EdoardoBaggio03/ControlloSerra/Immagini Tesi/Foto/DSC_0372.JPG

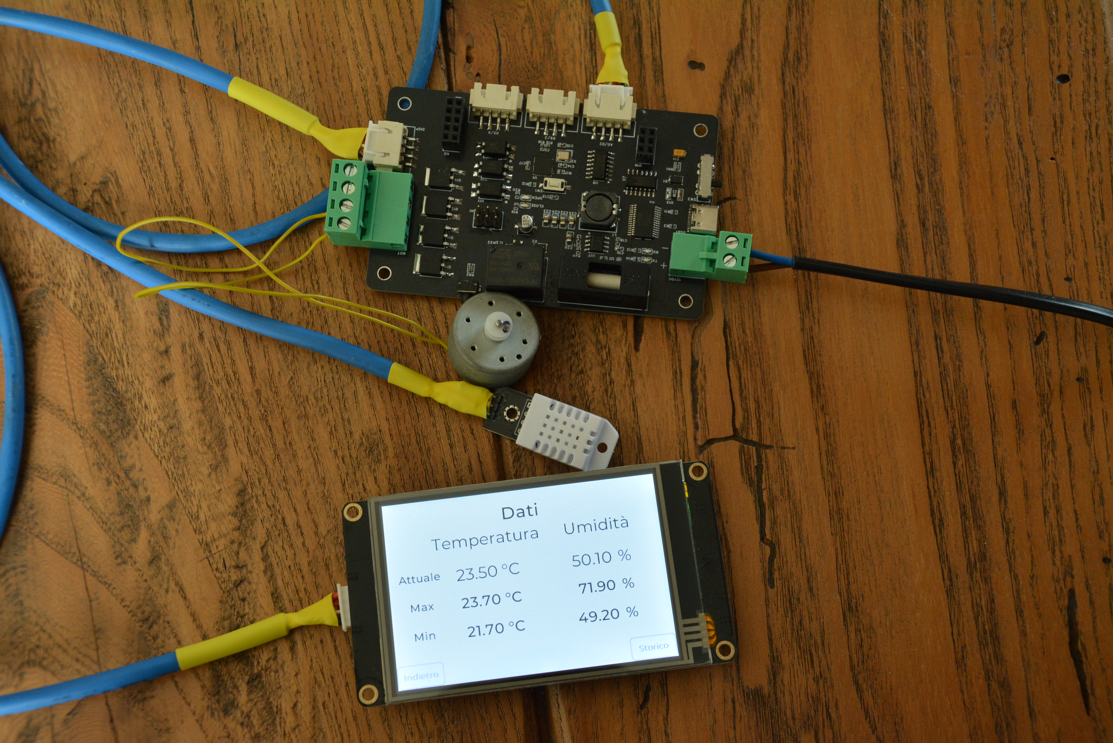
Immagini Tesi/Foto/DSC_0372.JPG
