EdoardoBaggio03/ControlloSerra/Immagini Tesi/Foto/IMG_0029.jpeg

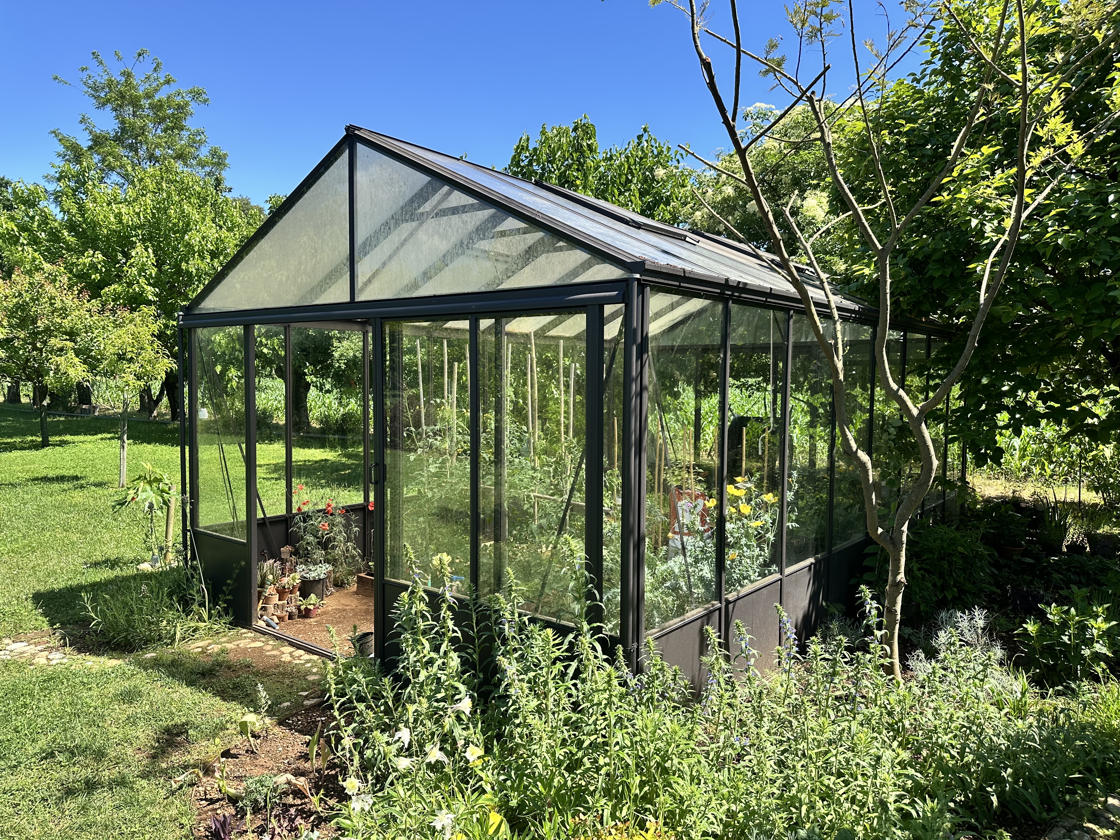
Immagini Tesi/Foto/IMG_0029.jpeg
