EdoardoBaggio03/ControlloSerra/template ITA slides_lauree triennali.pdf

Università degli Studi di Padova – Dipartimento di Ingegneria dell’Informazione
Corso di Laurea in |
Attenzione non mettere nome curriculum!!!!!

## Relazione per la prova finale «Titolo elaborato»

Relatore: Prof. …….
Correlatore: Prof./Dott. |
Laureand..: |
Matricola n.: |

Padova, …/…/202…….

INTRODUZIONE

OBIETTIVO DEL LAVORO

DESCRIZIONE DEL LAVORO

CONCLUSIONI
