EdoardoBaggio03/ControlloSerra/template-tesi-unipd-dei.pdf

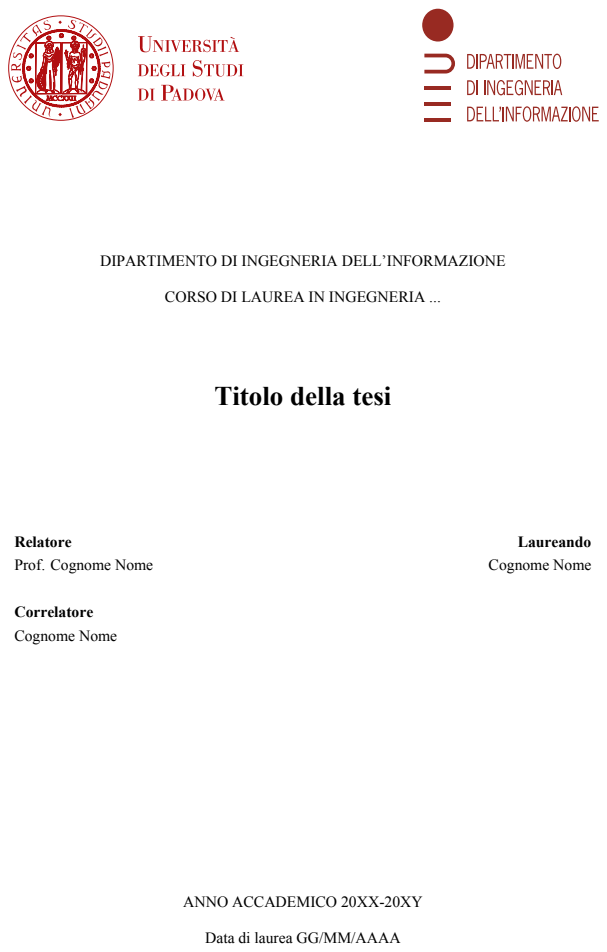
[picture p81: page 1]
Relatore; Laureando; Prof. Cognome Nome; Cognome Nome; Correlatore; ANNO ACCADEMICO 20XX-20XY

DIPARTIMENTO DI INGEGNERIA DELL’INFORMAZIONE

CORSO DI LAUREA IN INGEGNERIA ...

Titolo della tesi

Data di laurea GG/MM/AAAA

Apes. Together. Strong.

# Sommario

Descrizione dell’obiettivo della tesi.

v

vi

# Indice

1 Capitolo di prova | 1
Bibliografia | 3

vii

viii

# Elenco delle figure

ix

x

# Capitolo 1

# Capitolo di prova

Questo capitolo può servire come riferimento per alcuni comandi utili di LATEX.

## 1.1 Esempio di sezione

### 1.1.1 Esempio di sottosezione

The Lord of the Rings is one of these things: if you like it, you do;
if you don’t, then you boo! (J. R. R. Tolkien)

Questa qui sopra è una citazione. Bella, vero?
Questo è un riferimento: [1].
Questa è un’espressione matematica in riga: y = f(x). Questa è un’espressione matematica in un blocco a sé:
∫︂∞

−∞

e

−x

2
dx =

√
π | (1.1)

Questo è codice in riga: for(int i = 0; i < 1; i++);. Questo è un listato semplice,

estratto da The C programming language (1988), p. 6:

## #include <stdio.h>

## main( )

{
printf("hello, world\n");
}

1

Questo è un listato sbrilluccicoso:

## # can your editor do this? f(x) = m +

∑︂∞

k=1

Ak cos(kx − ϕk)

## import this

## print('hello, world')

2

# Bibliografia

[1] L. Lamport, LaTeX: A Document Preparation System. Addison-Wesley Publishing Company, 1986, isbn: 9780201157901.

3
