EdoardoBaggio03/ControlloSerra/3D/Case_PCB_2025-May-06_02-36-45PM-000_CustomizedView4439397485.png

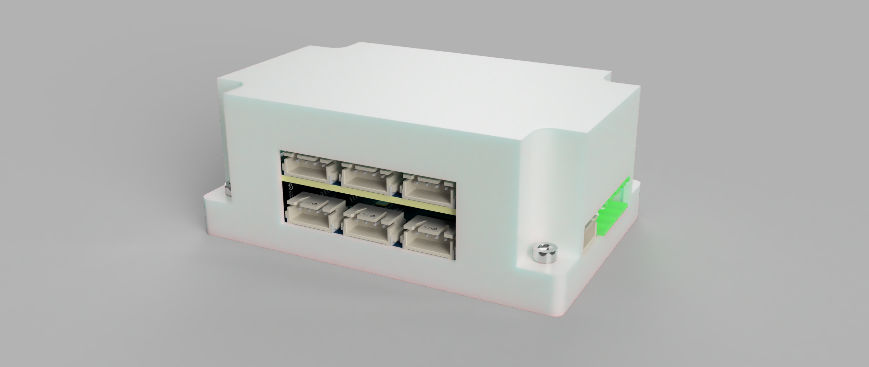
3D/Case_PCB_2025-May-06_02-36-45PM-000_CustomizedView4439397485.png
