EdoardoBaggio03/ControlloSerra/Display/Bottone Impostazioni.png

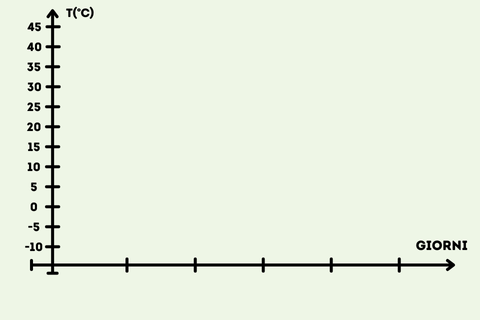
Display/Bottone Impostazioni.png
