EdoardoBaggio03/ControlloSerra/Display/Bottoni/63.png

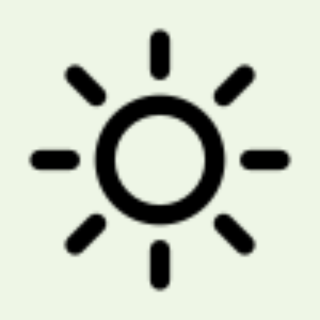
Display/Bottoni/63.png
