EdoardoBaggio03/ControlloSerra/Display/Bottoni/64.png

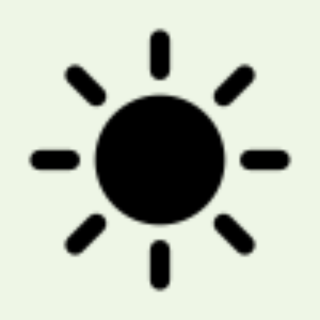
Display/Bottoni/64.png
