EdoardoBaggio03/ControlloSerra/Display/Bottoni/Bottone Dati.png

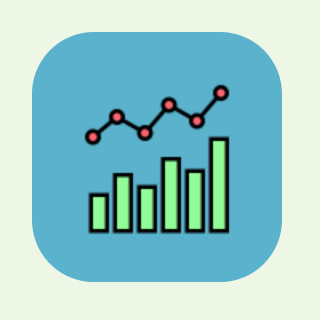
Display/Bottoni/Bottone Dati.png
