EdoardoBaggio03/ControlloSerra/Display/Bottoni/Bottone Home.png

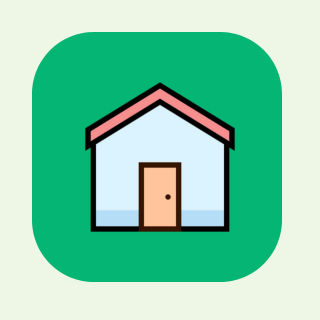
Display/Bottoni/Bottone Home.png
