EdoardoBaggio03/ControlloSerra/Display/Bottoni/Bottone Impostazioni.png

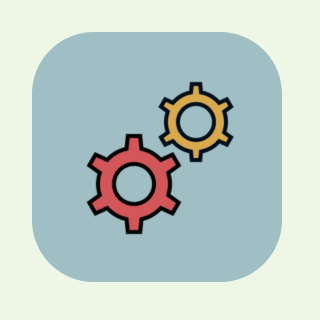
Display/Bottoni/Bottone Impostazioni.png
