EdoardoBaggio03/ControlloSerra/Display/Bottoni/Bottone Info.png

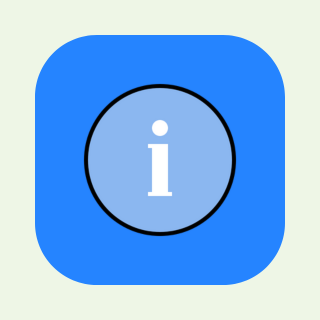
Display/Bottoni/Bottone Info.png
