EdoardoBaggio03/ControlloSerra/Display/Bottoni/Bottone Menu.png

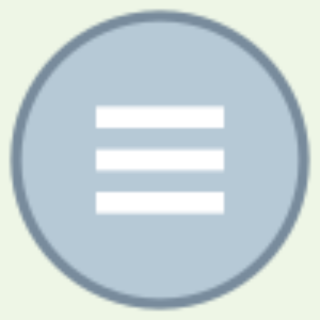
Display/Bottoni/Bottone Menu.png
