EdoardoBaggio03/ControlloSerra/Display/Bottoni/Bottone Occhio Chiuso.png

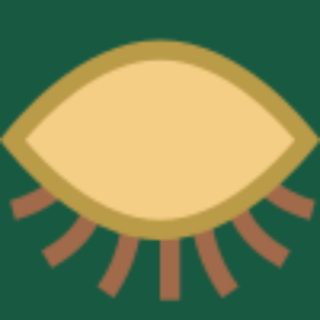
Display/Bottoni/Bottone Occhio Chiuso.png
