EdoardoBaggio03/ControlloSerra/Display/Bottoni/Bottone Occhio.png

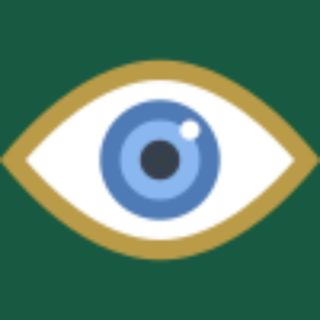
Display/Bottoni/Bottone Occhio.png
