EdoardoBaggio03/ControlloSerra/Display/Bottoni/Bottone Serra.png

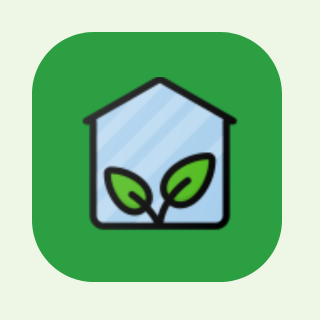
Display/Bottoni/Bottone Serra.png
