EdoardoBaggio03/ControlloSerra/Display/Bottoni/Bottone X Premuto.png

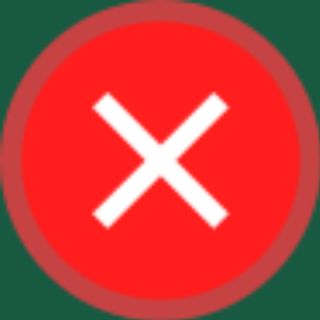
Display/Bottoni/Bottone X Premuto.png
