EdoardoBaggio03/ControlloSerra/Display/Bottoni/Bottone X.png

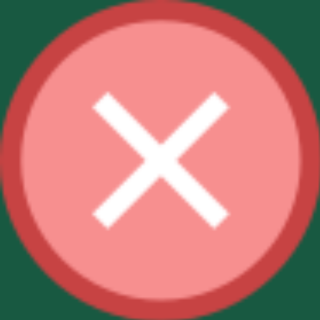
Display/Bottoni/Bottone X.png
