EdoardoBaggio03/ControlloSerra/Display/Bottoni/Bottoni Trans/1.png

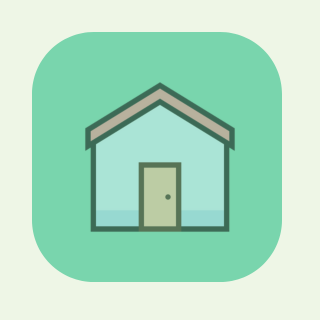
Display/Bottoni/Bottoni Trans/1.png
