EdoardoBaggio03/ControlloSerra/Display/Bottoni/Bottoni Trans/4.png

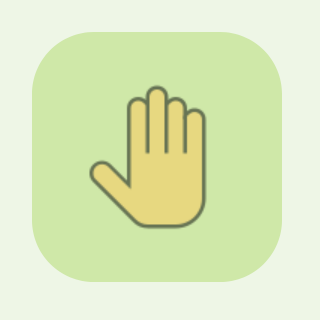
Display/Bottoni/Bottoni Trans/4.png
