EdoardoBaggio03/ControlloSerra/Display/Bottoni/Bottoni Trans/5.png

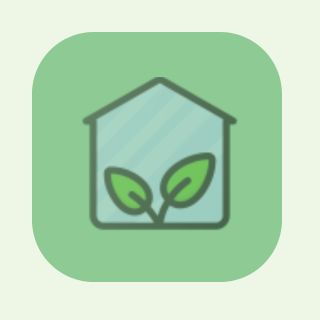
Display/Bottoni/Bottoni Trans/5.png
