EdoardoBaggio03/ControlloSerra/Display/Bottoni/Bottoni Trans/7.png

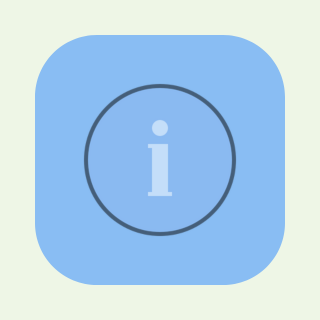
Display/Bottoni/Bottoni Trans/7.png
