EdoardoBaggio03/ControlloSerra/Display/Bottoni/Bottoni Trans/51.png

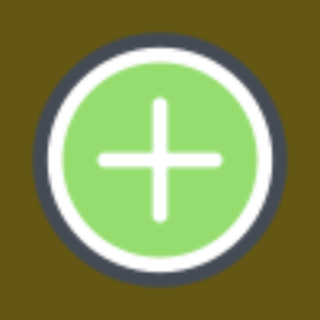
Display/Bottoni/Bottoni Trans/51.png
