EdoardoBaggio03/ControlloSerra/Display/Bottoni/Bottoni Trans/53.png

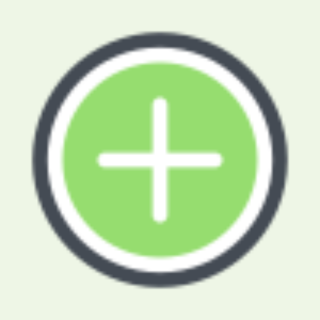
Display/Bottoni/Bottoni Trans/53.png
