EdoardoBaggio03/ControlloSerra/Display/Bottoni/Bottoni Trans/55.png

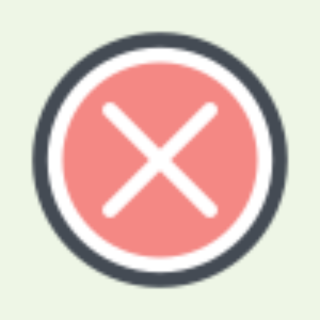
Display/Bottoni/Bottoni Trans/55.png
