EdoardoBaggio03/ControlloSerra/Display/Bottoni/Bottoni Trans/57.png

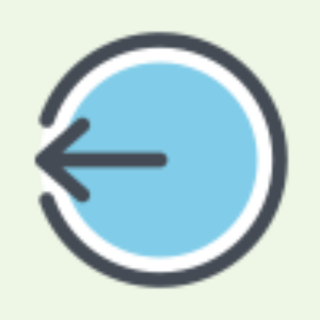
Display/Bottoni/Bottoni Trans/57.png
