EdoardoBaggio03/ControlloSerra/Display/Bottoni/Bottoni Trans/59.png

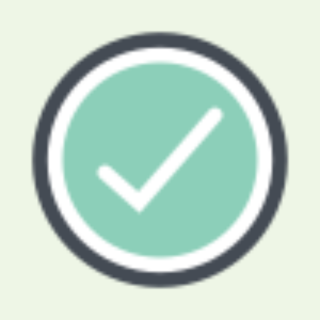
Display/Bottoni/Bottoni Trans/59.png
