EdoardoBaggio03/ControlloSerra/Display/Bottoni/Bottoni Trans/Bottone Impostazioni giu.png

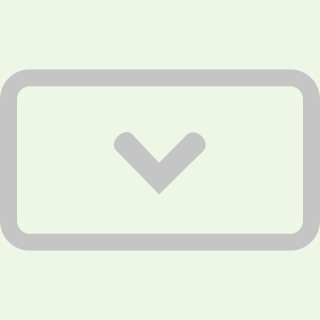
Display/Bottoni/Bottoni Trans/Bottone Impostazioni giu.png
