EdoardoBaggio03/ControlloSerra/Display/Bottoni/Bottoni Trans/Bottone Impostazioni su.png

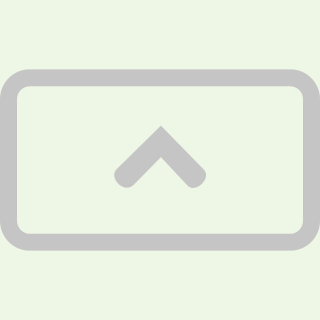
Display/Bottoni/Bottoni Trans/Bottone Impostazioni su.png
