EdoardoBaggio03/ControlloSerra/Display/Bottoni/Bottoni Trans/Bottone Impostazioni.png

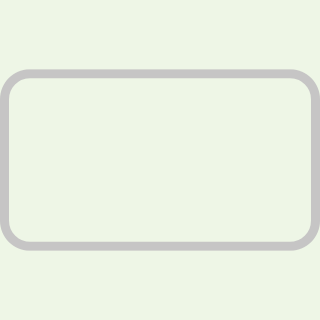
Display/Bottoni/Bottoni Trans/Bottone Impostazioni.png
