EdoardoBaggio03/ControlloSerra/Display/Bottoni/down imp.png

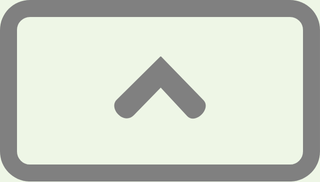
Display/Bottoni/down imp.png
