EdoardoBaggio03/ControlloSerra/Display/Bottoni/slider handle.png

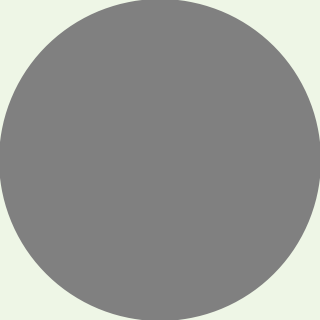
Display/Bottoni/slider handle.png
