EdoardoBaggio03/ControlloSerra/Display/Bottoni/slider.png

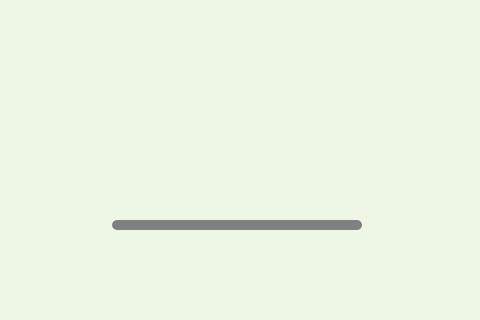
Display/Bottoni/slider.png
