EdoardoBaggio03/ControlloSerra/Display/Bottoni/up imp.png

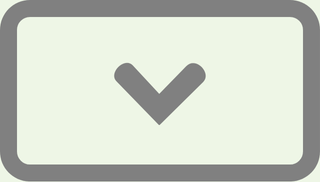
Display/Bottoni/up imp.png
