EdoardoBaggio03/ControlloSerra/Display/Bottoni/Verdure/14.png

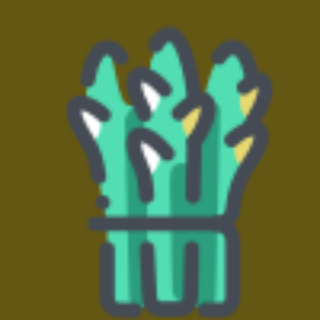
Display/Bottoni/Verdure/14.png
