EdoardoBaggio03/ControlloSerra/Display/Bottoni/Verdure/15.png

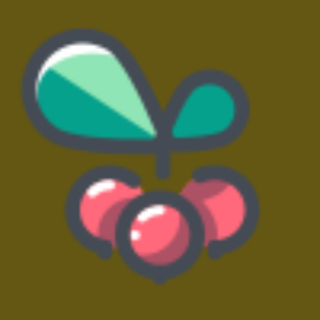
Display/Bottoni/Verdure/15.png
