EdoardoBaggio03/ControlloSerra/Display/Bottoni/Verdure/16.png

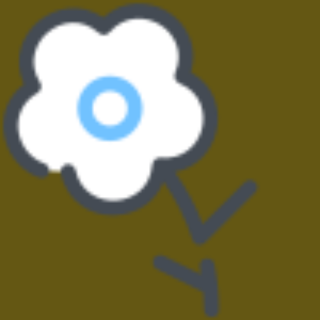
Display/Bottoni/Verdure/16.png
