EdoardoBaggio03/ControlloSerra/Display/Bottoni/Verdure/17.png

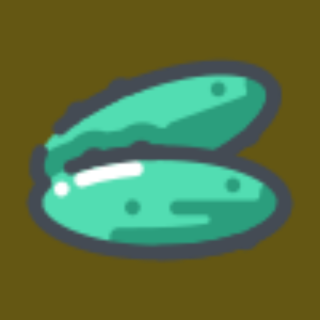
Display/Bottoni/Verdure/17.png
