EdoardoBaggio03/ControlloSerra/Display/Bottoni/Verdure/18.png

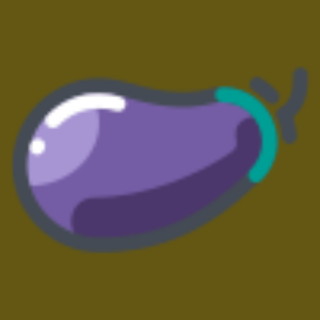
Display/Bottoni/Verdure/18.png
