EdoardoBaggio03/ControlloSerra/Display/Bottoni/Verdure/19.png

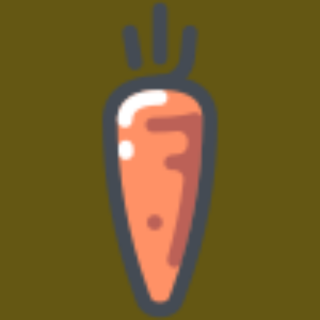
Display/Bottoni/Verdure/19.png
