EdoardoBaggio03/ControlloSerra/Display/Bottoni/Verdure/20.png

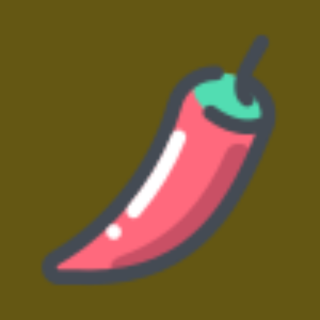
Display/Bottoni/Verdure/20.png
