EdoardoBaggio03/ControlloSerra/Display/Bottoni/Verdure/21.png

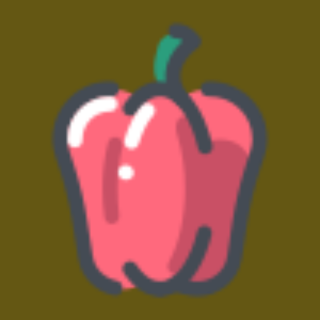
Display/Bottoni/Verdure/21.png
