EdoardoBaggio03/ControlloSerra/Display/Bottoni/Verdure/22.png

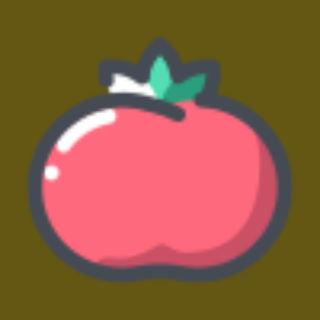
Display/Bottoni/Verdure/22.png
