EdoardoBaggio03/ControlloSerra/Display/Bottoni/Verdure/23.png

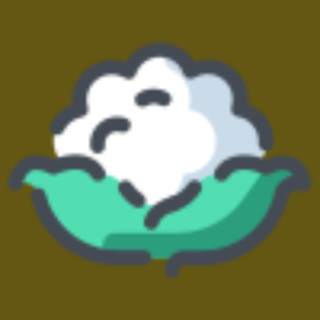
Display/Bottoni/Verdure/23.png
