EdoardoBaggio03/ControlloSerra/Display/Bottoni/Verdure/24.png

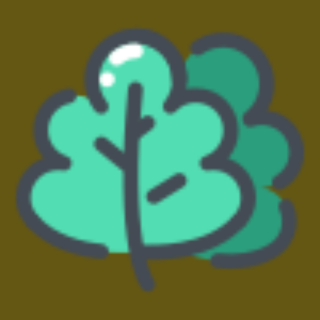
Display/Bottoni/Verdure/24.png
