EdoardoBaggio03/ControlloSerra/Display/Bottoni/Verdure/25.png

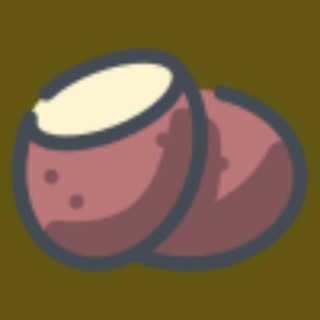
Display/Bottoni/Verdure/25.png
