EdoardoBaggio03/ControlloSerra/Display/Bottoni/Verdure/26.png

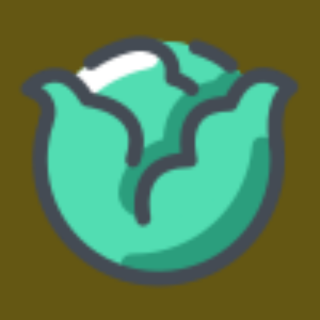
Display/Bottoni/Verdure/26.png
