EdoardoBaggio03/ControlloSerra/Display/Bottoni/Verdure/27.png

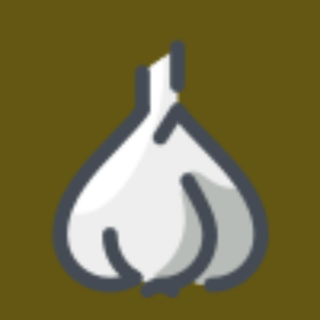
Display/Bottoni/Verdure/27.png
