EdoardoBaggio03/ControlloSerra/Display/Bottoni/Verdure/28.png

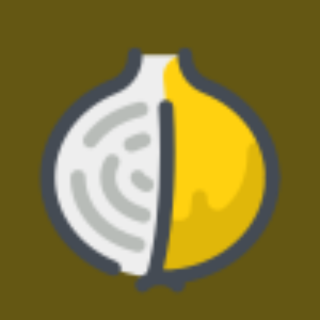
Display/Bottoni/Verdure/28.png
