EdoardoBaggio03/ControlloSerra/Display/Bottoni/Verdure/29.png

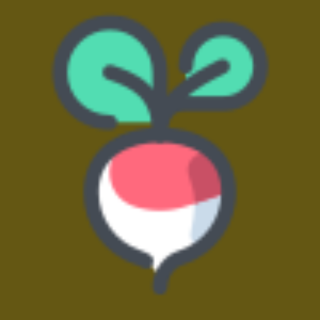
Display/Bottoni/Verdure/29.png
