EdoardoBaggio03/ControlloSerra/Display/Bottoni/Verdure/30.png

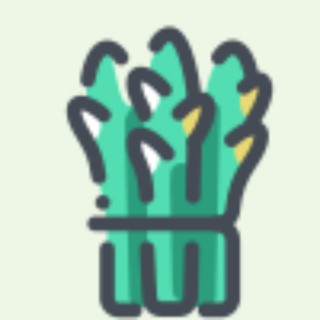
Display/Bottoni/Verdure/30.png
