EdoardoBaggio03/ControlloSerra/Display/Bottoni/Verdure/31.png

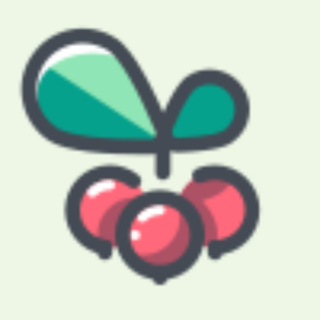
Display/Bottoni/Verdure/31.png
