EdoardoBaggio03/ControlloSerra/Display/Bottoni/Verdure/32.png

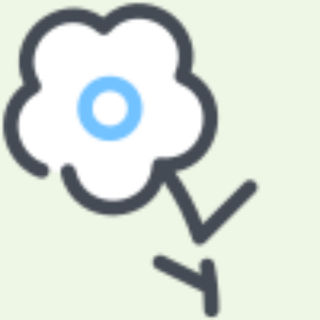
Display/Bottoni/Verdure/32.png
