EdoardoBaggio03/ControlloSerra/Display/Bottoni/Verdure/33.png

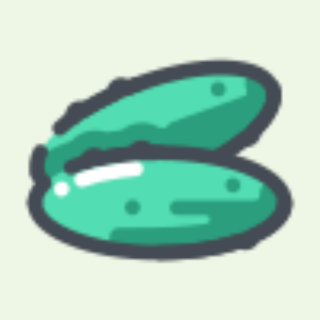
Display/Bottoni/Verdure/33.png
