EdoardoBaggio03/ControlloSerra/Display/Bottoni/Verdure/34.png

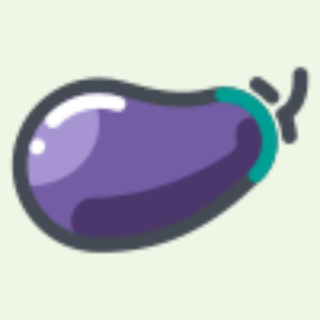
Display/Bottoni/Verdure/34.png
