EdoardoBaggio03/ControlloSerra/Display/Bottoni/Verdure/35.png

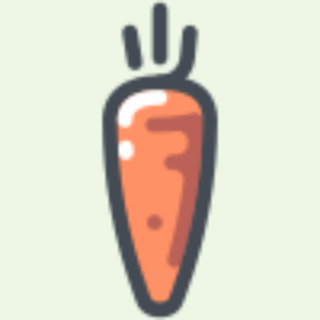
Display/Bottoni/Verdure/35.png
