EdoardoBaggio03/ControlloSerra/Display/Bottoni/Verdure/36.png

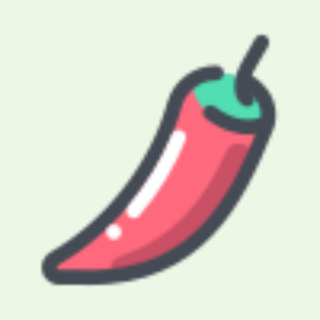
Display/Bottoni/Verdure/36.png
