EdoardoBaggio03/ControlloSerra/Display/Bottoni/Verdure/37.png

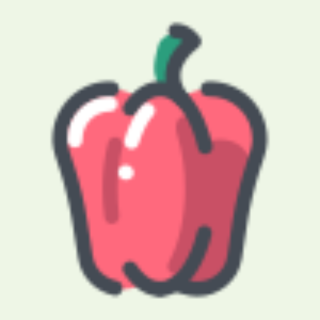
Display/Bottoni/Verdure/37.png
