EdoardoBaggio03/ControlloSerra/Display/Bottoni/Verdure/38.png

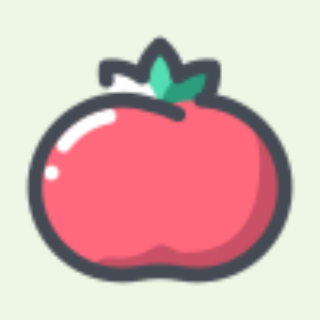
Display/Bottoni/Verdure/38.png
