EdoardoBaggio03/ControlloSerra/Display/Bottoni/Verdure/39.png

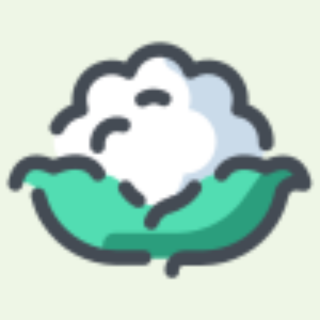
Display/Bottoni/Verdure/39.png
