EdoardoBaggio03/ControlloSerra/Display/Bottoni/Verdure/40.png

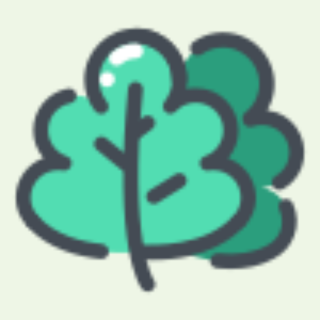
Display/Bottoni/Verdure/40.png
