EdoardoBaggio03/ControlloSerra/Display/Bottoni/Verdure/41.png

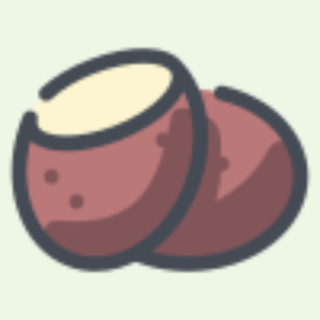
Display/Bottoni/Verdure/41.png
