EdoardoBaggio03/ControlloSerra/Display/Bottoni/Verdure/42.png

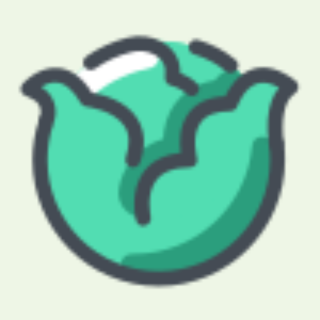
Display/Bottoni/Verdure/42.png
