EdoardoBaggio03/ControlloSerra/Display/Bottoni/Verdure/43.png

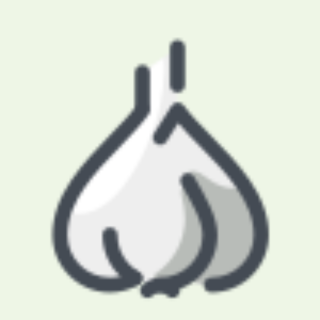
Display/Bottoni/Verdure/43.png
