EdoardoBaggio03/ControlloSerra/Display/Bottoni/Verdure/44.png

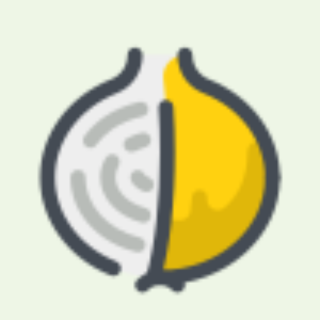
Display/Bottoni/Verdure/44.png
