EdoardoBaggio03/ControlloSerra/Display/Bottoni/Verdure/45.png

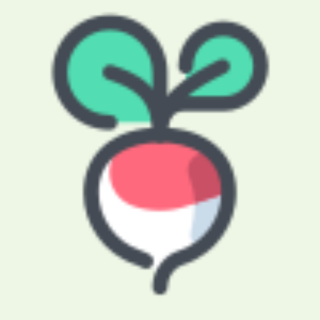
Display/Bottoni/Verdure/45.png
