EdoardoBaggio03/ControlloSerra/Display/Bottoni/Verdure/46.png

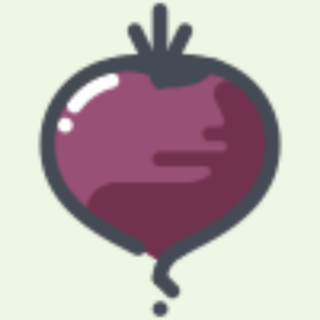
Display/Bottoni/Verdure/46.png
