EdoardoBaggio03/ControlloSerra/Display/Bottoni/Verdure/47.png

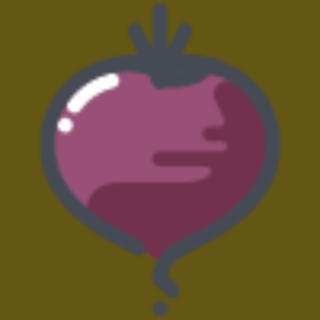
Display/Bottoni/Verdure/47.png
