EdoardoBaggio03/ControlloSerra/Display/Bottoni/Verdure/48.png

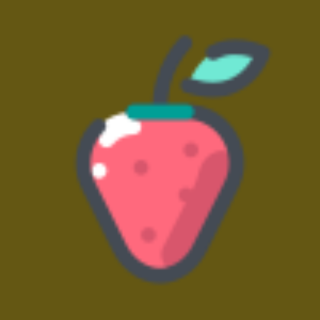
Display/Bottoni/Verdure/48.png
