EdoardoBaggio03/ControlloSerra/Display/Bottoni/Verdure/49.png

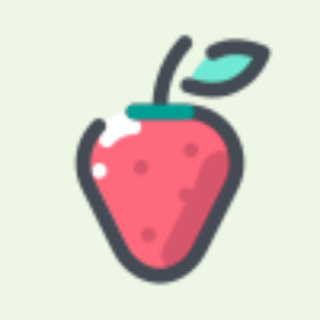
Display/Bottoni/Verdure/49.png
