EdoardoBaggio03/ControlloSerra/Display/Bottoni/Verdure/Bottone Impostazioni.png

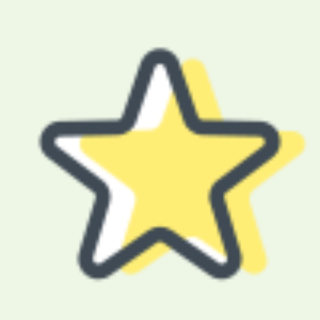
Display/Bottoni/Verdure/Bottone Impostazioni.png
