EdoardoBaggio03/ControlloSerra/Immagini Tesi/Bibliografia e Sitografia.png

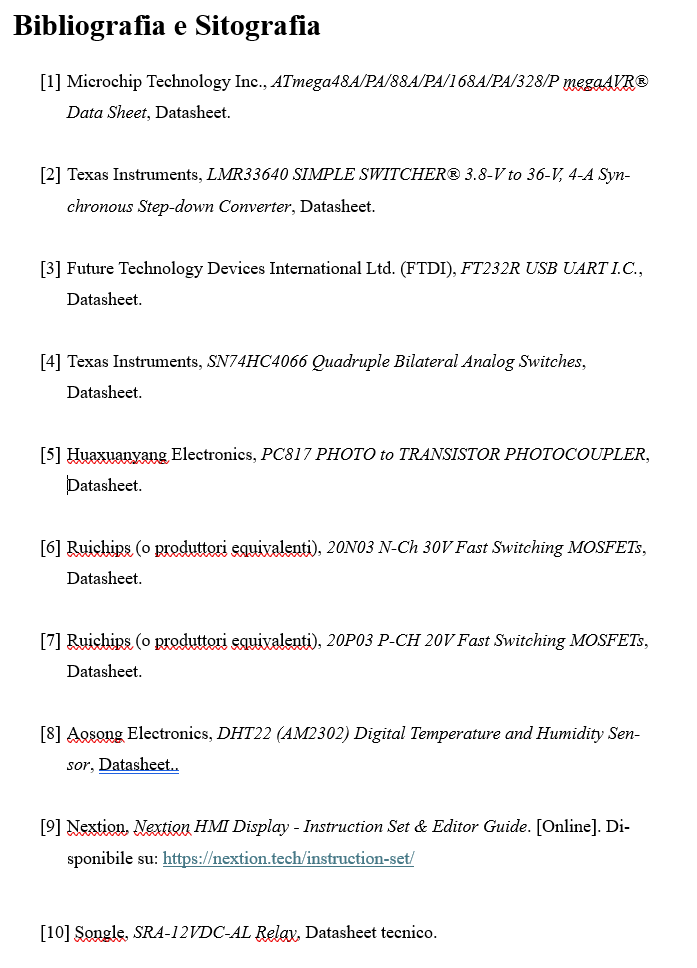
Immagini Tesi/Bibliografia e Sitografia.png
