EdoardoBaggio03/ControlloSerra/Immagini Tesi/Flow chart.png

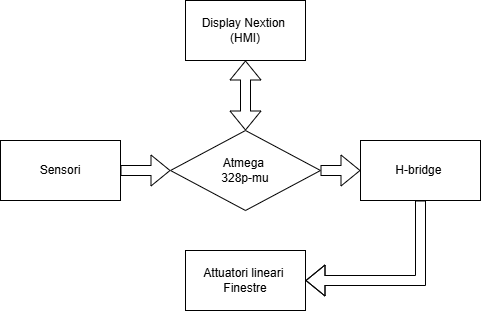
Immagini Tesi/Flow chart.png
