EdoardoBaggio03/ControlloSerra/Immagini Tesi/Flowchart Switching UART.png

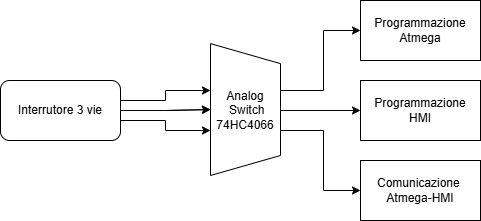
Immagini Tesi/Flowchart Switching UART.png
