EdoardoBaggio03/ControlloSerra/Immagini Tesi/Foto/DSC_0318.JPG

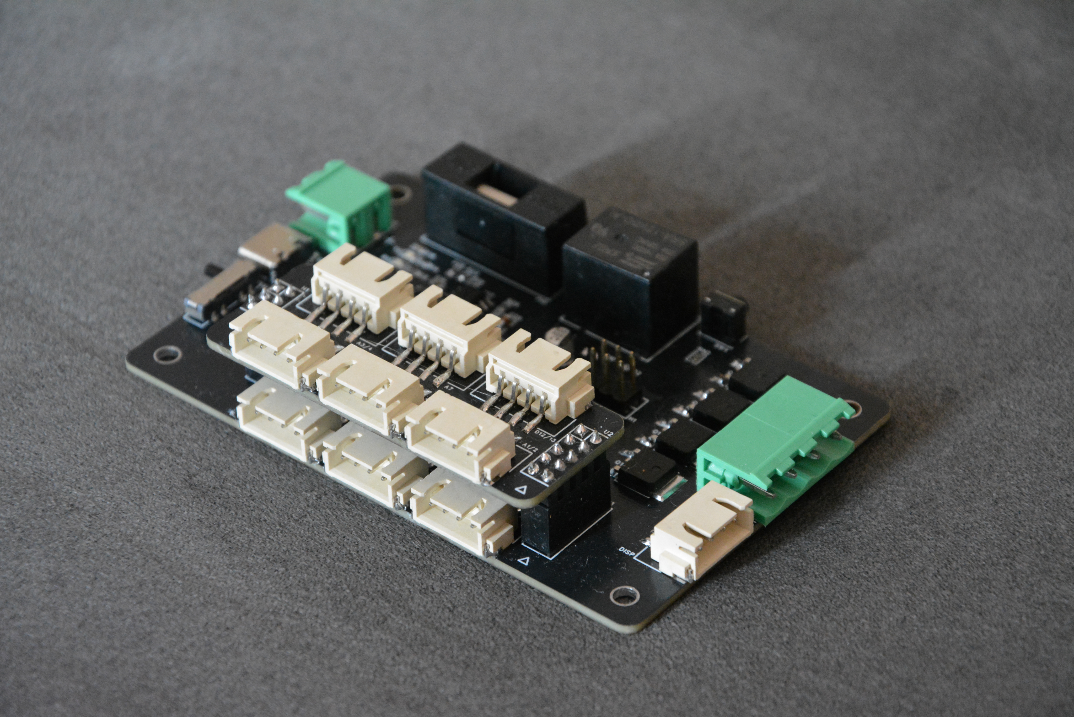
Immagini Tesi/Foto/DSC_0318.JPG
