EdoardoBaggio03/ControlloSerra/Immagini Tesi/Foto/DSC_0319.JPG

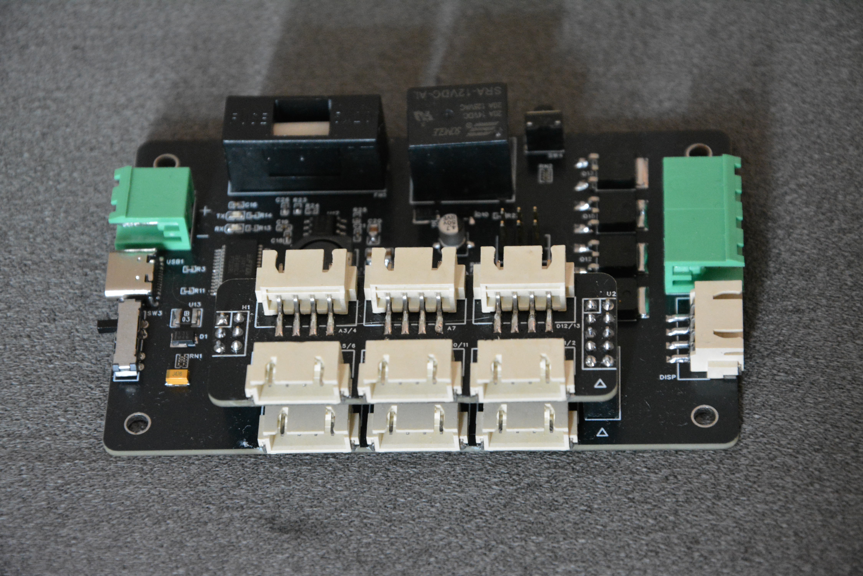
Immagini Tesi/Foto/DSC_0319.JPG
