EdoardoBaggio03/ControlloSerra/Immagini Tesi/Foto/DSC_0320.JPG

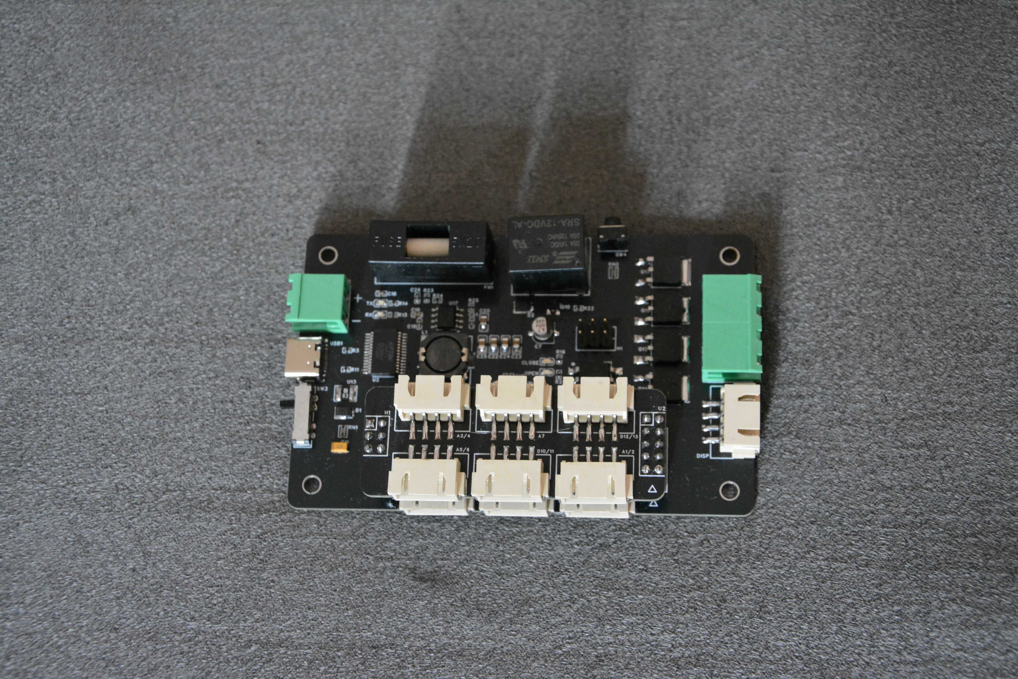
Immagini Tesi/Foto/DSC_0320.JPG
