EdoardoBaggio03/ControlloSerra/Immagini Tesi/Foto/DSC_0321.JPG

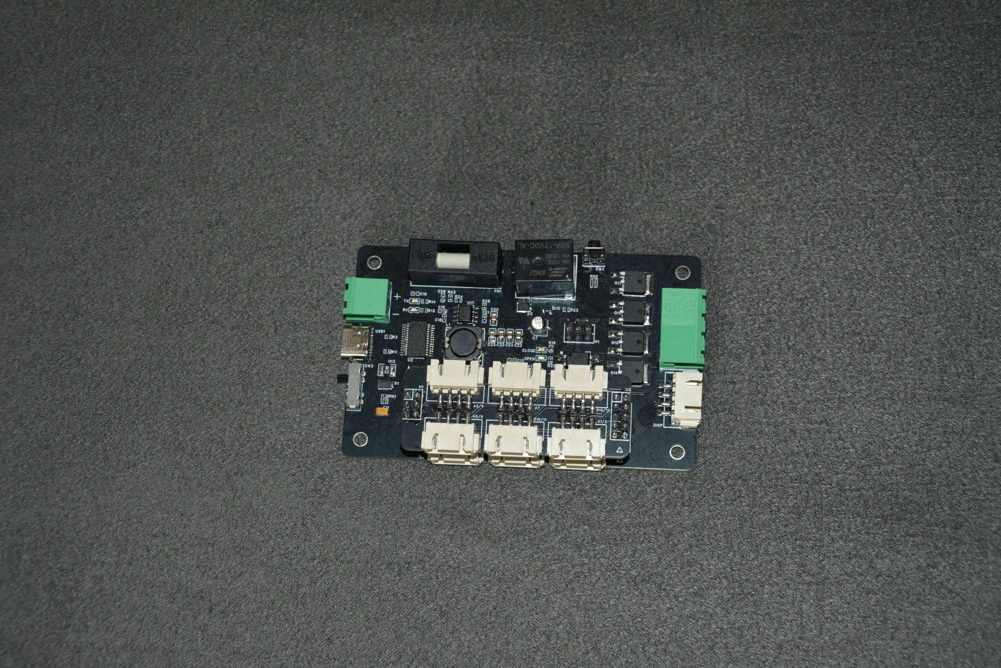
Immagini Tesi/Foto/DSC_0321.JPG
