EdoardoBaggio03/ControlloSerra/Immagini Tesi/Foto/DSC_0322.JPG

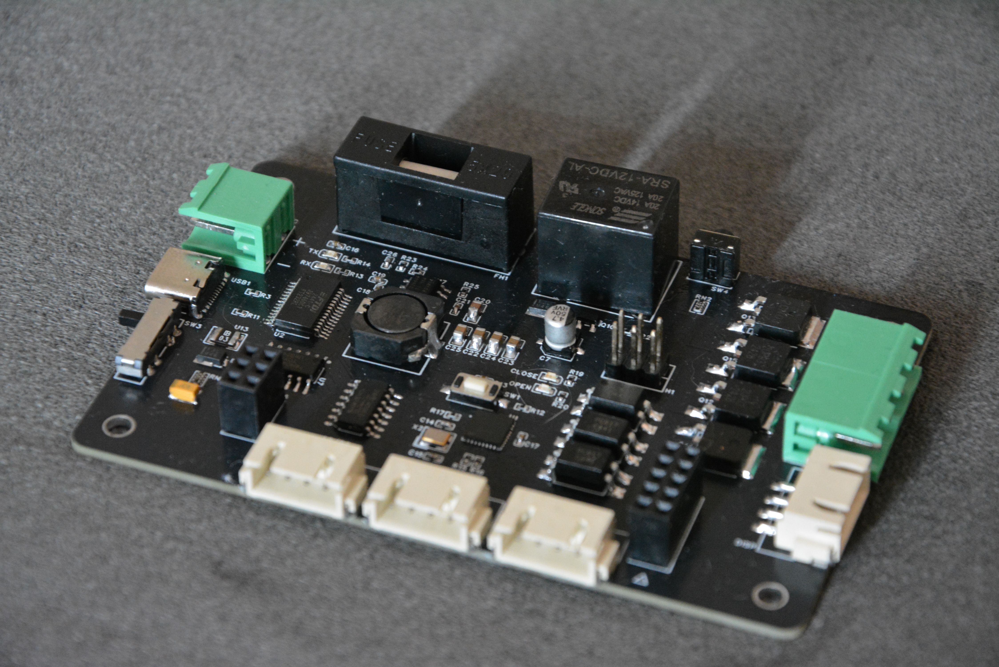
Immagini Tesi/Foto/DSC_0322.JPG
