EdoardoBaggio03/ControlloSerra/Immagini Tesi/Foto/DSC_0323.JPG

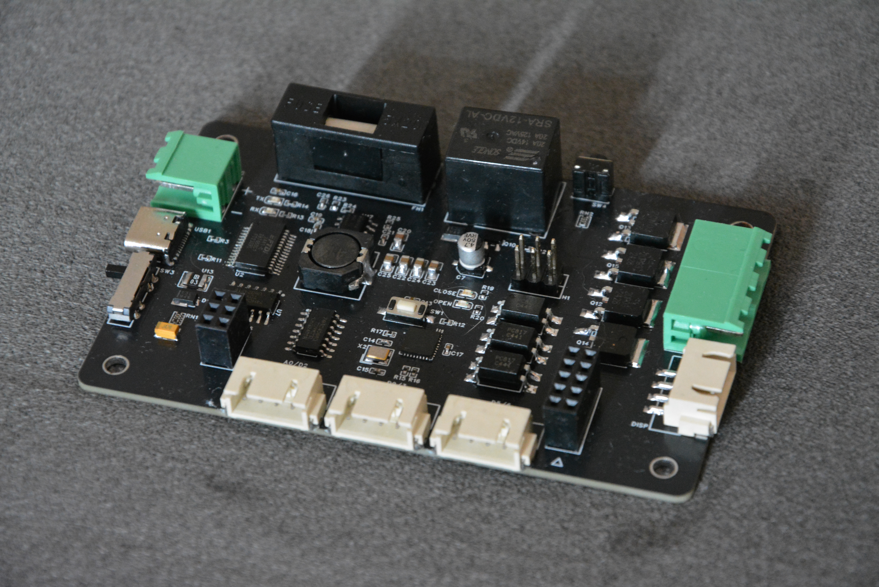
Immagini Tesi/Foto/DSC_0323.JPG
