EdoardoBaggio03/ControlloSerra/Immagini Tesi/Foto/DSC_0324.JPG

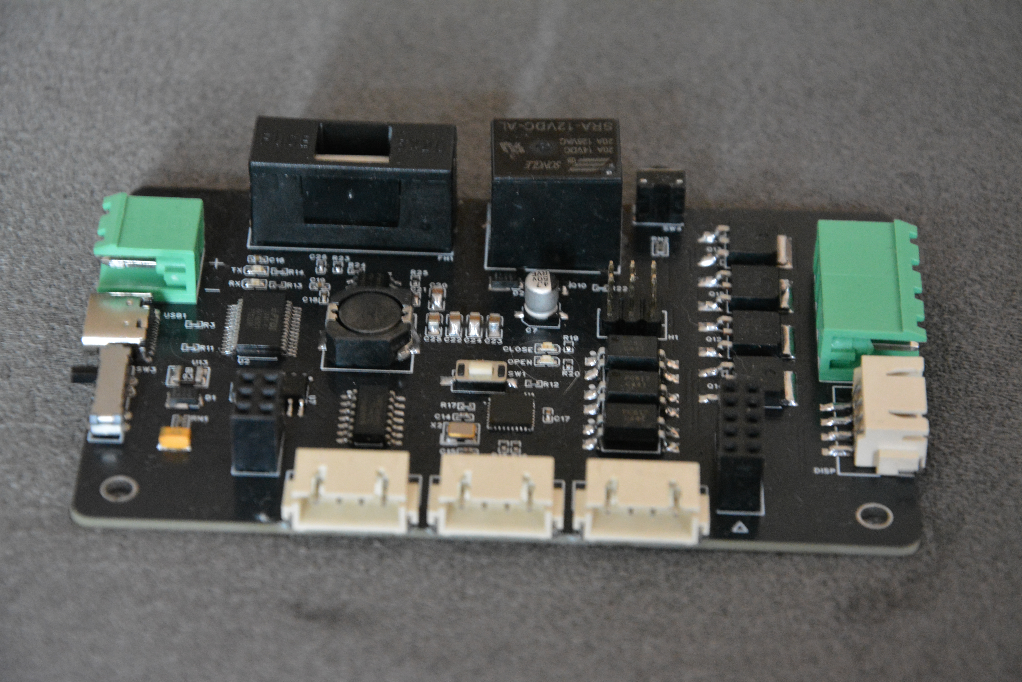
Immagini Tesi/Foto/DSC_0324.JPG
