EdoardoBaggio03/ControlloSerra/Immagini Tesi/Foto/DSC_0325.JPG

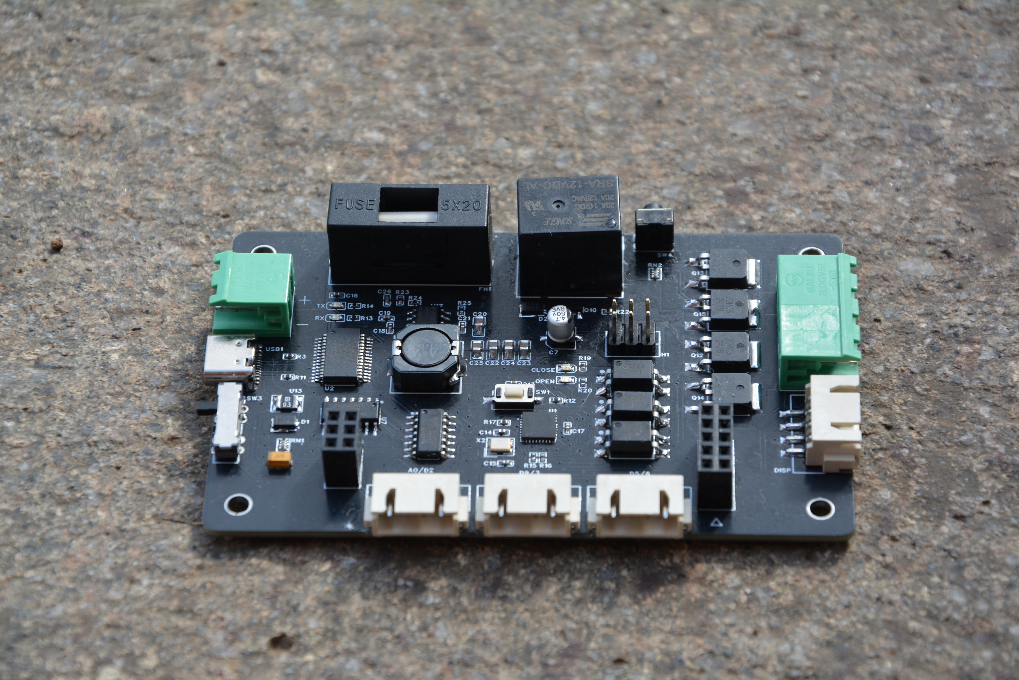
Immagini Tesi/Foto/DSC_0325.JPG
