EdoardoBaggio03/ControlloSerra/Immagini Tesi/Foto/DSC_0326.JPG

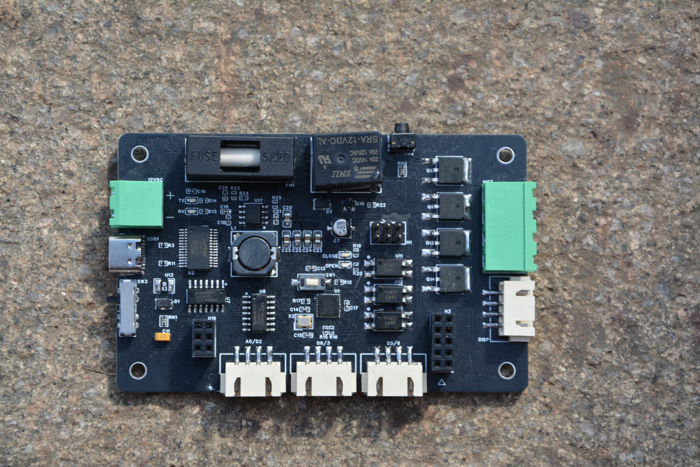
Immagini Tesi/Foto/DSC_0326.JPG
