EdoardoBaggio03/ControlloSerra/Immagini Tesi/Foto/DSC_0327.JPG

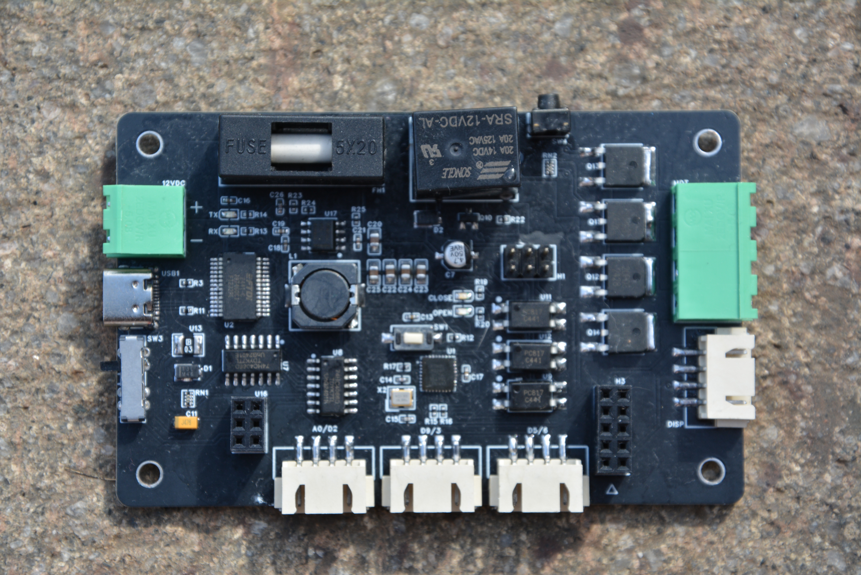
Immagini Tesi/Foto/DSC_0327.JPG
