EdoardoBaggio03/ControlloSerra/Immagini Tesi/Foto/DSC_0328.JPG

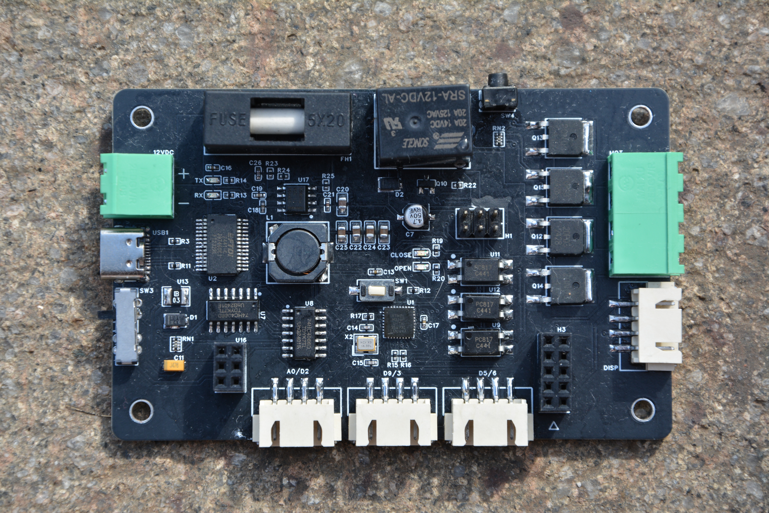
Immagini Tesi/Foto/DSC_0328.JPG
