EdoardoBaggio03/ControlloSerra/Immagini Tesi/Foto/DSC_0329.JPG

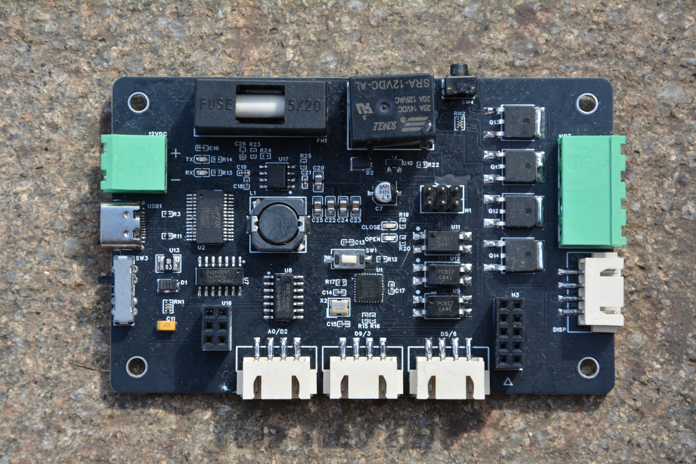
Immagini Tesi/Foto/DSC_0329.JPG
