EdoardoBaggio03/ControlloSerra/Immagini Tesi/Foto/DSC_0330.JPG

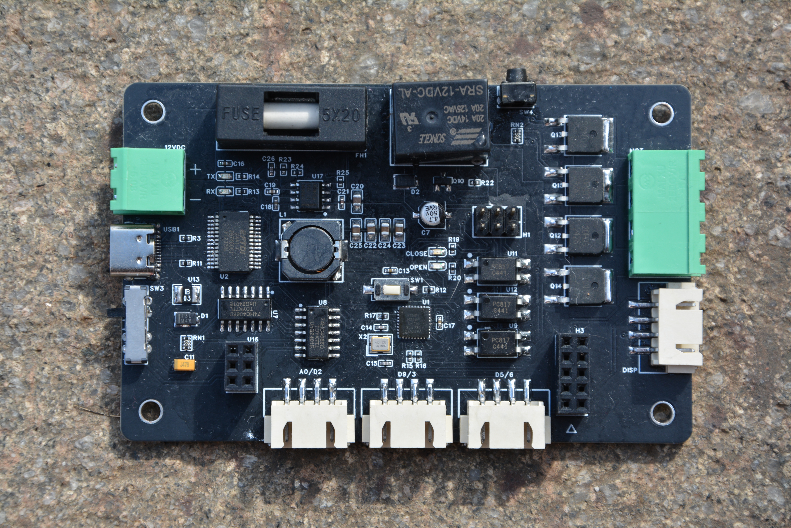
Immagini Tesi/Foto/DSC_0330.JPG
