EdoardoBaggio03/ControlloSerra/Immagini Tesi/Foto/DSC_0333.JPG

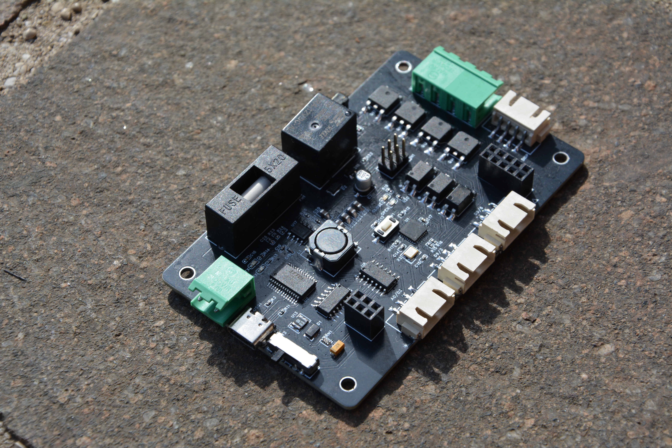
Immagini Tesi/Foto/DSC_0333.JPG
