EdoardoBaggio03/ControlloSerra/Immagini Tesi/Foto/DSC_0334.JPG

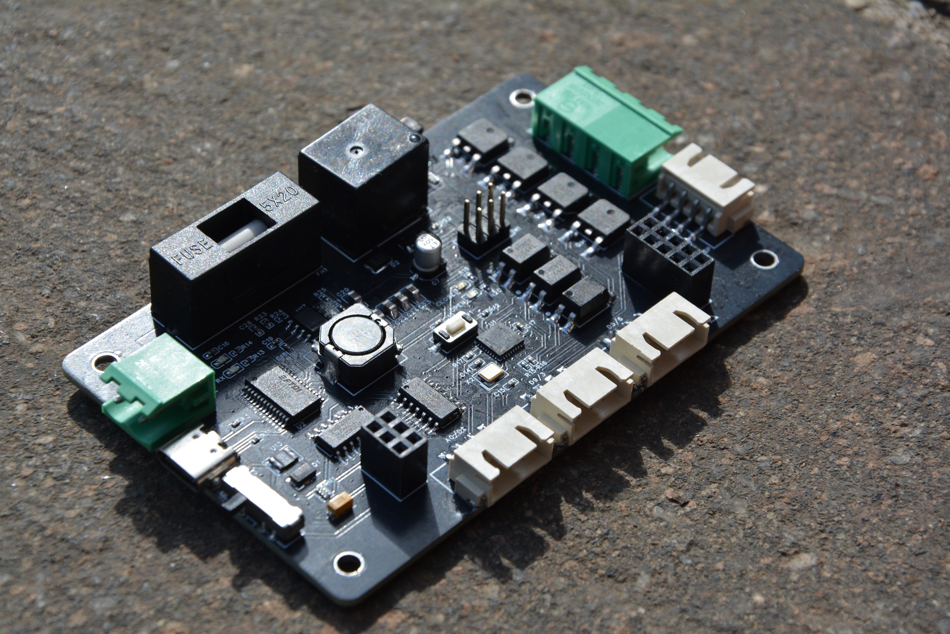
Immagini Tesi/Foto/DSC_0334.JPG
