EdoardoBaggio03/ControlloSerra/Immagini Tesi/Foto/DSC_0335.JPG

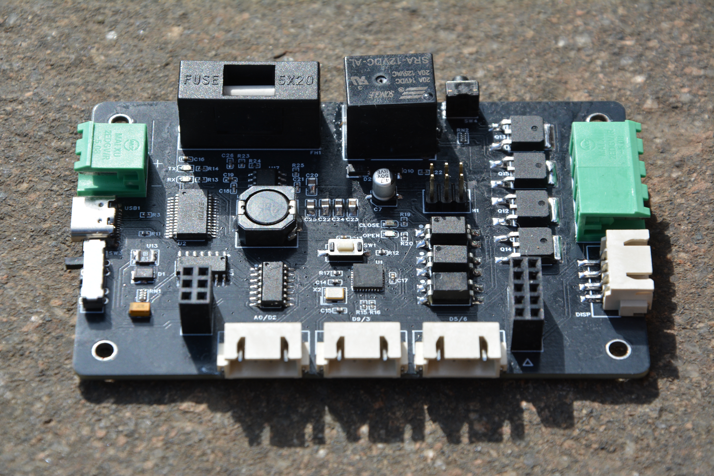
Immagini Tesi/Foto/DSC_0335.JPG
