EdoardoBaggio03/ControlloSerra/Immagini Tesi/Foto/DSC_0336.JPG

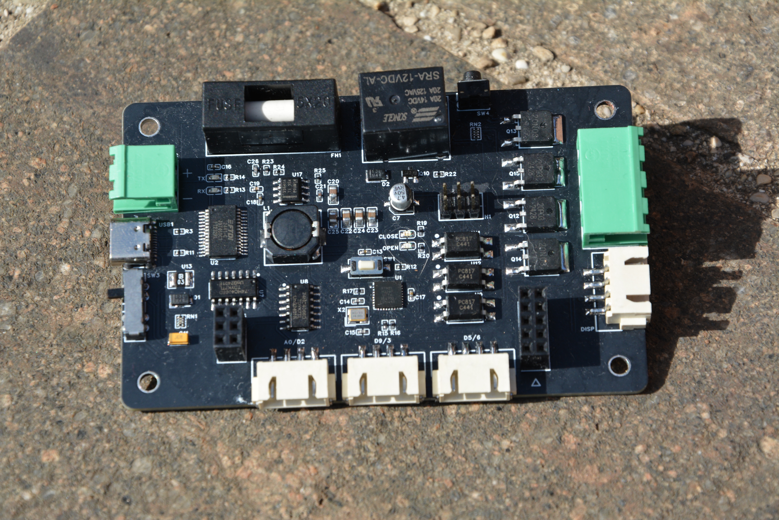
Immagini Tesi/Foto/DSC_0336.JPG
