EdoardoBaggio03/ControlloSerra/Immagini Tesi/Foto/DSC_0337.JPG

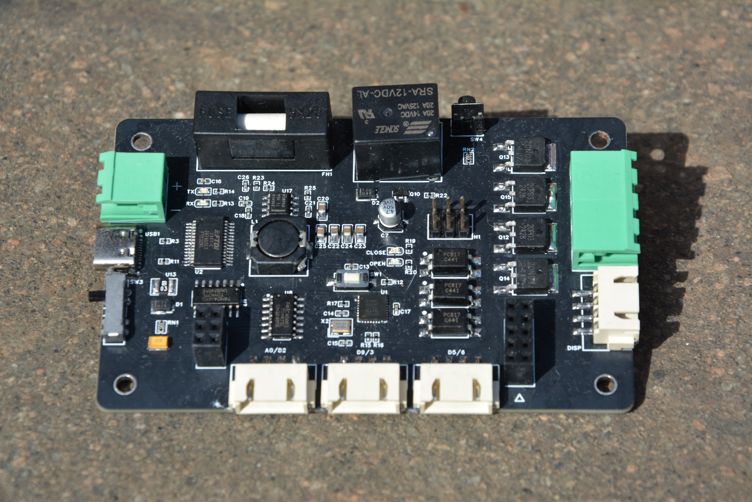
Immagini Tesi/Foto/DSC_0337.JPG
