EdoardoBaggio03/ControlloSerra/Immagini Tesi/Foto/DSC_0338.JPG

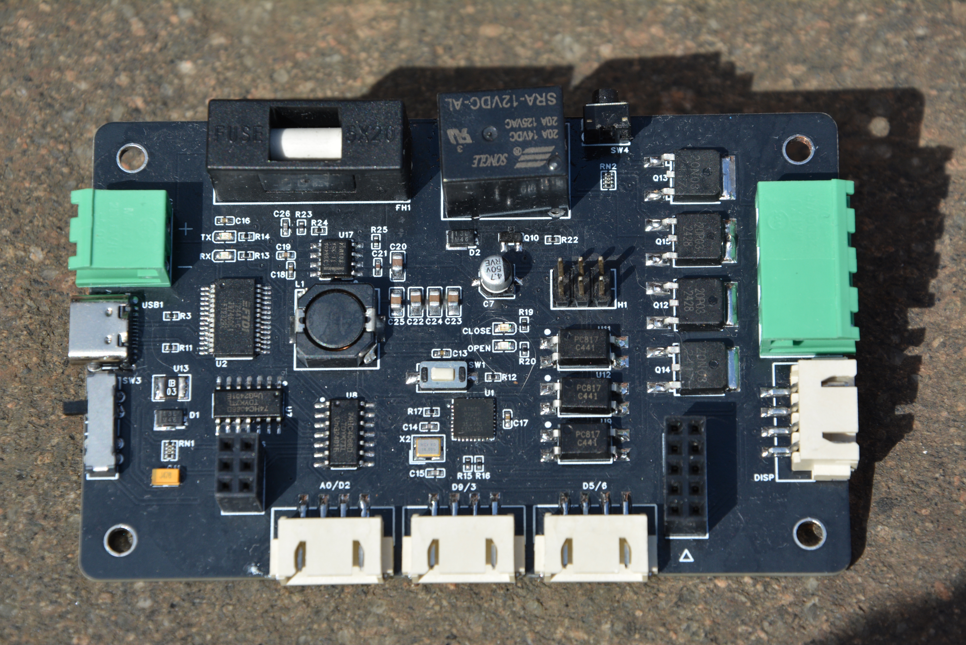
Immagini Tesi/Foto/DSC_0338.JPG
