EdoardoBaggio03/ControlloSerra/Immagini Tesi/Foto/DSC_0340.JPG

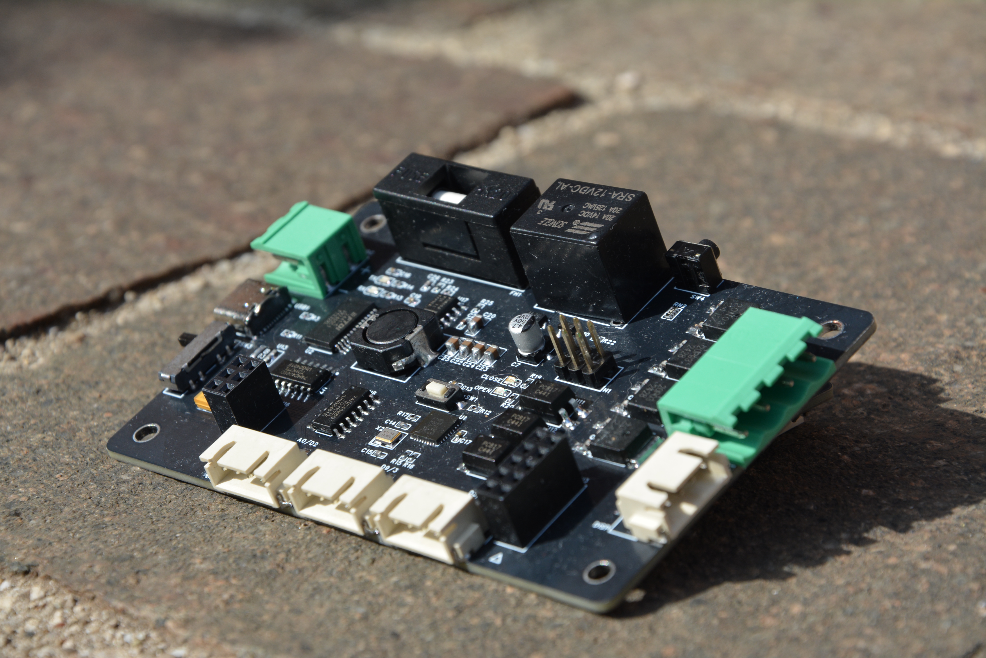
Immagini Tesi/Foto/DSC_0340.JPG
