EdoardoBaggio03/ControlloSerra/Immagini Tesi/Foto/DSC_0341.JPG

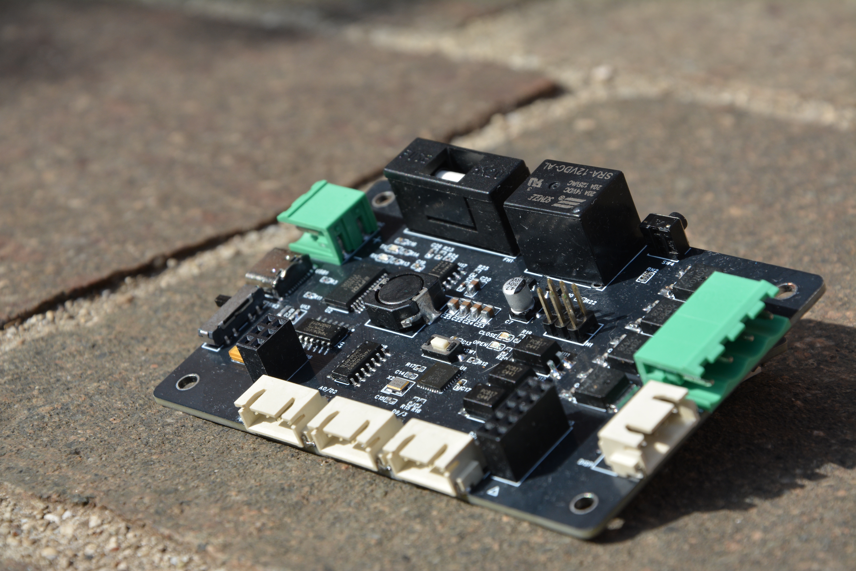
Immagini Tesi/Foto/DSC_0341.JPG
