EdoardoBaggio03/ControlloSerra/Immagini Tesi/Foto/DSC_0342.JPG

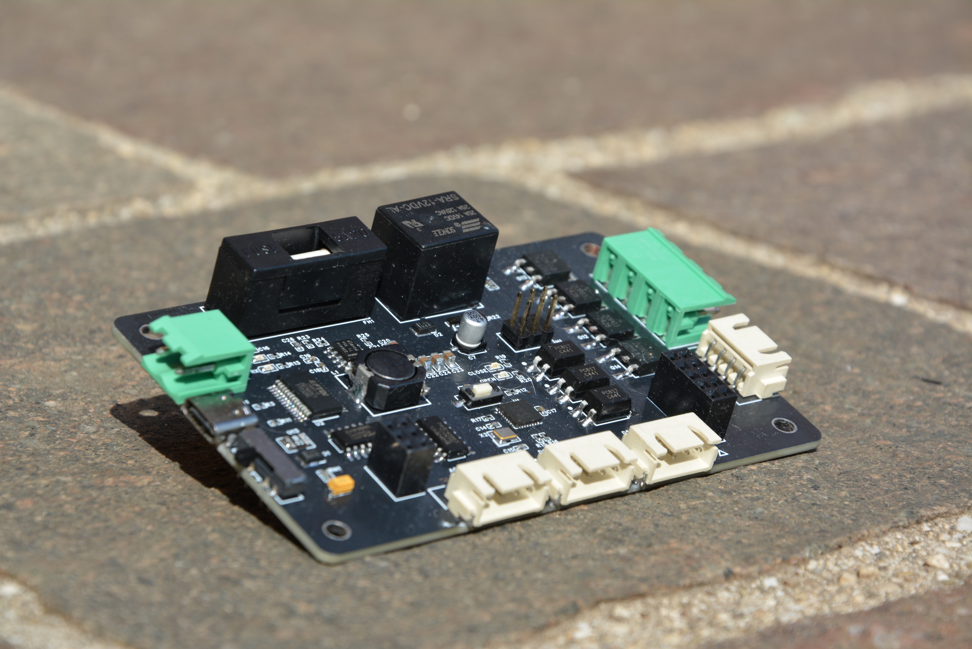
Immagini Tesi/Foto/DSC_0342.JPG
