EdoardoBaggio03/ControlloSerra/Immagini Tesi/Foto/DSC_0343.JPG

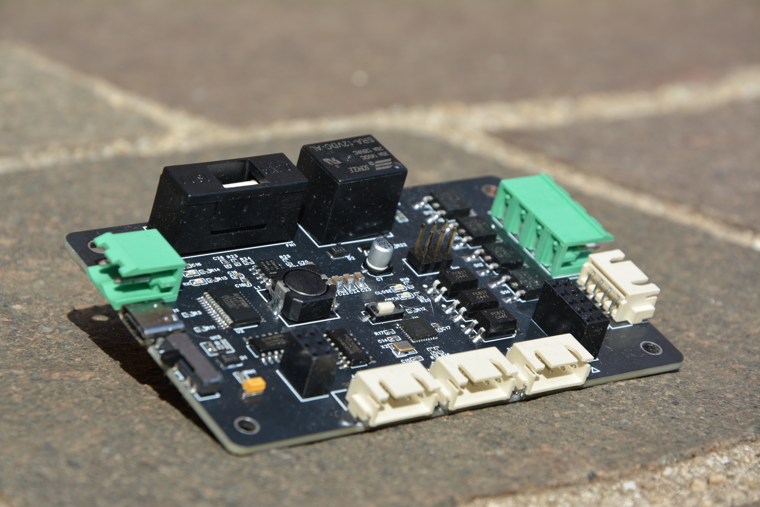
Immagini Tesi/Foto/DSC_0343.JPG
