EdoardoBaggio03/ControlloSerra/Immagini Tesi/Foto/DSC_0344.JPG

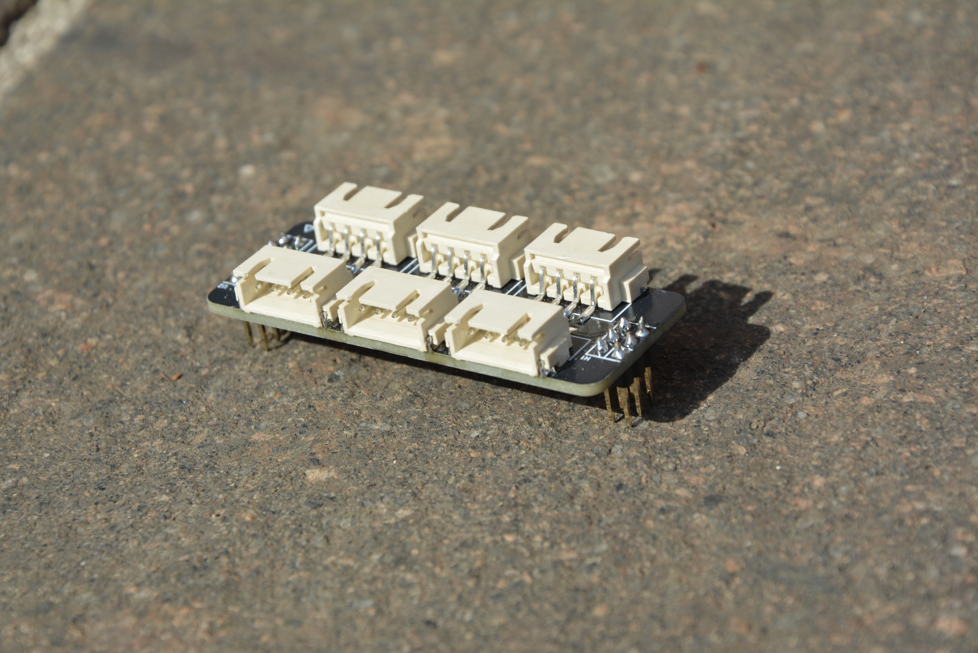
Immagini Tesi/Foto/DSC_0344.JPG
