EdoardoBaggio03/ControlloSerra/Immagini Tesi/Foto/DSC_0345.JPG

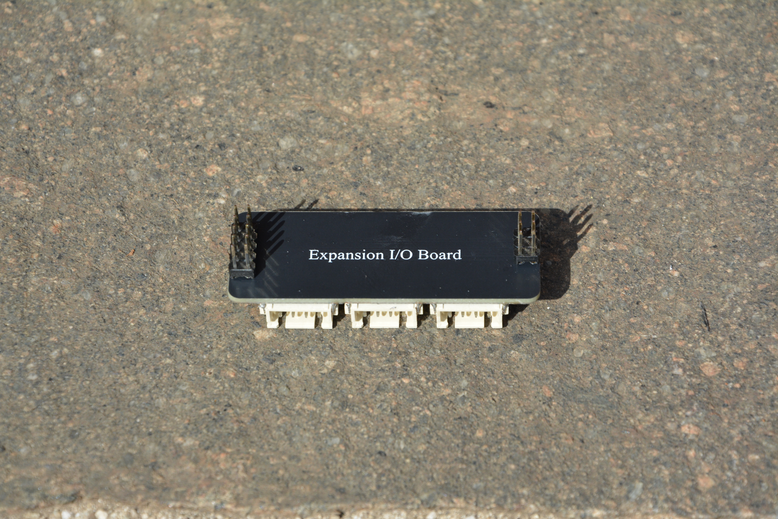
Immagini Tesi/Foto/DSC_0345.JPG
