EdoardoBaggio03/ControlloSerra/Immagini Tesi/Foto/DSC_0346.JPG

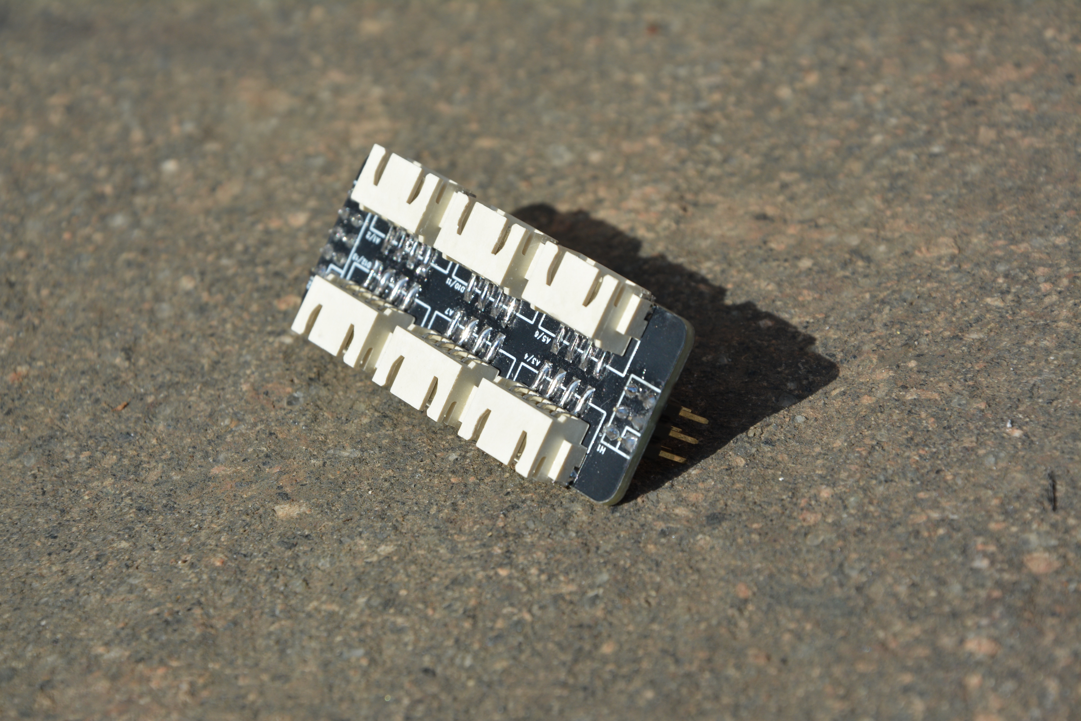
Immagini Tesi/Foto/DSC_0346.JPG
