EdoardoBaggio03/ControlloSerra/Immagini Tesi/Foto/DSC_0347.JPG

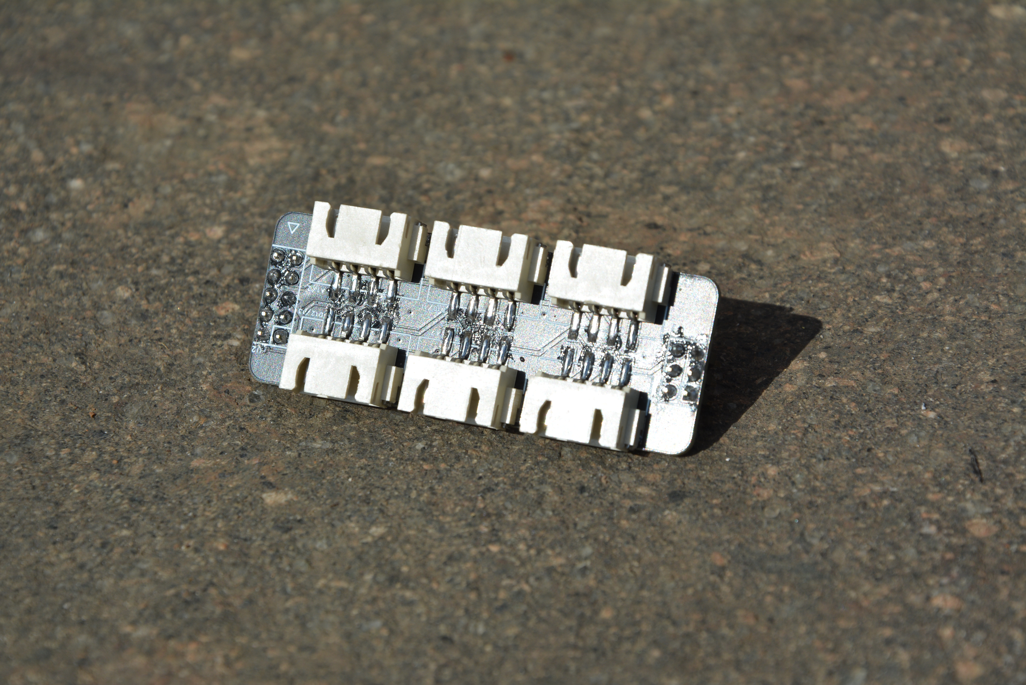
Immagini Tesi/Foto/DSC_0347.JPG
