EdoardoBaggio03/ControlloSerra/Immagini Tesi/Foto/DSC_0348.JPG

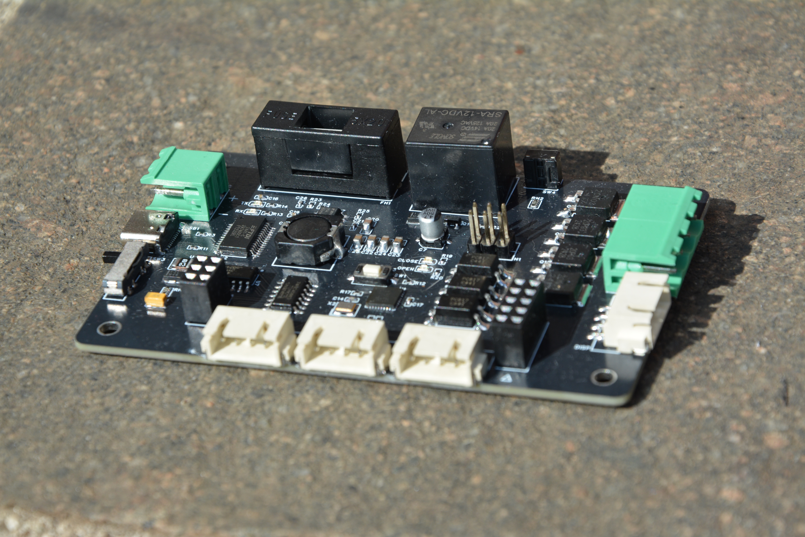
Immagini Tesi/Foto/DSC_0348.JPG
