EdoardoBaggio03/ControlloSerra/Immagini Tesi/Foto/DSC_0349.JPG

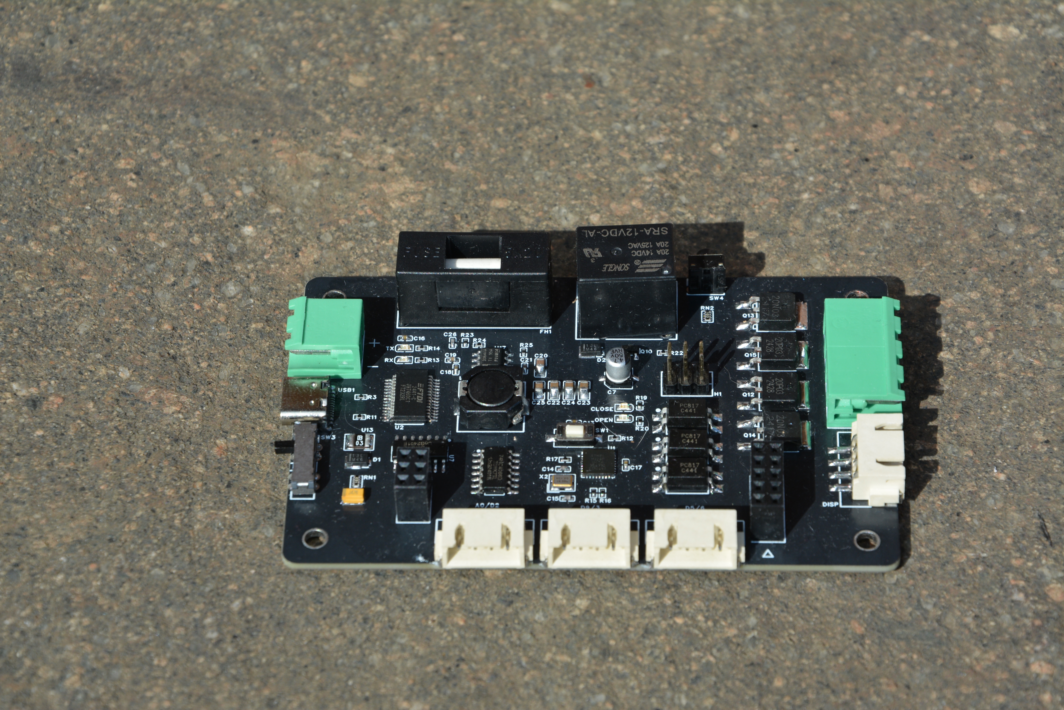
Immagini Tesi/Foto/DSC_0349.JPG
