EdoardoBaggio03/ControlloSerra/Immagini Tesi/Foto/DSC_0350.JPG

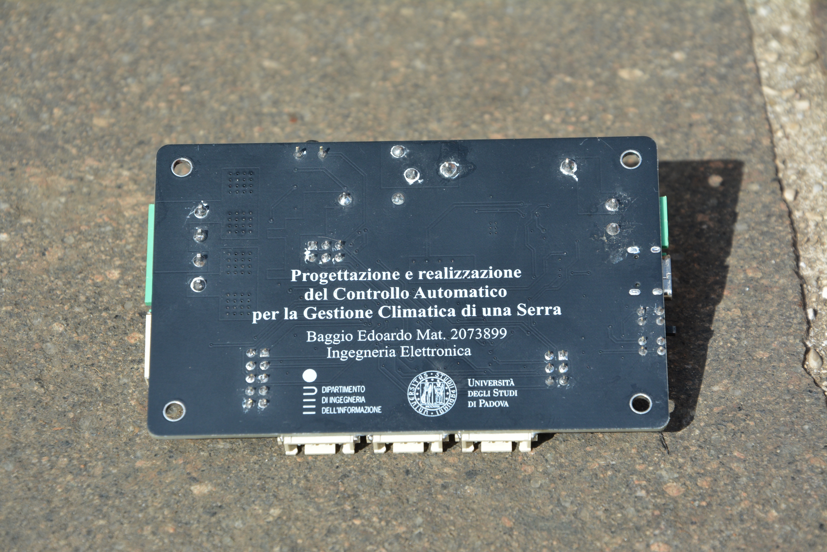
Immagini Tesi/Foto/DSC_0350.JPG
