EdoardoBaggio03/ControlloSerra/Immagini Tesi/Foto/DSC_0351.JPG

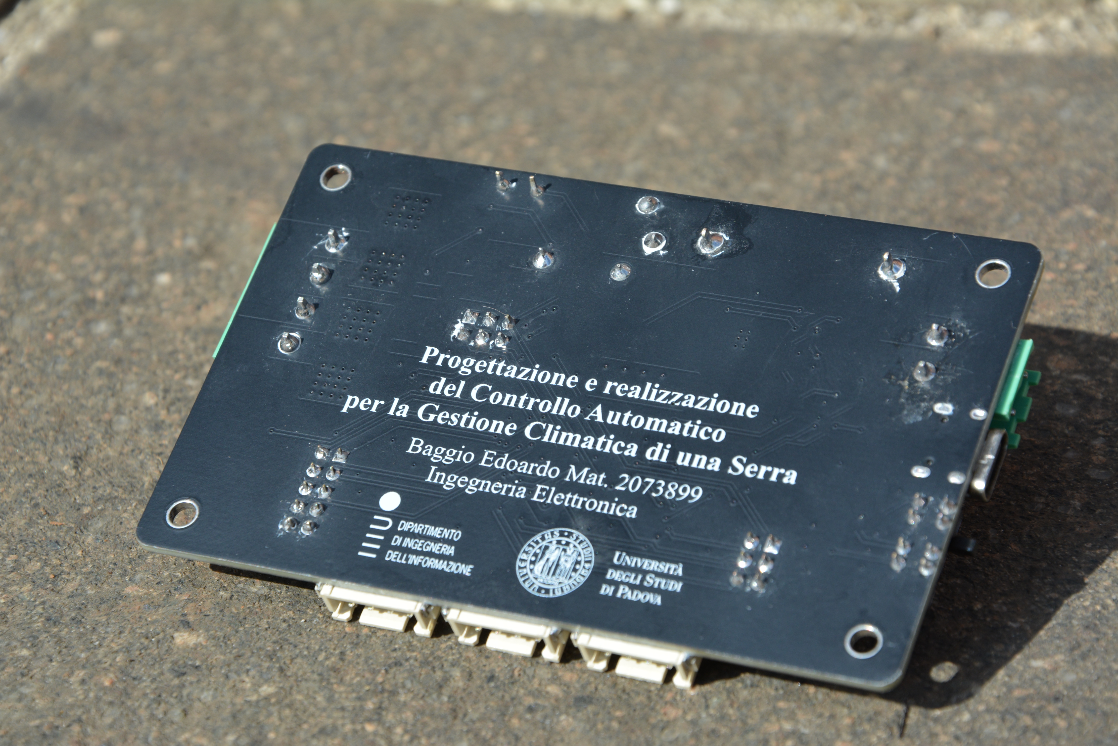
Immagini Tesi/Foto/DSC_0351.JPG
