EdoardoBaggio03/ControlloSerra/Immagini Tesi/Foto/DSC_0352.JPG

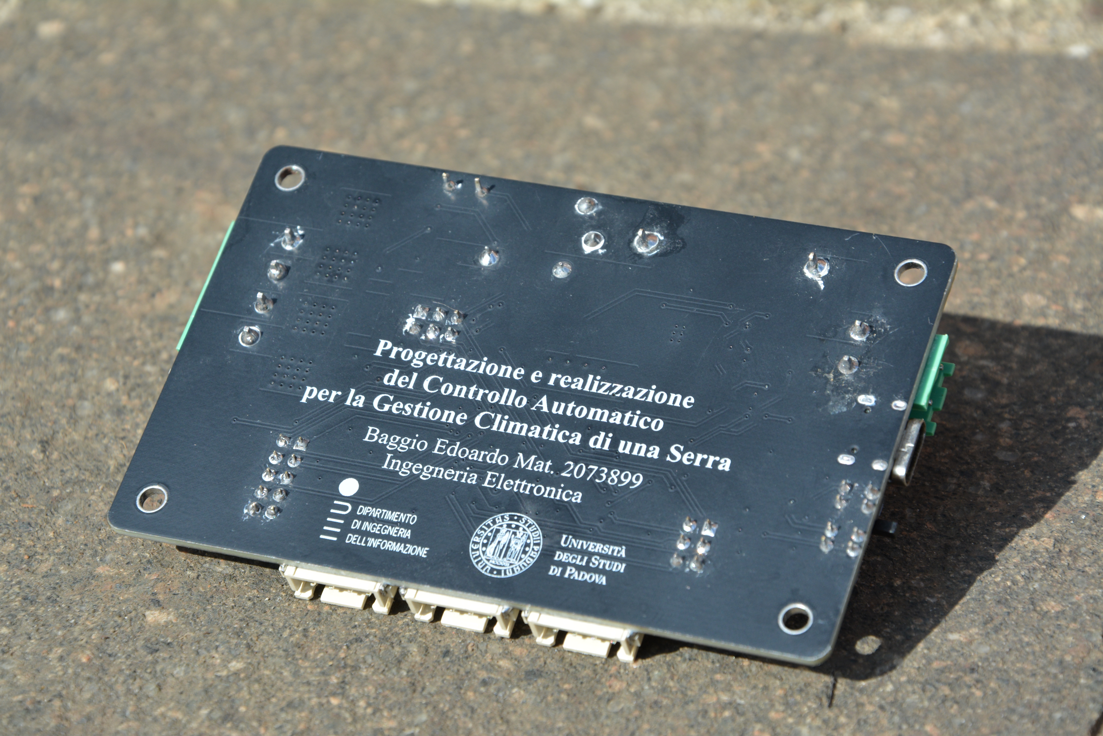
Immagini Tesi/Foto/DSC_0352.JPG
