EdoardoBaggio03/ControlloSerra/Immagini Tesi/Foto/DSC_0353.JPG

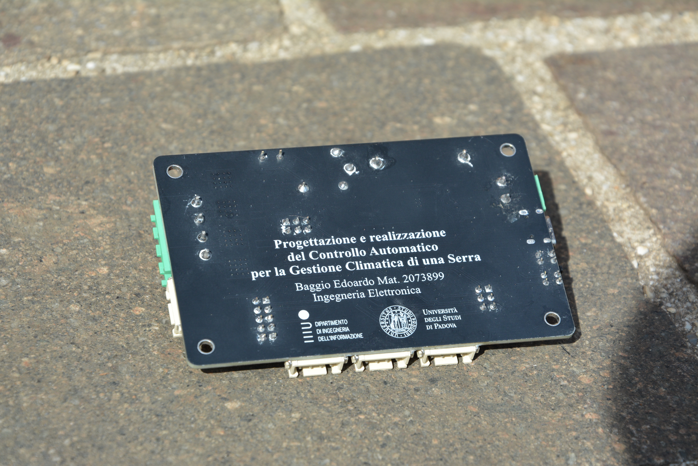
Immagini Tesi/Foto/DSC_0353.JPG
