EdoardoBaggio03/ControlloSerra/Immagini Tesi/Foto/DSC_0354.JPG

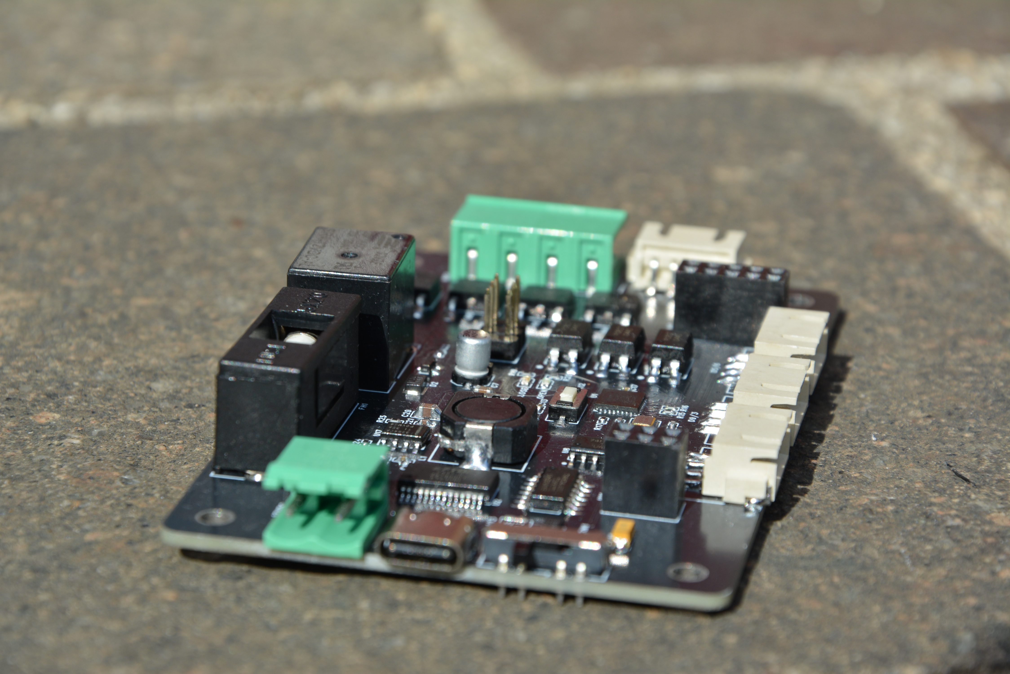
Immagini Tesi/Foto/DSC_0354.JPG
