EdoardoBaggio03/ControlloSerra/Immagini Tesi/Foto/DSC_0355.JPG

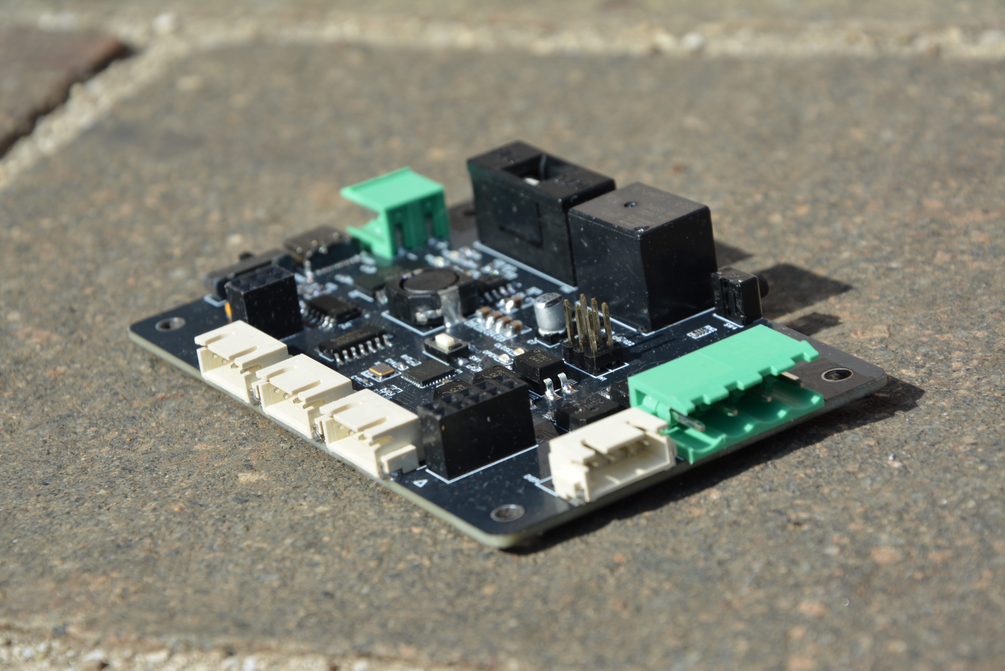
Immagini Tesi/Foto/DSC_0355.JPG
