EdoardoBaggio03/ControlloSerra/Immagini Tesi/Foto/DSC_0356.JPG

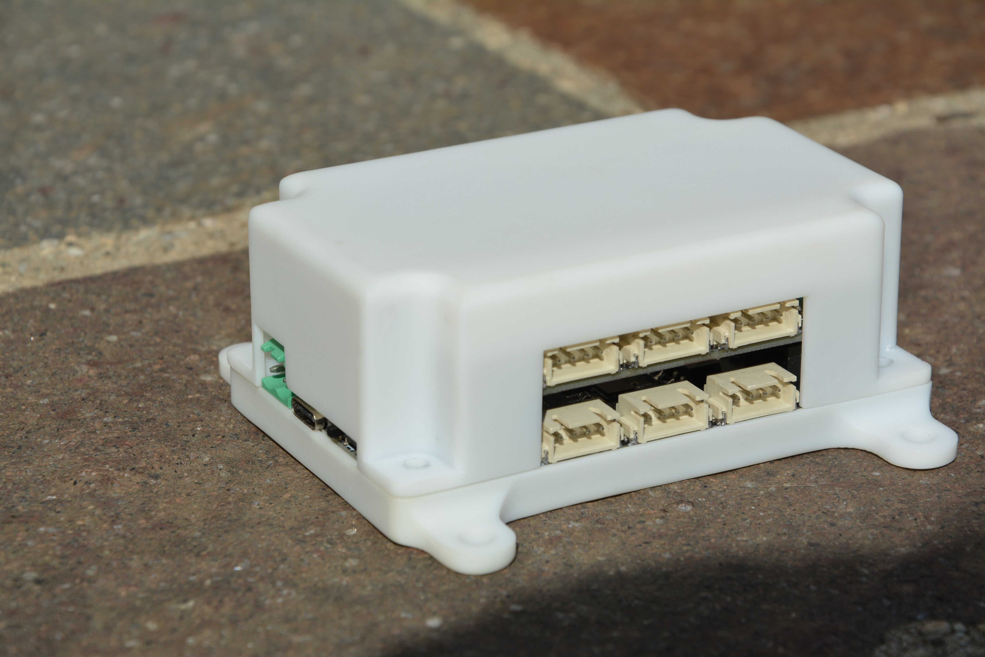
Immagini Tesi/Foto/DSC_0356.JPG
