EdoardoBaggio03/ControlloSerra/Immagini Tesi/Foto/DSC_0357.JPG

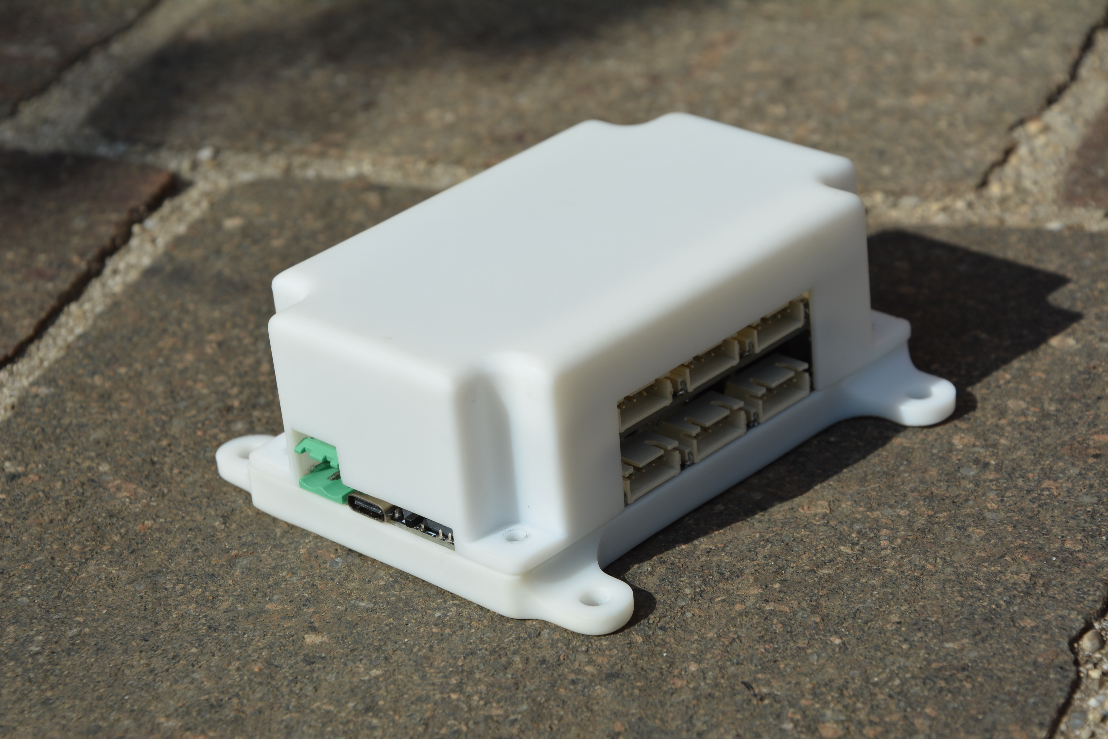
Immagini Tesi/Foto/DSC_0357.JPG
