EdoardoBaggio03/ControlloSerra/Immagini Tesi/Foto/DSC_0358.JPG

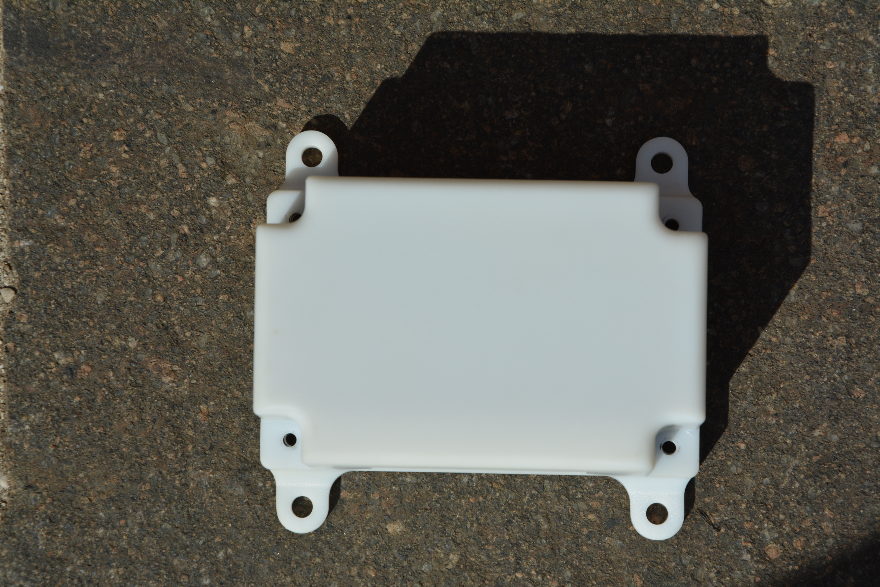
Immagini Tesi/Foto/DSC_0358.JPG
