EdoardoBaggio03/ControlloSerra/Immagini Tesi/Foto/DSC_0359.JPG

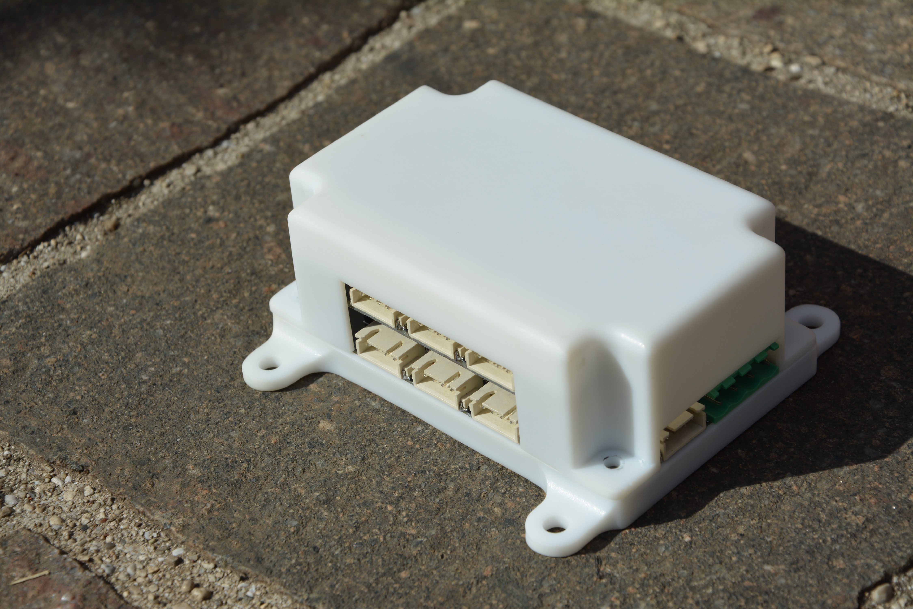
Immagini Tesi/Foto/DSC_0359.JPG
