EdoardoBaggio03/ControlloSerra/Immagini Tesi/Foto/DSC_0360.JPG

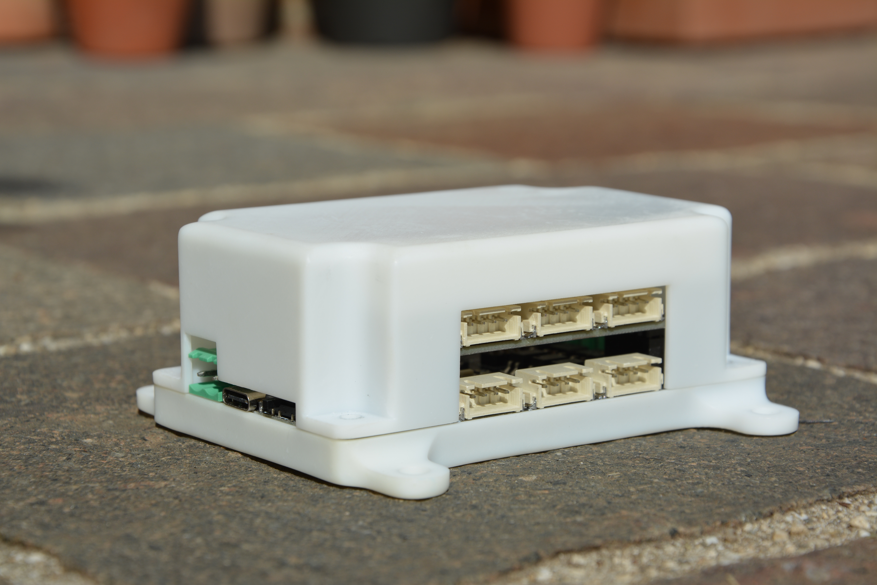
Immagini Tesi/Foto/DSC_0360.JPG
