EdoardoBaggio03/ControlloSerra/Immagini Tesi/Foto/DSC_0361.JPG

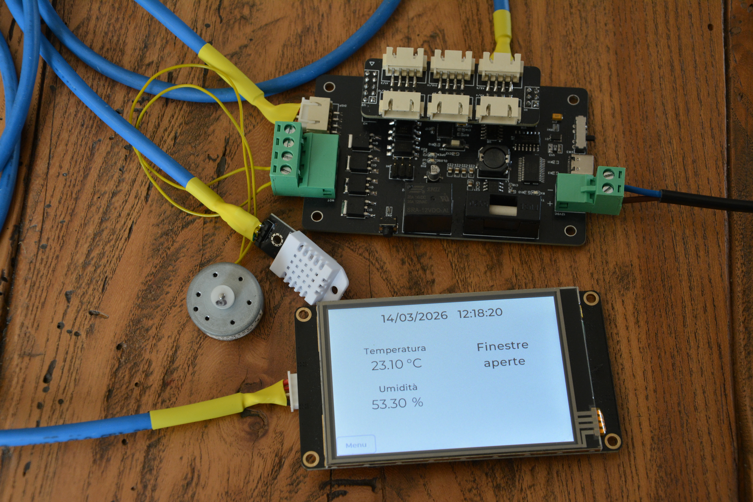
Immagini Tesi/Foto/DSC_0361.JPG
