EdoardoBaggio03/ControlloSerra/Immagini Tesi/Foto/DSC_0362.JPG

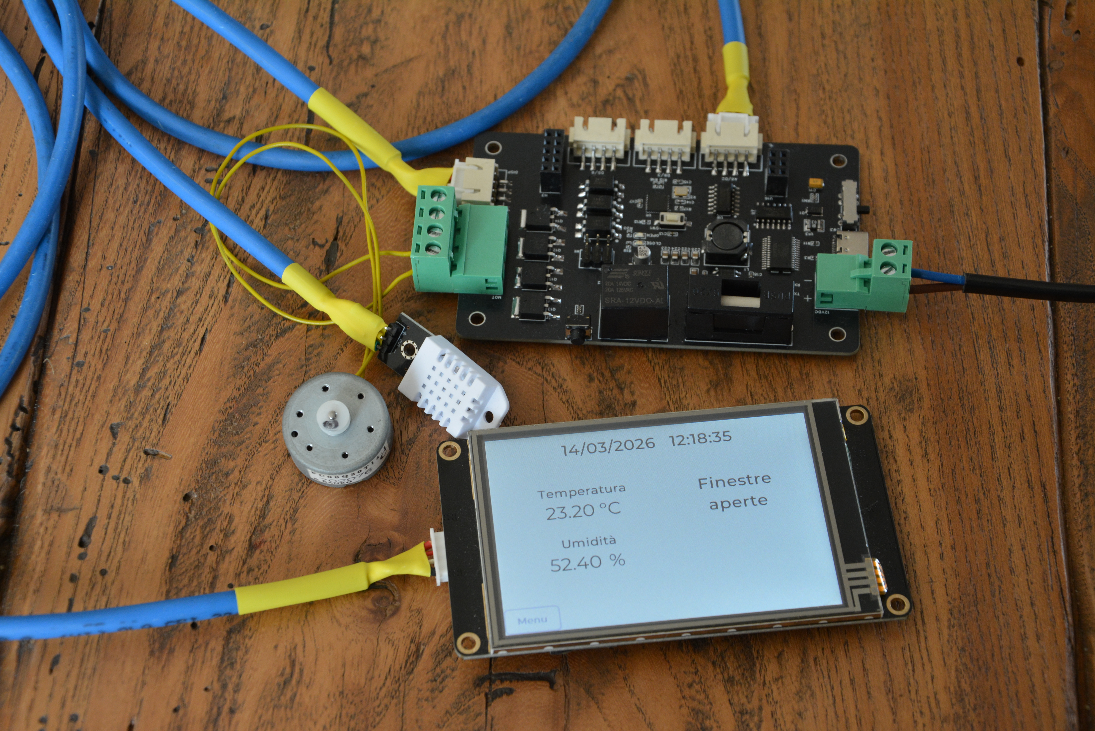
Immagini Tesi/Foto/DSC_0362.JPG
