EdoardoBaggio03/ControlloSerra/Immagini Tesi/Foto/DSC_0363.JPG

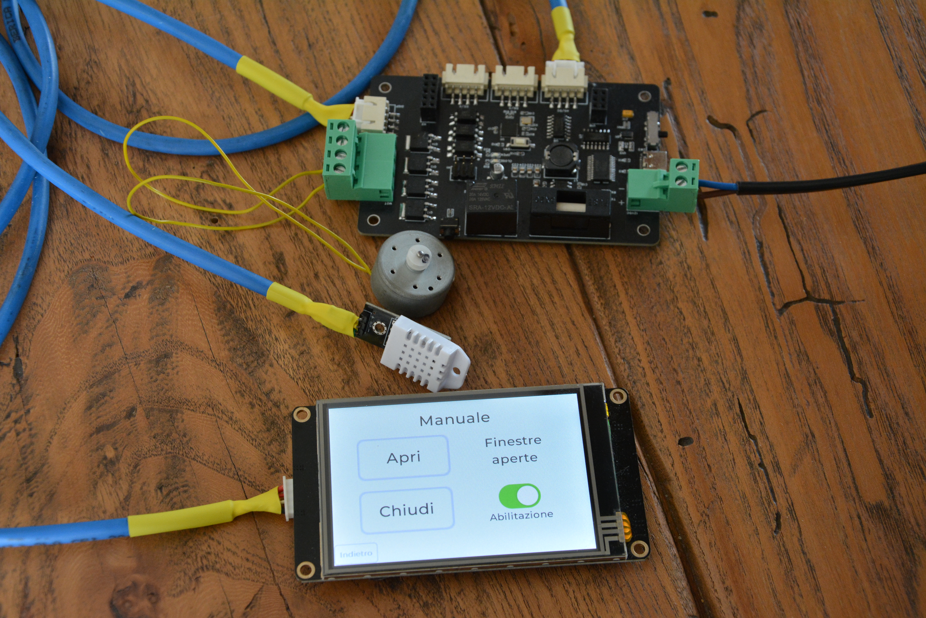
Immagini Tesi/Foto/DSC_0363.JPG
