EdoardoBaggio03/ControlloSerra/Immagini Tesi/Foto/DSC_0364.JPG

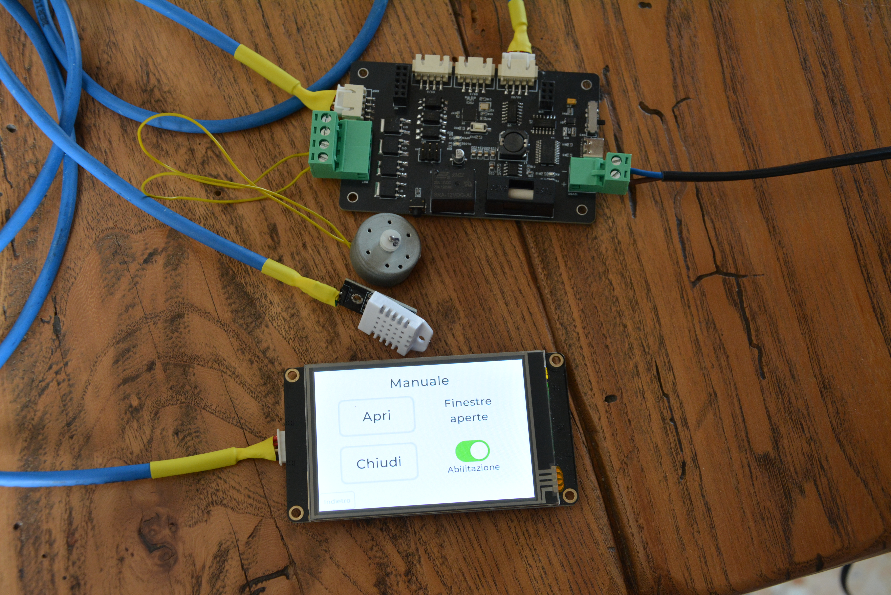
Immagini Tesi/Foto/DSC_0364.JPG
