EdoardoBaggio03/ControlloSerra/Immagini Tesi/Foto/DSC_0373.JPG

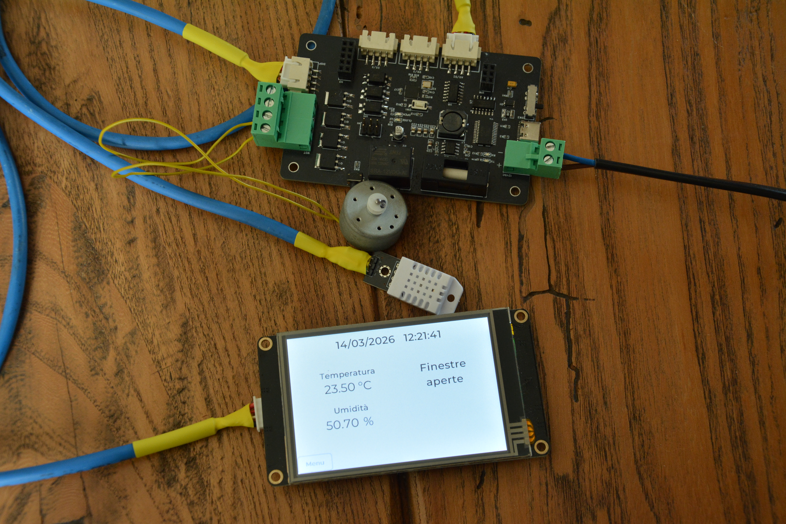
Immagini Tesi/Foto/DSC_0373.JPG
