EdoardoBaggio03/ControlloSerra/Immagini Tesi/Foto/DSC_0374.JPG

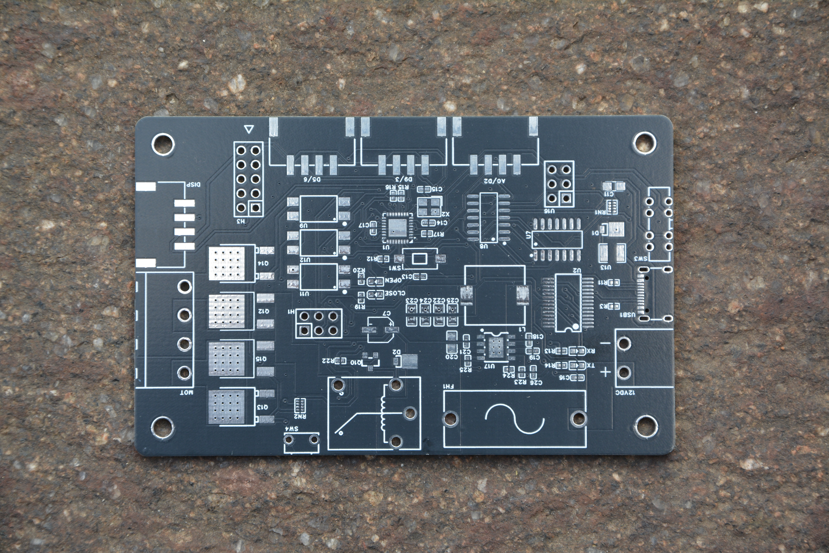
Immagini Tesi/Foto/DSC_0374.JPG
