EdoardoBaggio03/ControlloSerra/Immagini Tesi/Foto/DSC_0375.JPG

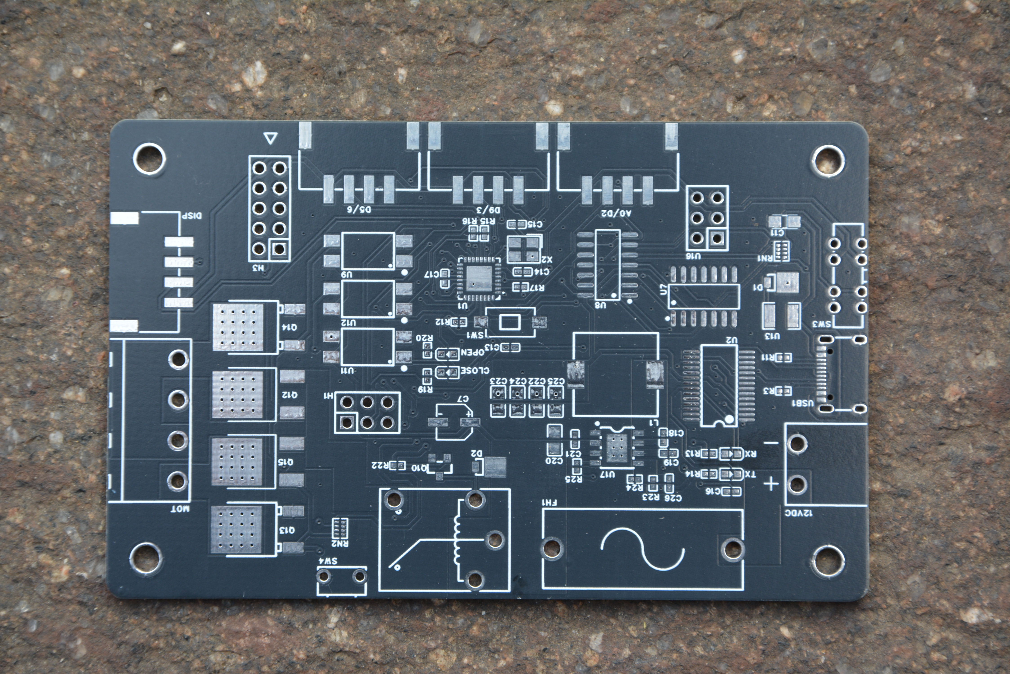
Immagini Tesi/Foto/DSC_0375.JPG
