EdoardoBaggio03/ControlloSerra/Immagini Tesi/Foto/DSC_0376.JPG

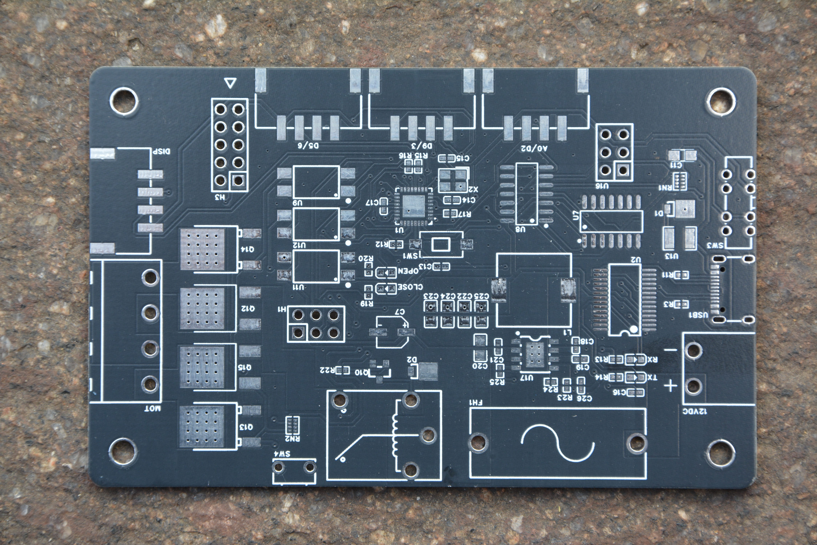
Immagini Tesi/Foto/DSC_0376.JPG
