EdoardoBaggio03/ControlloSerra/Immagini Tesi/Foto/DSC_0377.JPG

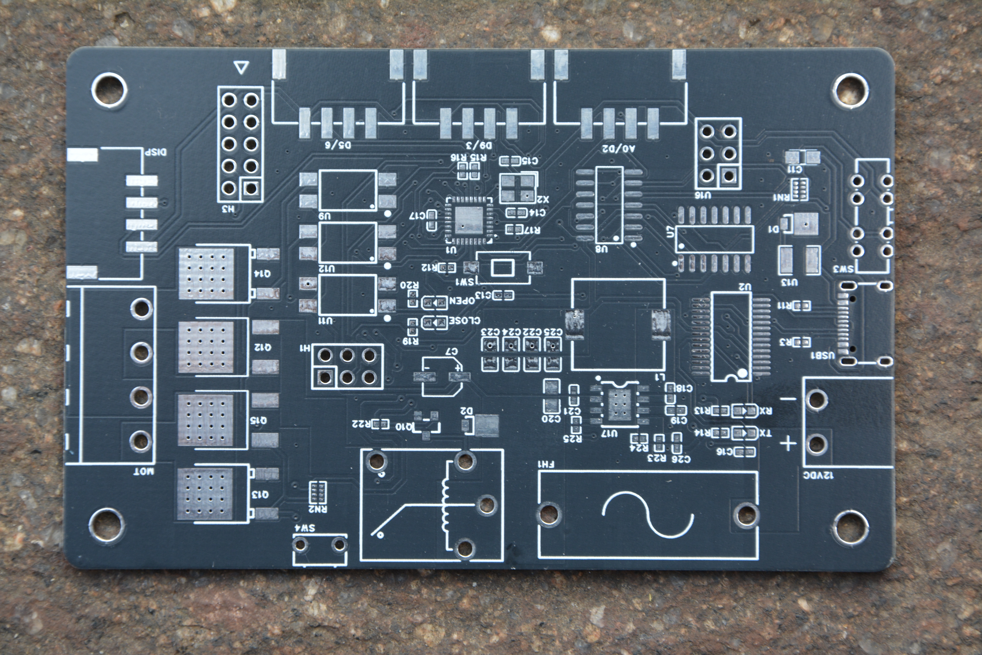
Immagini Tesi/Foto/DSC_0377.JPG
