EdoardoBaggio03/ControlloSerra/Immagini Tesi/Foto/DSC_0378.JPG

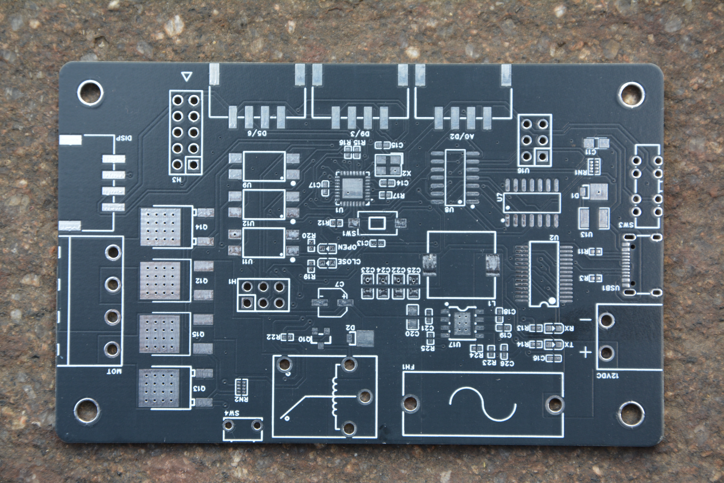
Immagini Tesi/Foto/DSC_0378.JPG
