EdoardoBaggio03/ControlloSerra/Immagini Tesi/Foto/DSC_0379.JPG

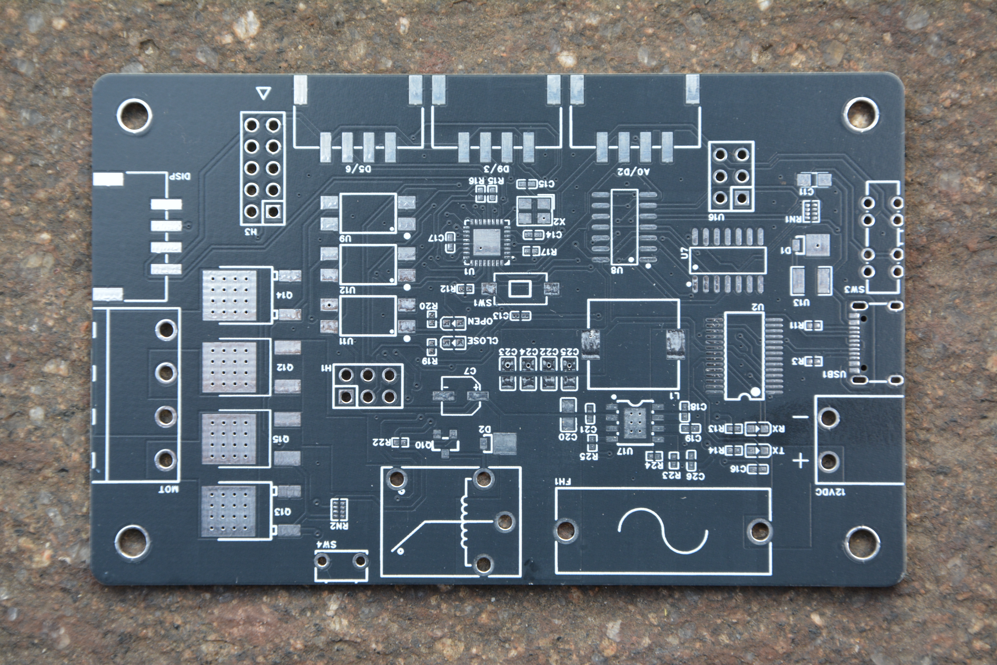
Immagini Tesi/Foto/DSC_0379.JPG
