EdoardoBaggio03/ControlloSerra/Immagini Tesi/Foto/DSC_0380.JPG

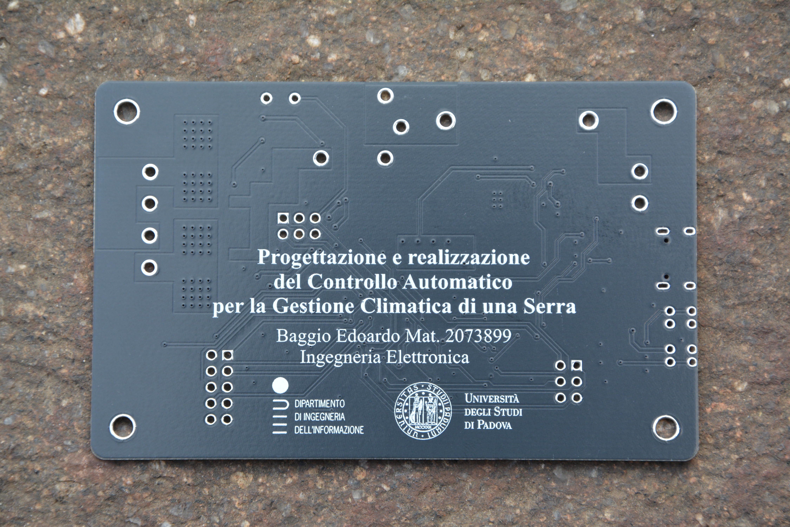
Immagini Tesi/Foto/DSC_0380.JPG
