EdoardoBaggio03/ControlloSerra/Immagini Tesi/Foto/DSC_0381.JPG

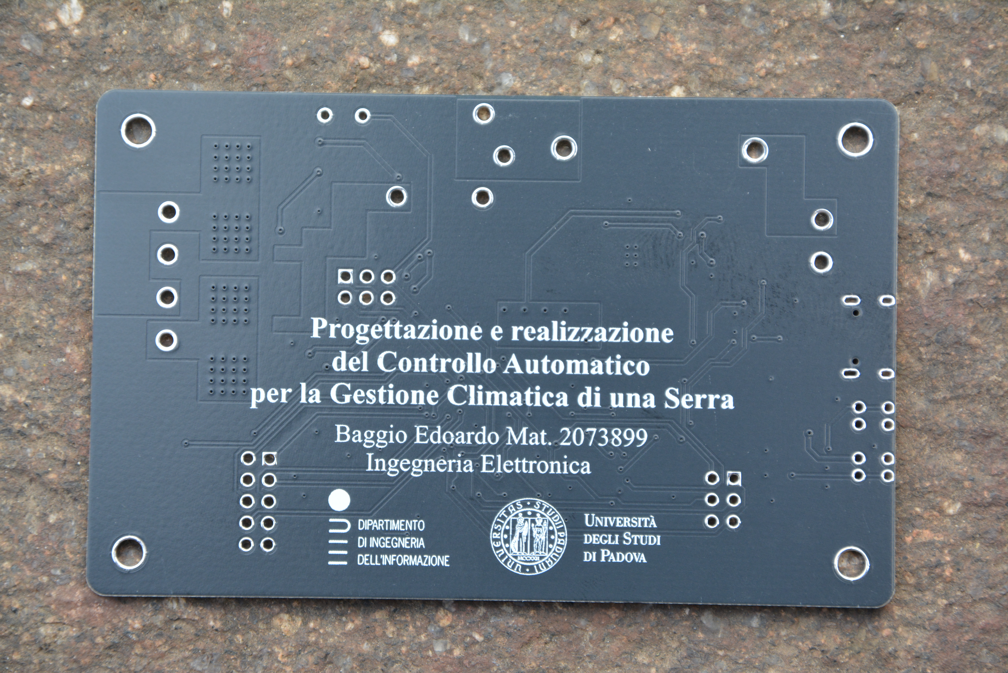
Immagini Tesi/Foto/DSC_0381.JPG
