EdoardoBaggio03/ControlloSerra/Immagini Tesi/Foto/DSC_0382.JPG

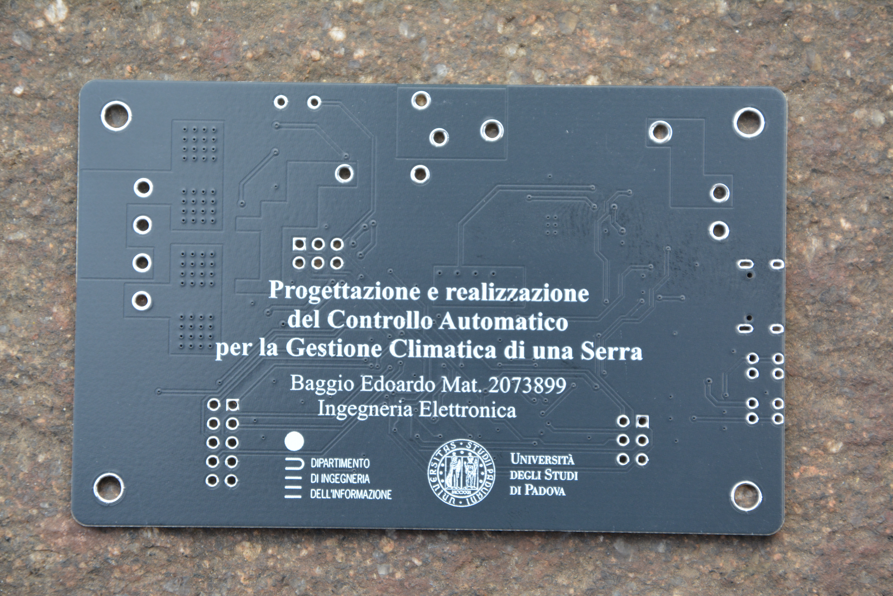
Immagini Tesi/Foto/DSC_0382.JPG
