EdoardoBaggio03/ControlloSerra/Immagini Tesi/Foto/DSC_0383.JPG

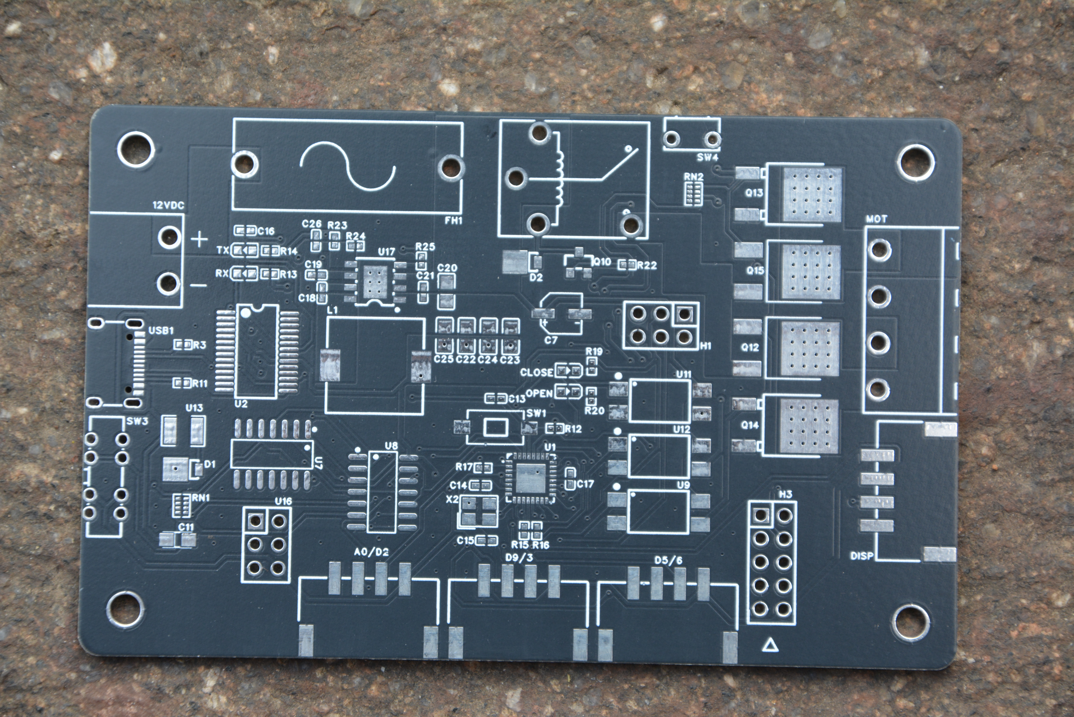
Immagini Tesi/Foto/DSC_0383.JPG
