EdoardoBaggio03/ControlloSerra/Immagini Tesi/Foto/DSC_0384.JPG

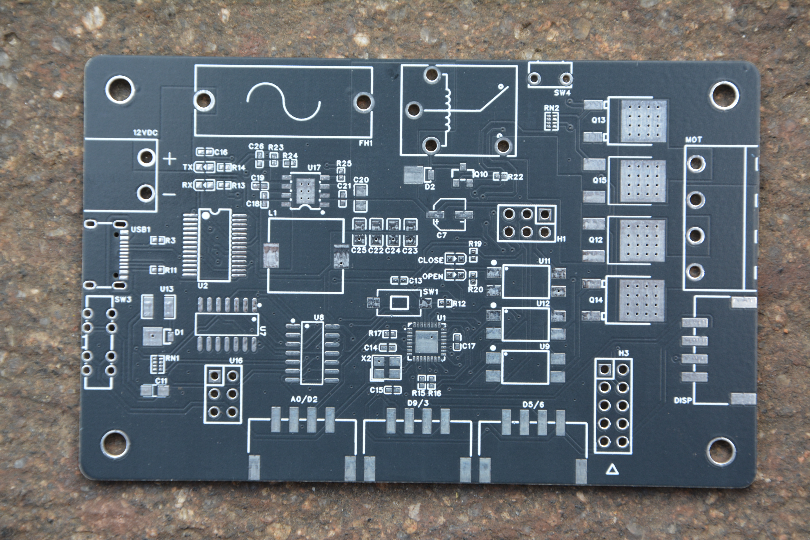
Immagini Tesi/Foto/DSC_0384.JPG
