EdoardoBaggio03/ControlloSerra/Immagini Tesi/Foto/DSC_0385.JPG

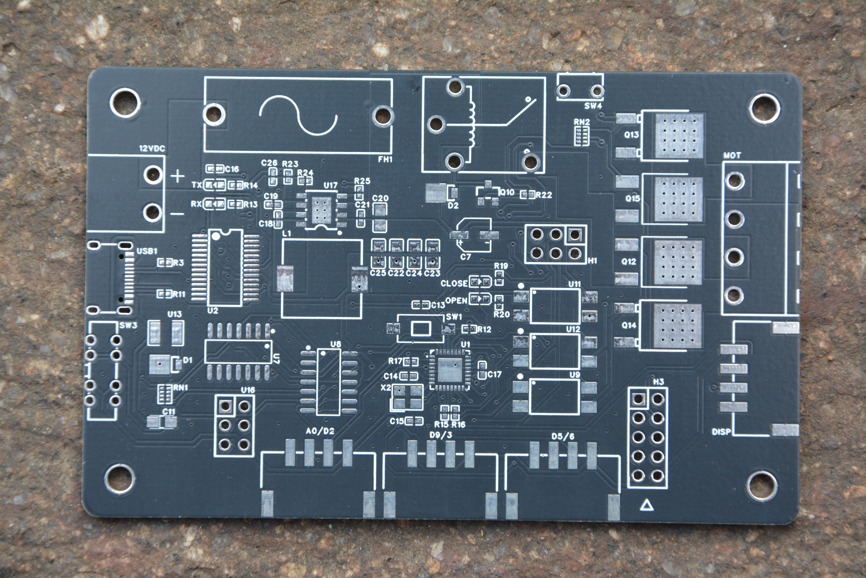
Immagini Tesi/Foto/DSC_0385.JPG
