EdoardoBaggio03/ControlloSerra/Immagini Tesi/Foto/IMG_0027.jpeg

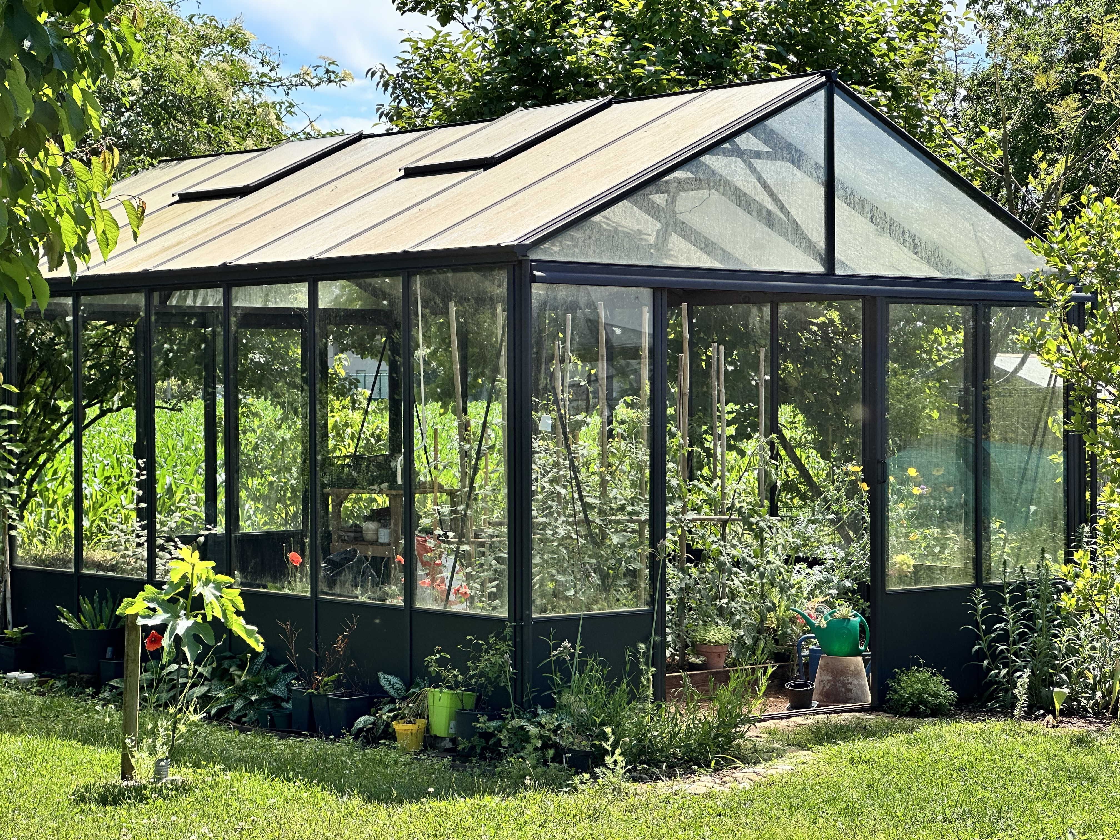
Immagini Tesi/Foto/IMG_0027.jpeg
