EdoardoBaggio03/ControlloSerra/Immagini Tesi/Foto/IMG_0030.jpeg

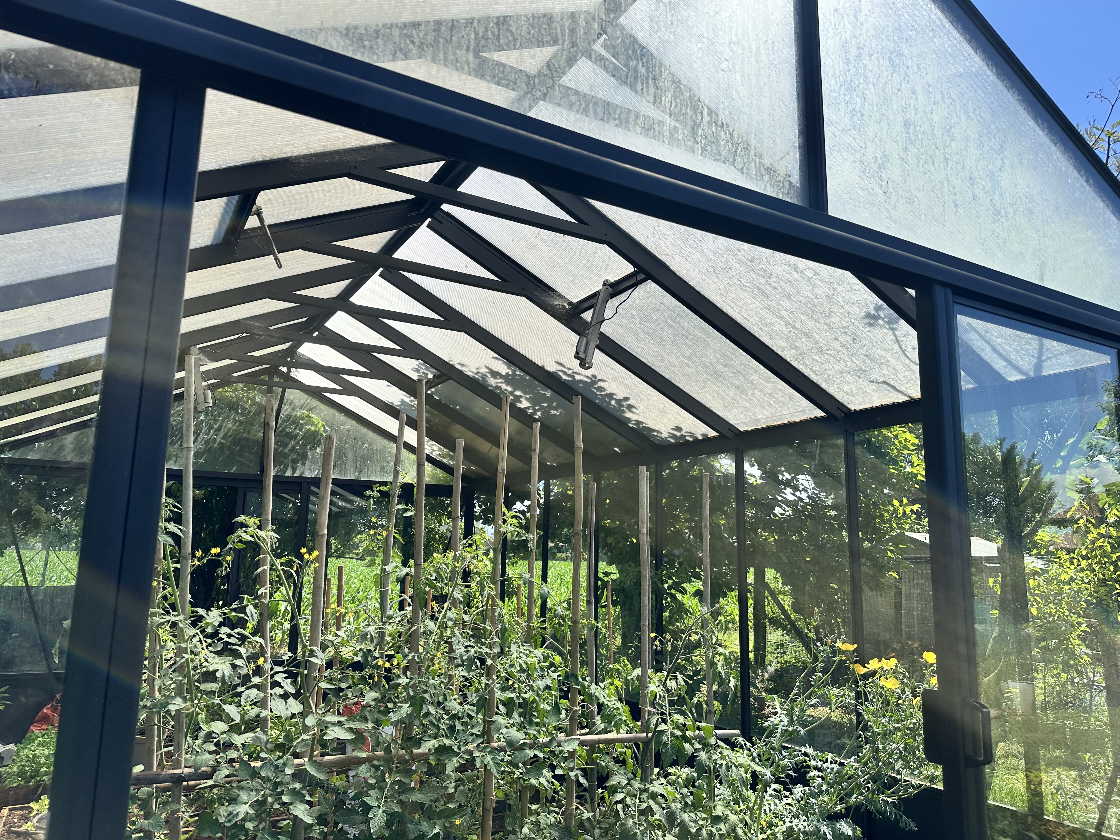
Immagini Tesi/Foto/IMG_0030.jpeg
