EdoardoBaggio03/ControlloSerra/Immagini Tesi/Foto/IMG_0031.jpeg

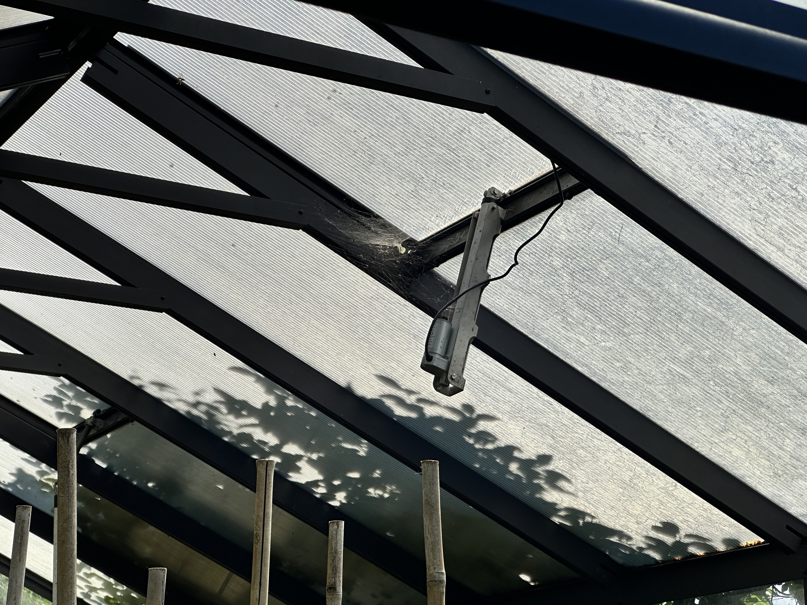
Immagini Tesi/Foto/IMG_0031.jpeg
