EdoardoBaggio03/ControlloSerra/Immagini Tesi/Nextion.webp

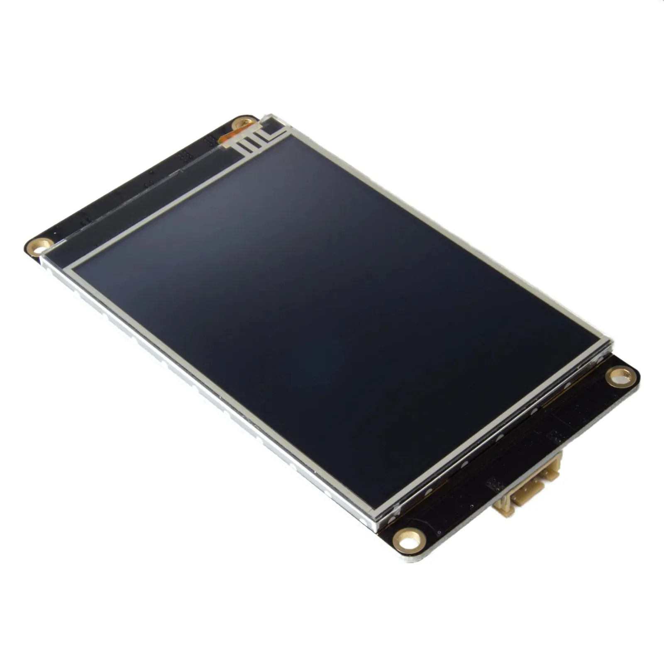
Immagini Tesi/Nextion.webp
