EdoardoBaggio03/ControlloSerra/Immagini Tesi/Pagine Nextion/5882058382070451512_121.jpg

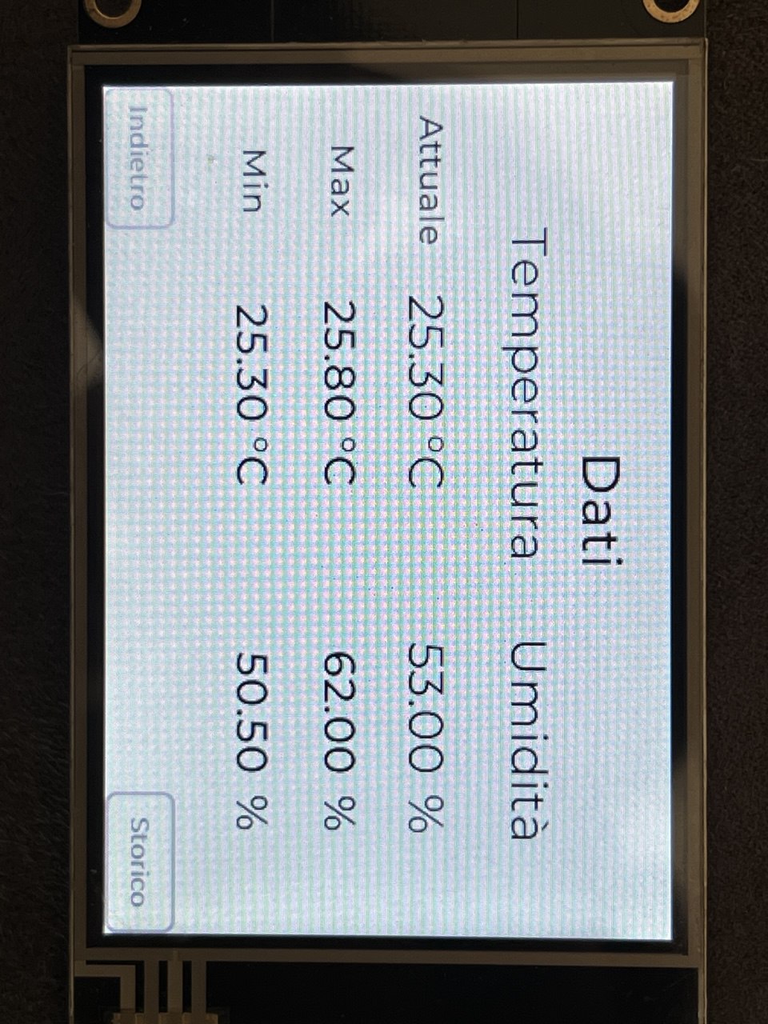
Immagini Tesi/Pagine Nextion/5882058382070451512_121.jpg
