EdoardoBaggio03/ControlloSerra/Immagini Tesi/Pezzi codice/Funzioni apri e chiudi.png

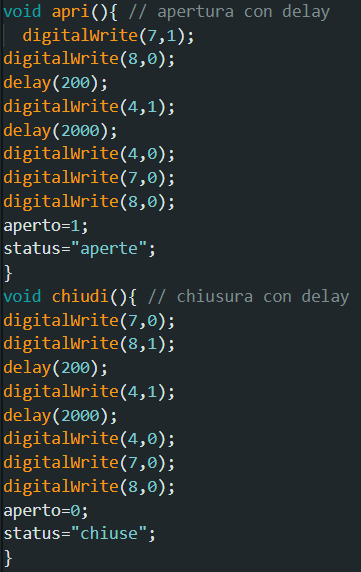
Immagini Tesi/Pezzi codice/Funzioni apri e chiudi.png
