EdoardoBaggio03/ControlloSerra/Immagini Tesi/Pezzi codice/InvDisp.png

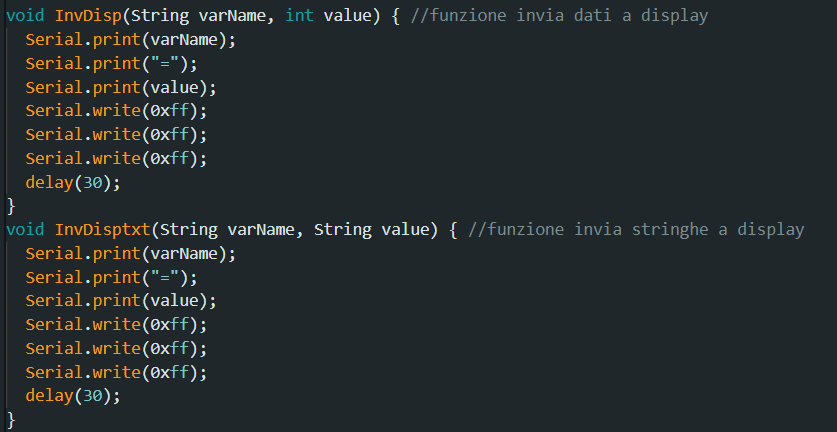
Immagini Tesi/Pezzi codice/InvDisp.png
