EdoardoBaggio03/ControlloSerra/Immagini Tesi/Pezzi codice/Parsing seriale.png

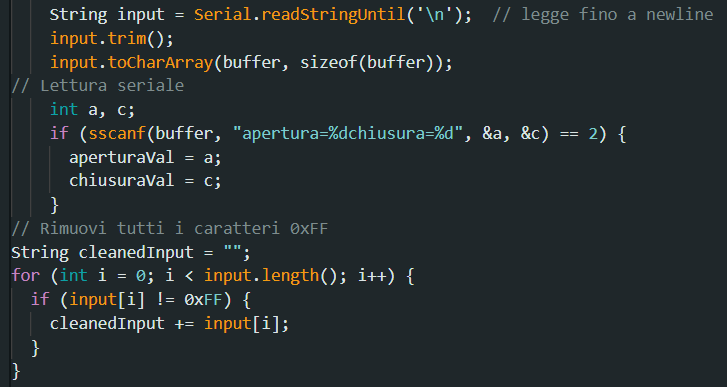
Immagini Tesi/Pezzi codice/Parsing seriale.png
