EdoardoBaggio03/ControlloSerra/Immagini Tesi/Render back expansion board.png

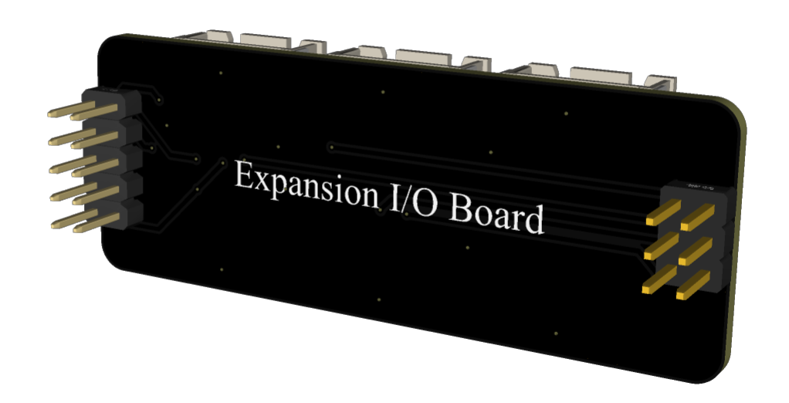
Immagini Tesi/Render back expansion board.png
