EdoardoBaggio03/ControlloSerra/Immagini Tesi/Render expansion Board.png

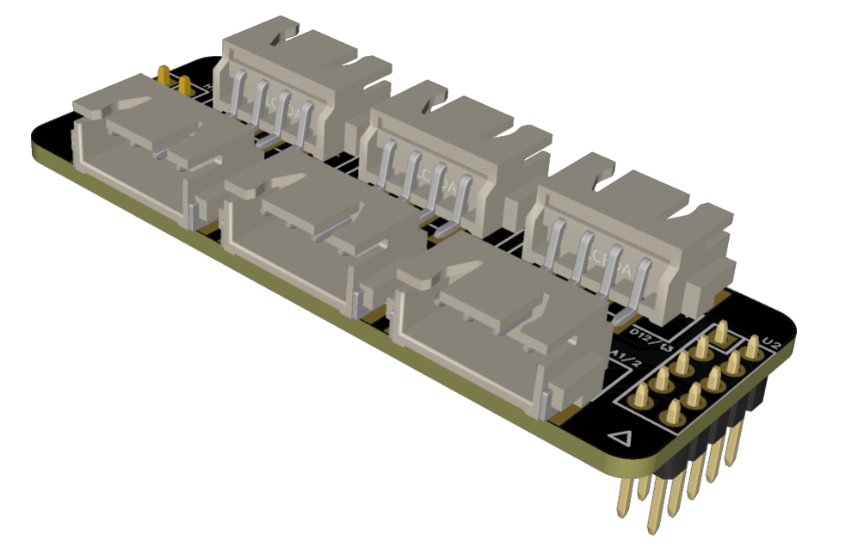
Immagini Tesi/Render expansion Board.png
