EdoardoBaggio03/ControlloSerra/Immagini Tesi/Schema ATMEGA.png

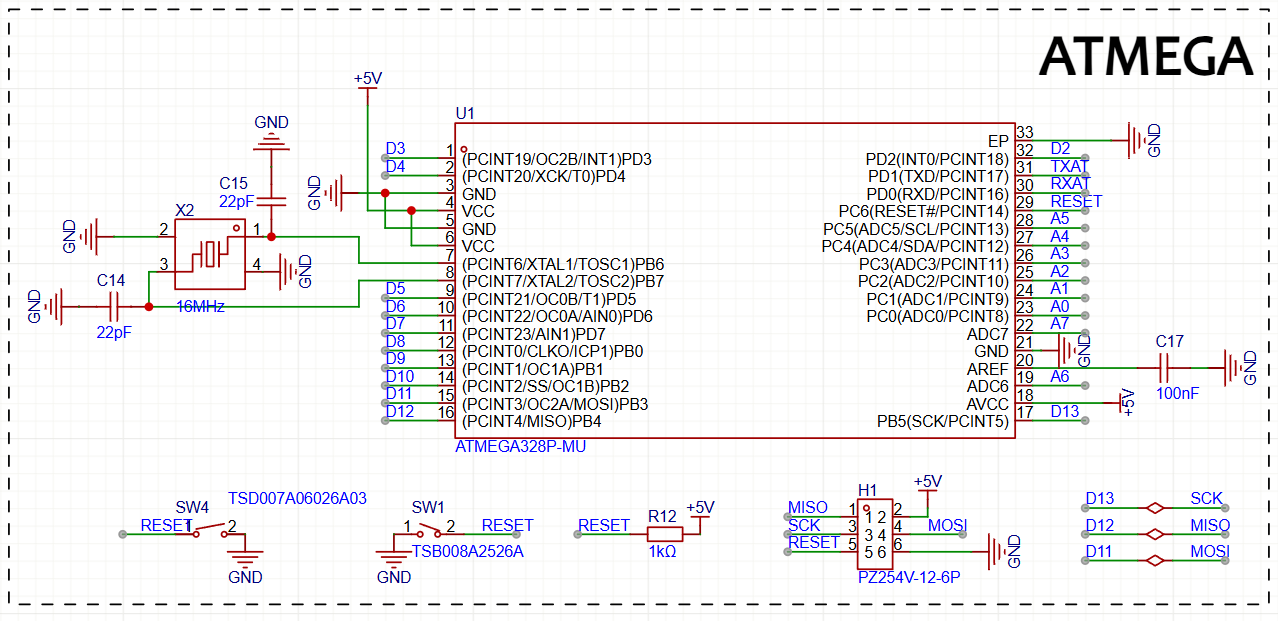
Immagini Tesi/Schema ATMEGA.png
