EdoardoBaggio03/ControlloSerra/Immagini Tesi/Schema IO.png

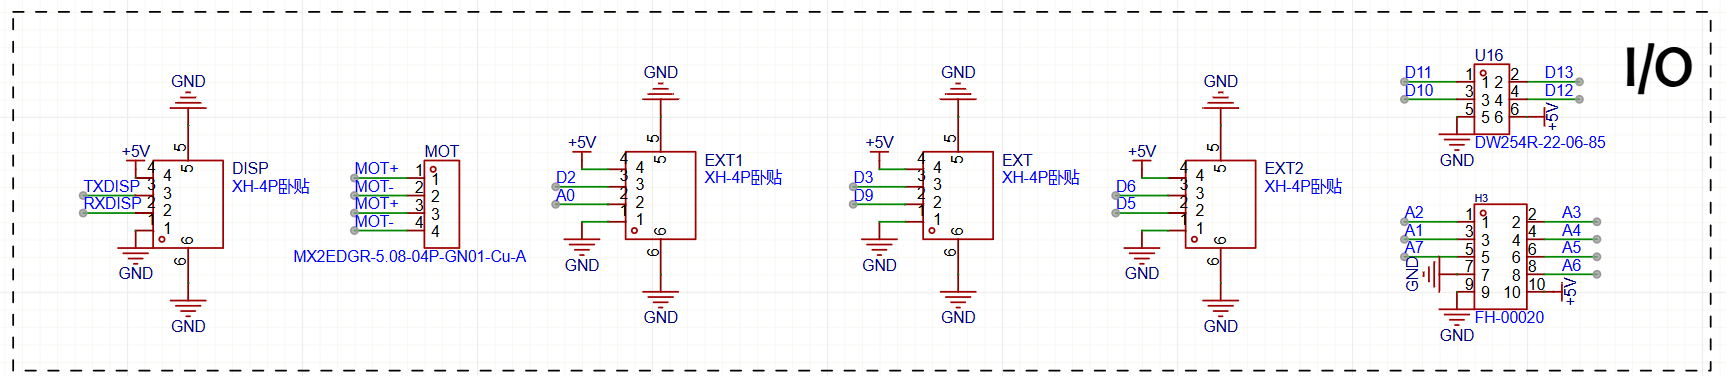
Immagini Tesi/Schema IO.png
