EdoardoBaggio03/ControlloSerra/Immagini Tesi/Schema UART Switching.png

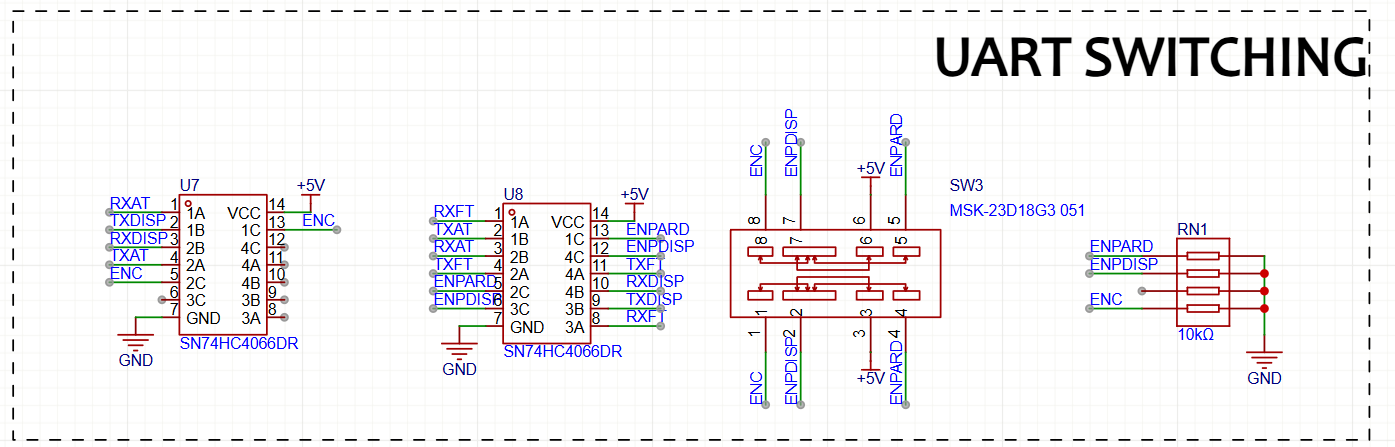
Immagini Tesi/Schema UART Switching.png
