EdoardoBaggio03/ControlloSerra/Immagini Tesi/Schema USB to UART.png

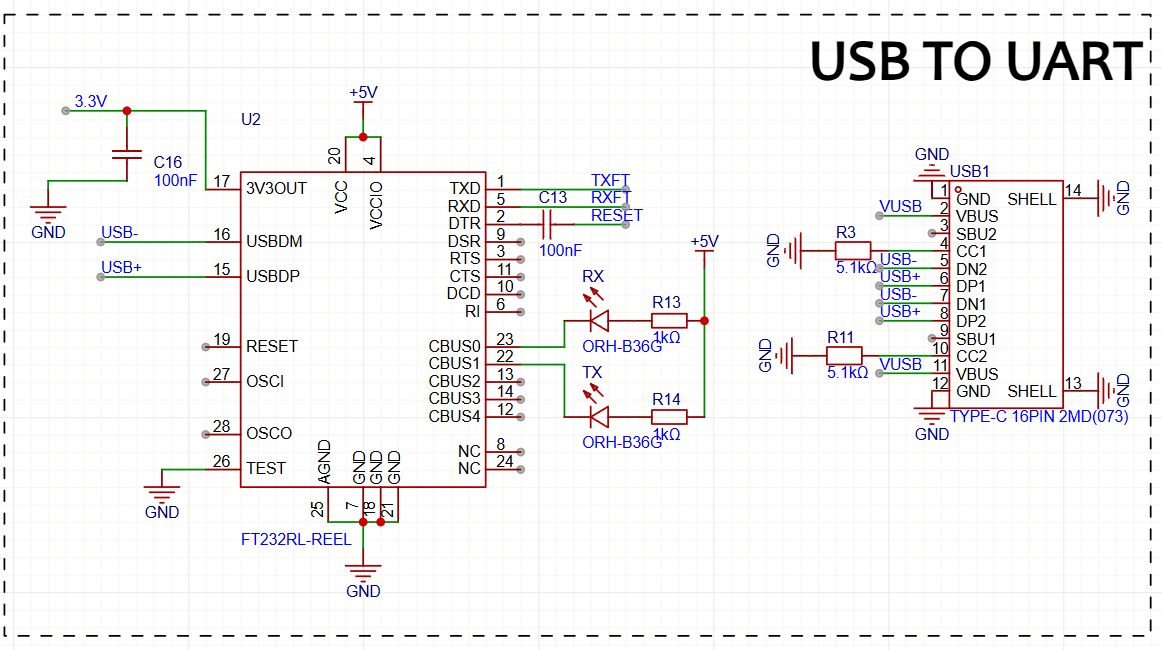
Immagini Tesi/Schema USB to UART.png
