EdoardoBaggio03/ControlloSerra/Indice Tesi.png

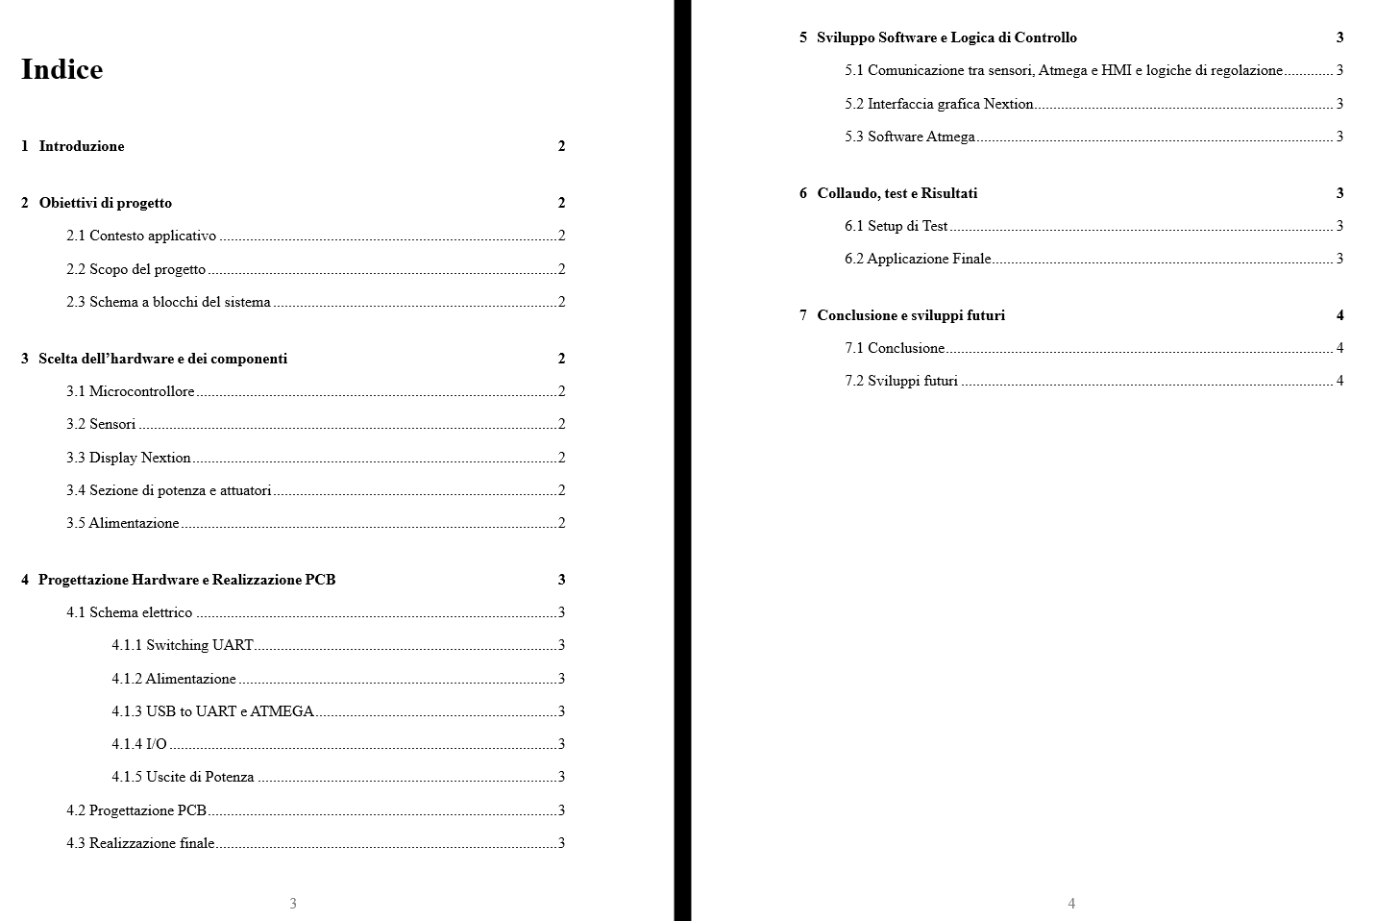
Indice Tesi.png
