EdoardoBaggio03/ControlloSerra/Loghi/DEI_neg_big_Tavola-disegno-1-p52tmd22vqi2o1dicu5yo269pg1n7wvsdlqu20b66w.png

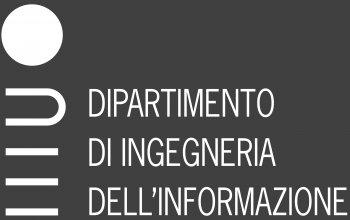
Loghi/DEI_neg_big_Tavola-disegno-1-p52tmd22vqi2o1dicu5yo269pg1n7wvsdlqu20b66w.png
