EdoardoBaggio03/ControlloSerra/Loghi/maxresdefault.jpg

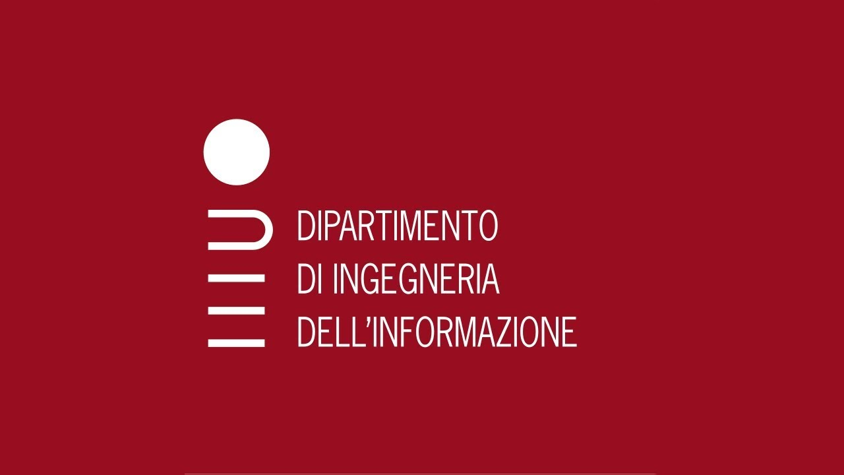
Loghi/maxresdefault.jpg
