EdoardoBaggio03/ControlloSerra/BOM_Board1_Main Board_2025-04-29.xlsx

No. | Quantity | Comment | Designator | Footprint | Value | Manufacturer Part | Manufacturer | Supplier Part | Supplier | LCSC Price
1 | 1 | 4.7uF | C7 | CAP-SMD_BD4.0-L4.3-W4.3-LS5.3-FD | 4.7uF | RVE1H4R7M0405 | HONOR(荣誉) | C88672 | LCSC
2 | 1 | 330nF | C10 | C0201 | 330nF | TCC0201X5R334K6R3ZT | CCTC(三环) | C18164550 | LCSC
3 | 1 | 47uF | C11 | CASE-A_3216 | 47uF | CA45-A6R3K476T | 湘怡中元/湘江 | C122913 | LCSC
4 | 4 | 100nF | C12,C13,C16,C17 | C0402 | 100nF | 0402B104K160NT | FH(风华) | C41851 | LCSC
5 | 2 | 22pF | C14,C15 | C0402 | 22pF | TCC0402C0G220J500AT | CCTC(三环) | C466226 | LCSC
6 | 2 | SS1P3L-M3/84A | D1,D2 | DO-220AA_L3.4-W2.0-LS3.9-RD |  | SS1P3L-M3/84A | VISHAY(威世) | C2875475 | LCSC
7 | 4 | XH-4P卧贴 | DISP,EXT,EXT1,EXT2 | CONN-SMD_2.54-4P-WT |  | XH-4P卧贴 | BOOMELE(博穆精密) | C146120 | LCSC
8 | 1 | FH1-200CK-B | FH1 | FUSE-TH_L24.8-W9.8-P22.60 |  | FH1-200CK-B | HONGJU(宏聚) | C268205 | LCSC
9 | 1 | PZ254V-12-6P | H1 | HDR-TH_6P-P2.54-V-M-R2-C3-S2.54 |  | PZ254V-12-6P | XFCN(兴飞) | C492420 | LCSC
10 | 1 | FH-00020 | H3 | HDR-TH_10P-P2.54-V-F-R2-C5-S2.54 |  | FH-00020 | Liansheng(连盛) | C2685204 | LCSC
11 | 1 | SRA-12VDC-AL | K1 | RELAY-TH_SRA-XXVDC-AL |  | SRA-12VDC-AL | 松乐 | C86414 | LCSC
12 | 1 | CJ7805 3% | LDO1 | TO-252-2_L6.6-W6.1-P4.58-LS10.1-BR-CW |  | CJ7805 3% | CJ(江苏长电/长晶) | C21706 | LCSC
13 | 4 | ORH-B36G | LED1,LED2,LED3,LED4 | LED0603-RD |  | ORH-B36G | Orient(奥伦德) | C193191 | LCSC
14 | 1 | MX2EDGR-5.08-04P-GN01-Cu-A | MOT | CONN-TH_4P-P5.08_MX2EDGR-5.08-GN01-04P-CU-A |  | MX2EDGR-5.08-04P-GN01-Cu-A | MAX(迈旭) | C5187975 | LCSC
15 | 2 | IRF4905STRL(UMW) | Q6,Q7 | TO-252-2_L6.6-W6.1-P4.57-LS10.1-BR-CW |  | IRF4905STRL(UMW) | UMW(友台半导体) | C7471852 | LCSC
16 | 2 | MDD50N03D | Q8,Q9 | TO-252-2_L6.6-W6.1-P4.57-LS9.9-BR-CW |  | MDD50N03D | MDD(辰达半导体) | C5357578 | LCSC
17 | 1 | S8050 | Q10 | SOT-23_L2.9-W1.3-P1.90-LS2.4-BR |  | S8050 | Slkor(萨科微) | C444723 | LCSC
18 | 2 | 5.1kΩ | R3,R11 | R0402 | 5.1kΩ | WR04X512JTL | Walsin(华新科) | C384321 | LCSC
19 | 2 | 22Ω | R5,R6 | R0402 | 22Ω | RC-02K220JT | FH(风华) | C140177 | LCSC
20 | 5 | 1kΩ | R12,R13,R14,R19,R20 | R0402 | 1kΩ | RC0402JR-071KL | YAGEO(国巨) | C105637 | LCSC
21 | 3 | 470Ω | R15,R16,R17 | R0402 | 470Ω | RC-02W471JT | FH(风华) | C258129 | LCSC
22 | 1 | 5.6kΩ | R21 | R0402 | 5.6kΩ | SCR0402J5K6 | VO(翔胜) | C3017494 | LCSC
23 | 2 | 10kΩ | RN1,RN2 | RES-ARRAY-SMD_0402-8P-L2.0-W1.0-BL | 10kΩ | 4D02WGJ0103TCE | UNI-ROYAL(厚声) | C25725 | LCSC
24 | 1 | TSB008A2526A | SW1 | SW-SMD_L6.0-W3.5-LS8.0 |  | TSB008A2526A | BZCN(博众电气) | C2888456 | LCSC
25 | 1 | MSK-23D18G3 051 | SW3 | SW-TH_HX-MSK-23D18G3-051 |  | MSK-23D18G3 051 | SHOU HAN(首韩) | C7507438 | LCSC
26 | 1 | ATMEGA328P-MU | U1 | HVQFN-32_L5.0-W5.0-P0.50-TL-EP3.1 |  | ATMEGA328P-MU | MICROCHIP(美国微芯) | C7499261 | LCSC
27 | 1 | FT232RL-REEL | U2 | SSOP-28_L10.2-W5.3-P0.65-LS7.8-BL |  | FT232RL-REEL | FTDI(飞特帝亚) | C8690 | LCSC
28 | 1 | DC-005-2.0 | U3 | DC-IN-TH_DC-005-2.0_C22459640 |  | DC-005-2.0 | HanElectricity(瀚源) | C22459640 | LCSC
29 | 1 | 1uF | U4 | CAP-SMD_BD4.0-L4.3-W4.3-LS5.0-FD | 1uF | 126RV0119 | KNSCHA(科尼盛) | C7461250 | LCSC
30 | 2 | SN74HC4066DR | U7,U8 | SOIC-14_L8.7-W3.9-P1.27-LS6.0-BL |  | SN74HC4066DR | TI(德州仪器) | C2869168 | LCSC
31 | 3 | PC817C | U9,U11,U12 | SMD-4_L6.5-W4.6-P2.54-LS10.3-TL |  | PC817C | HXY MOSFET(华轩阳电子) | C5451663 | LCSC
32 | 1 | SMD1210B035TF | U13 | R1210 |  | SMD1210B035TF | Brightking(君耀电子) | C269159 | LCSC
33 | 1 | FH-00221 | U15 | HDR-TH_4P-P2.54-V-F-R2-C2-S2.54 |  | FH-00221 | Liansheng(连盛) | C2685206 | LCSC
34 | 1 | DW254R-22-06-85 | U16 | HDR-TH_6P-P2.54-V-F-R2-C3-S2.54 |  | DW254R-22-06-85 | DEALON(德艺隆) | C2935983 | LCSC
35 | 1 | TYPE-C 16PIN 2MD(073) | USB1 | USB-C-SMD_TYPE-C-6PIN-2MD-073 |  | TYPE-C 16PIN 2MD(073) | SHOU HAN(首韩) | C2765186 | LCSC
36 | 1 | 16MHz | X2 | CRYSTAL-SMD_4P-L3.2-W2.5-BL | 16MHz | XC32M4-16.000-F16NLDT | HCI(杭晶) | C2925591 | LCSC
