EdoardoBaggio03/ControlloSerra/PCB/VER 2/BOM_Board1_PCB1_2025-07-11.xlsx

No. | Quantity | Designator | Footprint | Value | Manufacturer Part | Manufacturer | Supplier Part | Supplier
1 | 1 | 12VDC | CONN-TH_2P-P5.08_MX2EDGR-5.08-GN01-02P-CU-A |  | MX2EDGR-5.08-02P-GN01-Cu-A | MAX(迈旭) | C5187973 | LCSC
7 | 1 | C19 | C0402 | 1uF | TCC0402X5R105M160AT | CCTC(三环) | C7393851 | LCSC
8 | 1 | C20 | C0805 | 10uF | TCC0805X5R106K250FT | CCTC(三环) | C5448891 | LCSC
9 | 1 | C21 | C0402 | 220nF | CGA0402X5R224K500GT | HRE(芯声) | C36911358 | LCSC
10 | 4 | C22,C23,C24,C25 | C0805 | 22uF | CGA0805X5R226M160MT | HRE(芯声) | C6119898 | LCSC
17 | 1 | L1 | IND-SMD_L10.4-W10.3 | 6.8uH | SMDRH105R-6R8NT | SXN(顺翔诺) | C10167 | LCSC
26 | 2 | R23,R25 | R0402 | 100kΩ | RTT02104JTH | RALEC(旺诠) | C102760 | LCSC
27 | 1 | R24 | R0402 | 24.9kΩ | RC0402FR-0724K9L | YAGEO(国巨) | C138027 | LCSC
38 | 1 | U17 | ESOP-8_L4.9-W3.9-P1.27-LS6.0-TL-EP |  | LMR33640ADDAR | TI(德州仪器) | C2836966 | LCSC
 | 1 |  |  |  | MX2EDGK-5.08-02P-GN01-Cu-Y-A |  | C5187912 (https://lcsc.com/product-detail/Pluggable-System-Terminal-Block_MAX-MX2EDGK-5-08-02P-GN01-Cu-Y-A_C5187912.html) | LCSC
