EdoardoBaggio03/ControlloSerra/PCB/3D FILES/PCB MAIN ONLY BOARD.step

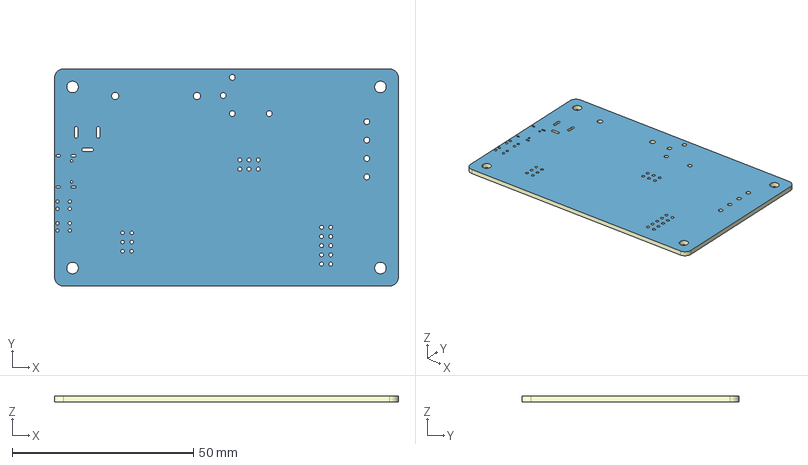
[picture p233: CAD file, 2025-07-17]
PCB/3D FILES/PCB MAIN ONLY BOARD.step
95.0 x 60.0 x 1.60 mm
qqlE-TopTrack
qqlE-BottomTrack
qqlE-Board
qqlE-Top FPC Stiffener
qqlE-Bot FPC Stiffener
