EdoardoBaggio03/ControlloSerra/3D/Base.step

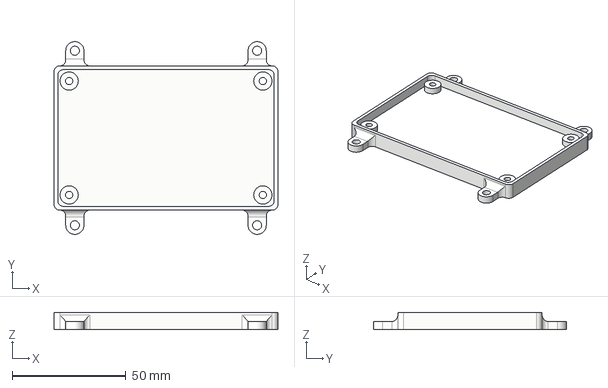
[picture p234: CAD file, 2025-07-17]
3D/Base.step
98.3 x 84.6 x 7.60 mm
