EdoardoBaggio03/ControlloSerra/PCB/3D FILES/Componente1.step

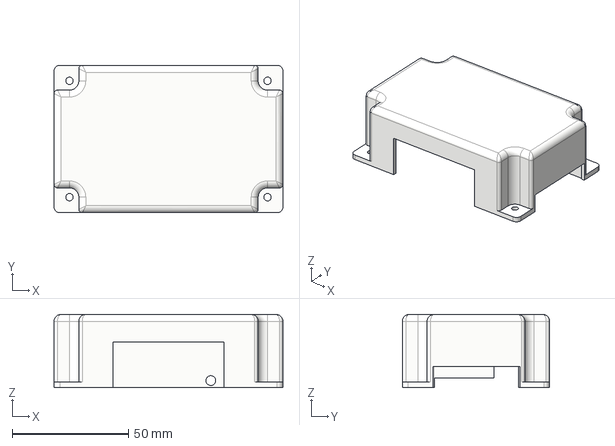
[picture p235: CAD file, 2025-07-17]
PCB/3D FILES/Componente1.step
98.3 x 63.3 x 31.4 mm
