EdoardoBaggio03/ControlloSerra/PCB/3D SWITCH BELLO.obj

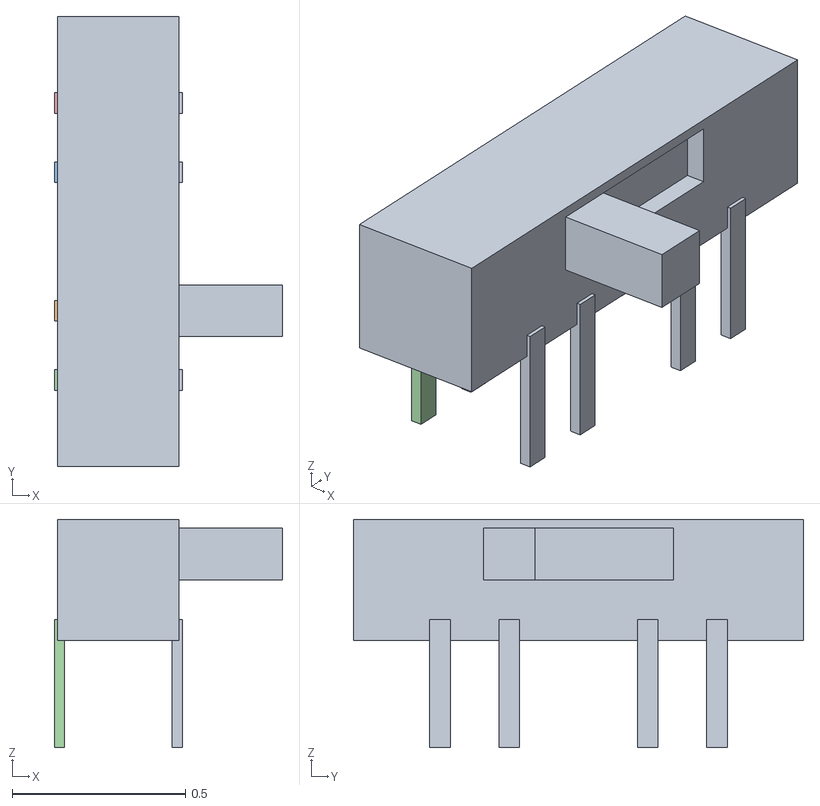
[picture p236: CAD file, 2025-07-17]
PCB/3D SWITCH BELLO.obj
0.66 x 1.30 x 0.66
Corpo1
Corpo2
Corpo3
Corpo4
Corpo5
