EdoardoBaggio03/ControlloSerra/PCB/3D FILES/Componente2.step

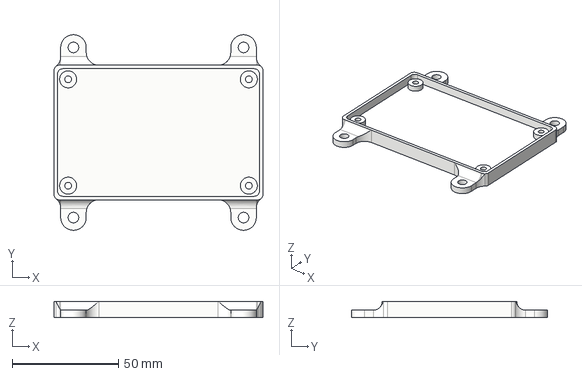
[picture p237: CAD file, 2025-07-17]
PCB/3D FILES/Componente2.step
98.3 x 92.0 x 7.60 mm
