EdoardoBaggio03/ControlloSerra/(list of files, cad)

Other CAD files:
3D/Coperchio.step
3D/M3 hex nut v6.f3d
3D/M3 x 12 v2.f3d
