EdoardoBaggio03/ControlloSerra/PCB/VER 2/SCH_Main Board_2025-07-11.pdf

HBRIDGE | USB TO UART

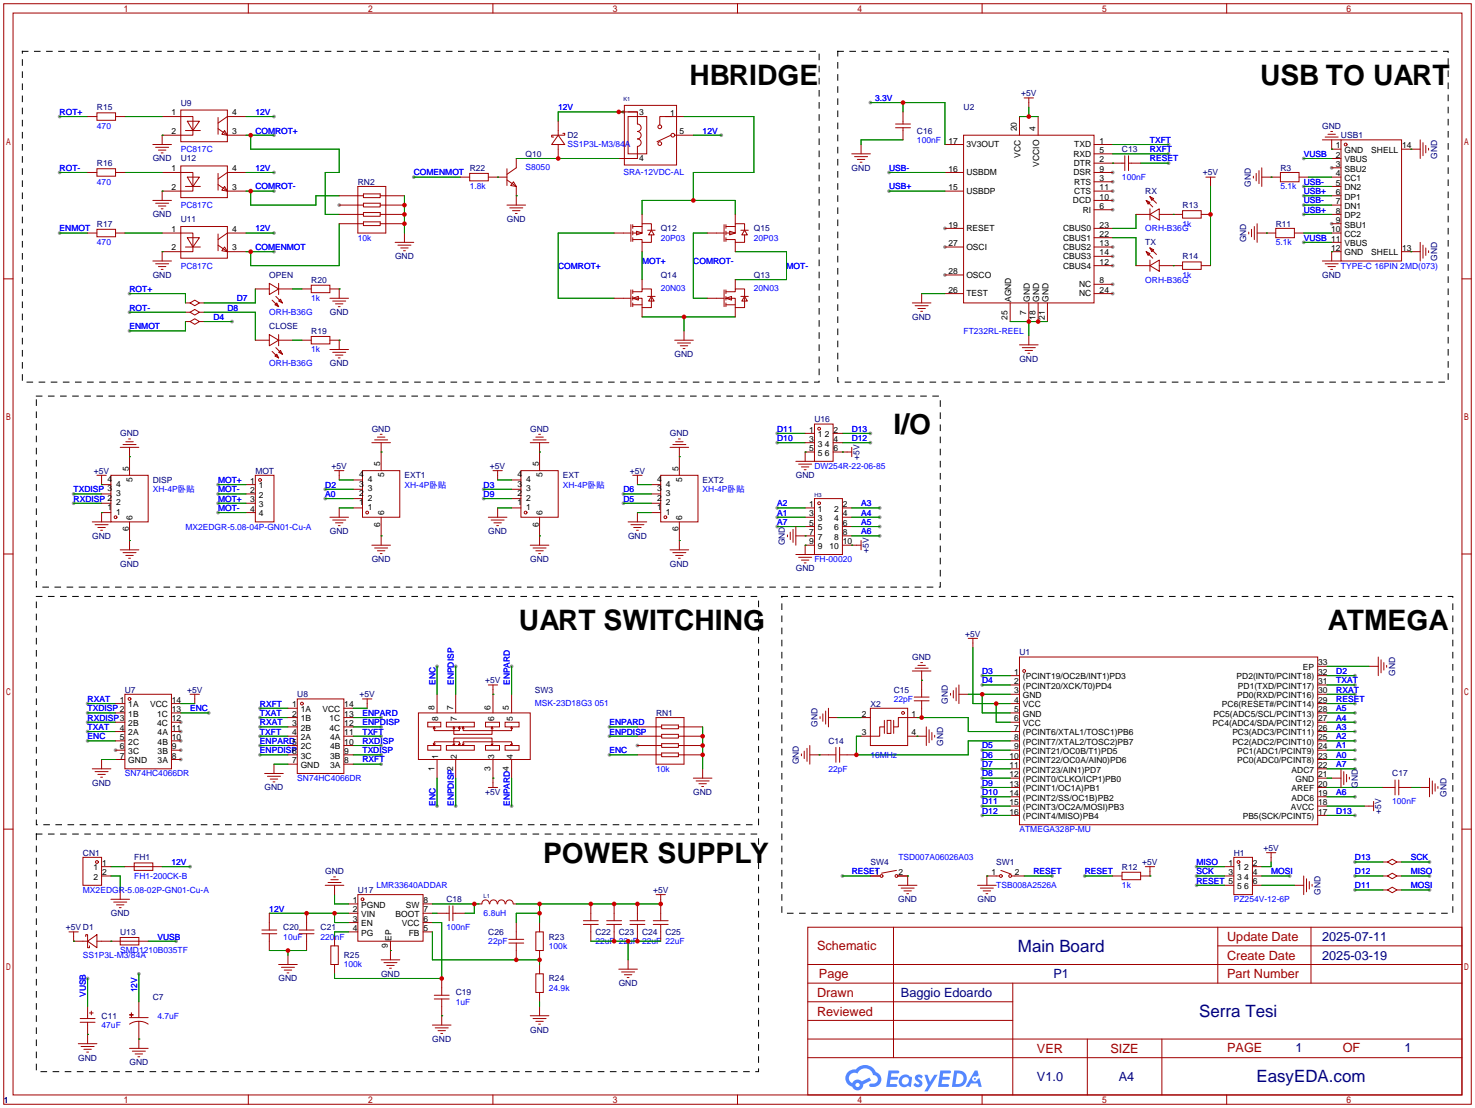
[picture p238: page 1]
