EdoardoBaggio03/ControlloSerra/PCB/PCB_PCB1_2026-03-13.pdf

+

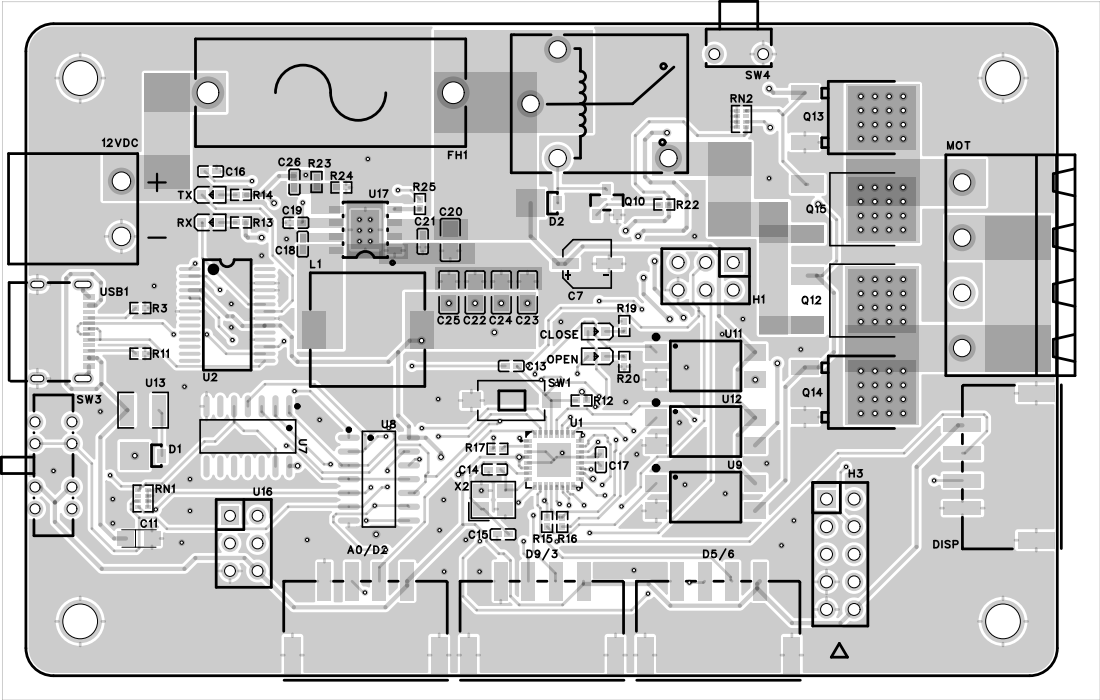
[picture p239: page 1]

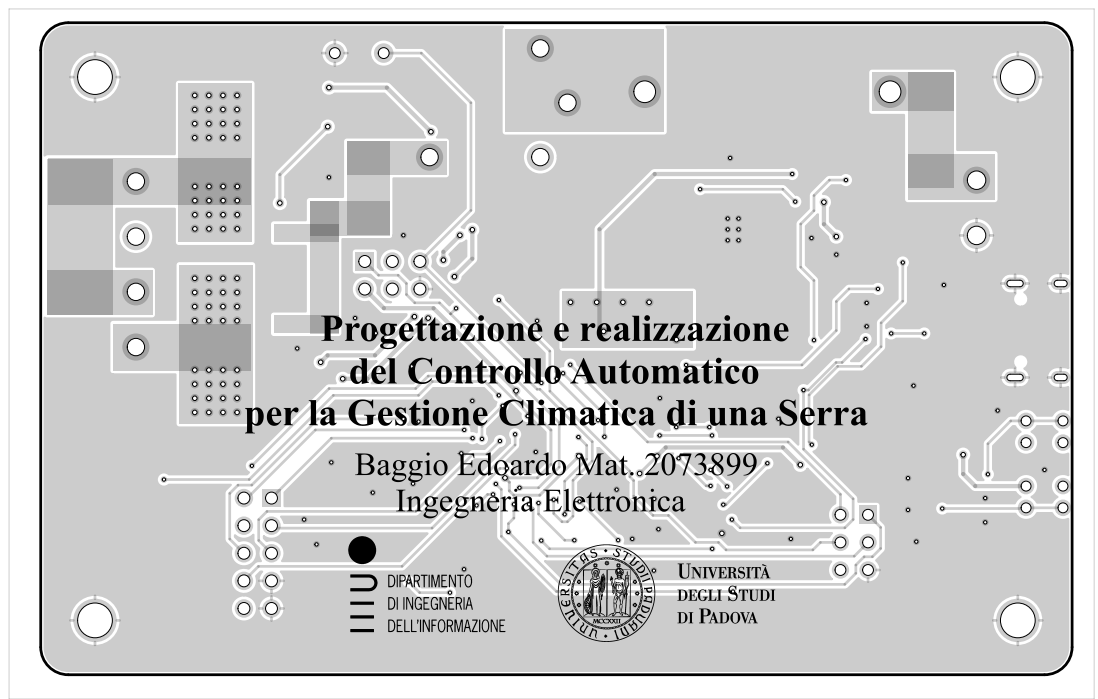
[picture p240: page 2]

Progettazione e realizzazione
del Controllo Automatico
per la Gestione Climatica di una Serra

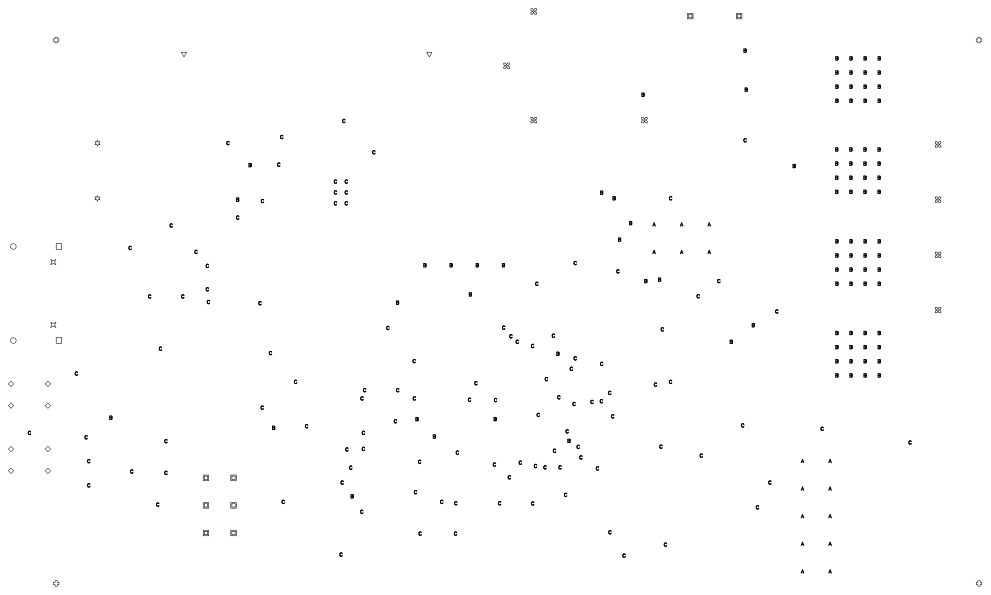
[picture p241: page 3]
