EdoardoBaggio03/ControlloSerra/PCB/VER 1/SCH_Main Board_2025-05-06.pdf

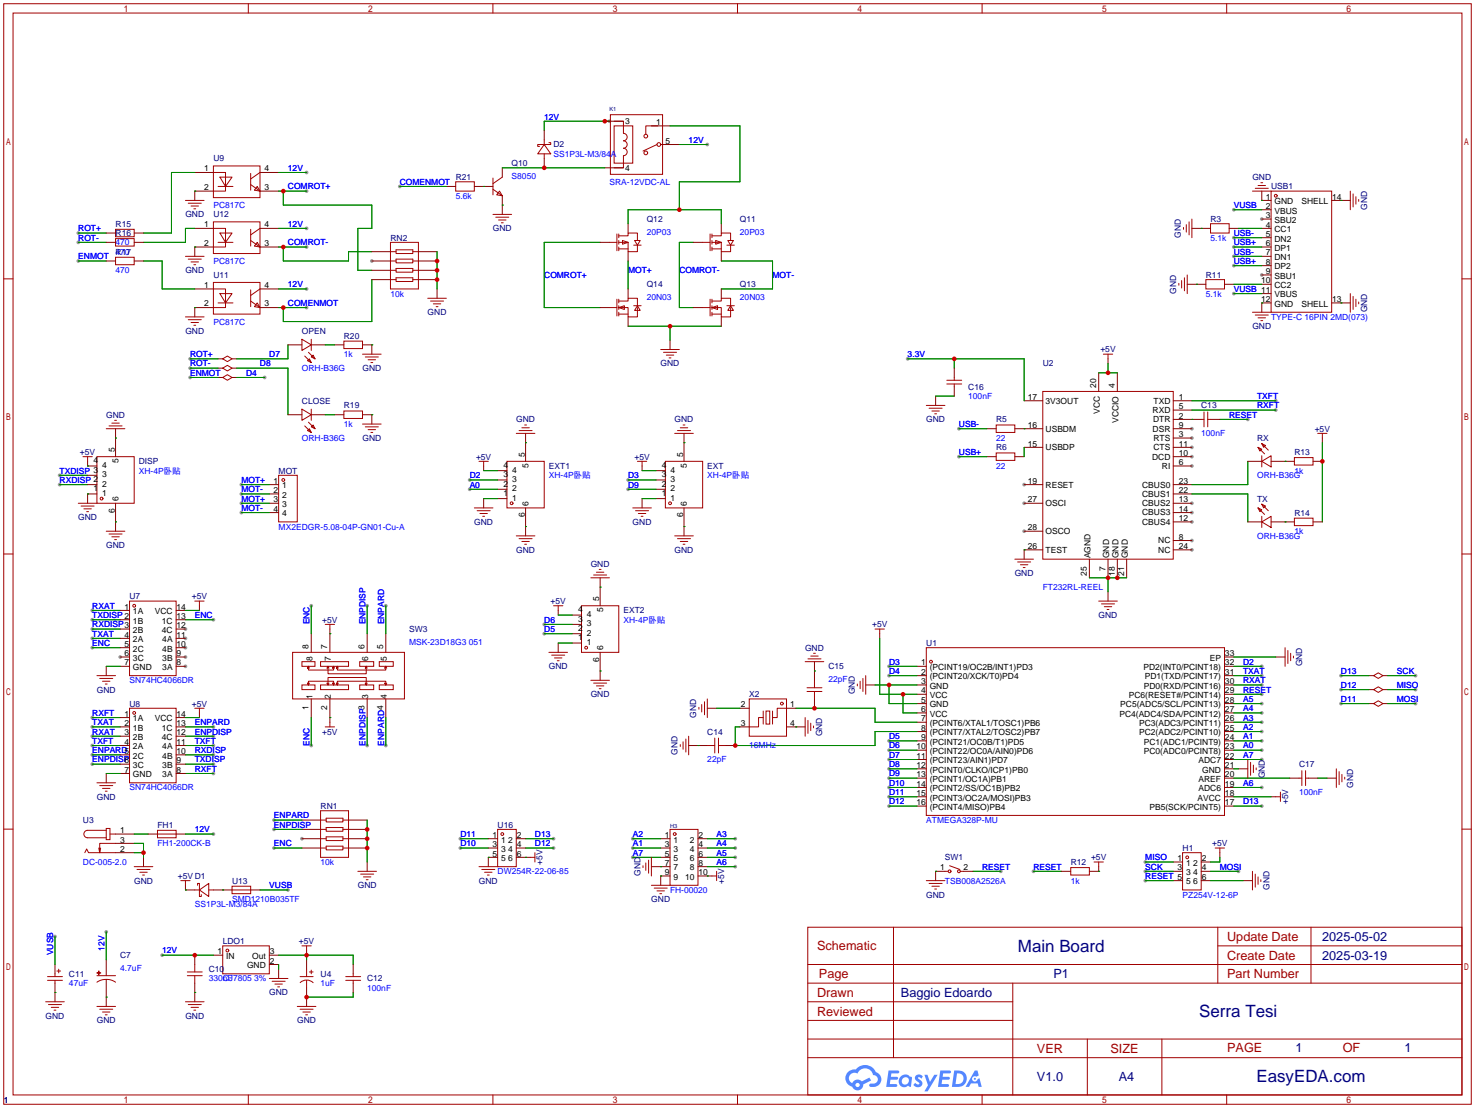
[picture p242: page 1]
