EdoardoBaggio03/ControlloSerra/Immagini Tesi/Foto/IMG_0023.jpeg

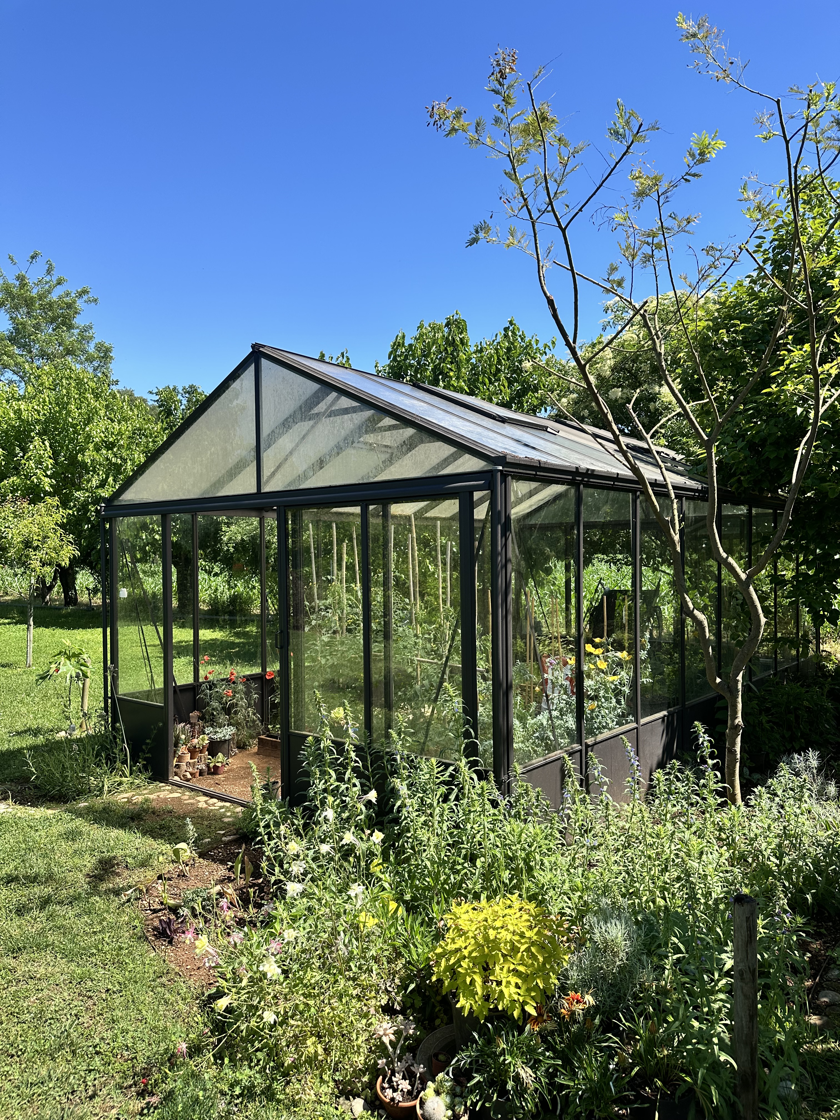
Immagini Tesi/Foto/IMG_0023.jpeg
