EdoardoBaggio03/ControlloSerra/Immagini Tesi/Foto/IMG_0025.jpeg

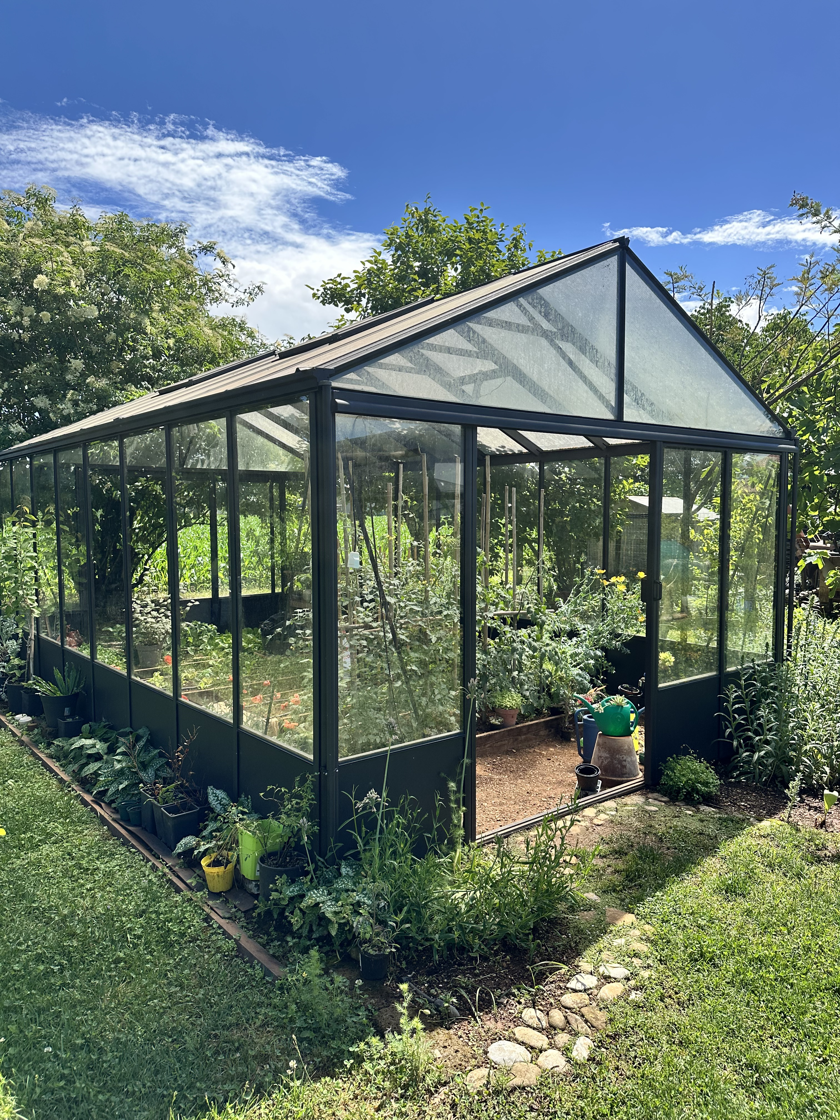
Immagini Tesi/Foto/IMG_0025.jpeg
